OutMyFocus/HomeLab/README.md

# HomeLab

Home projects.

- [`mtg-sorter/`](mtg-sorter/) — MTG card scanner and sorter
