OutMyFocus/HomeLab/mtg-sorter/hardware/img/enclosure_back.png

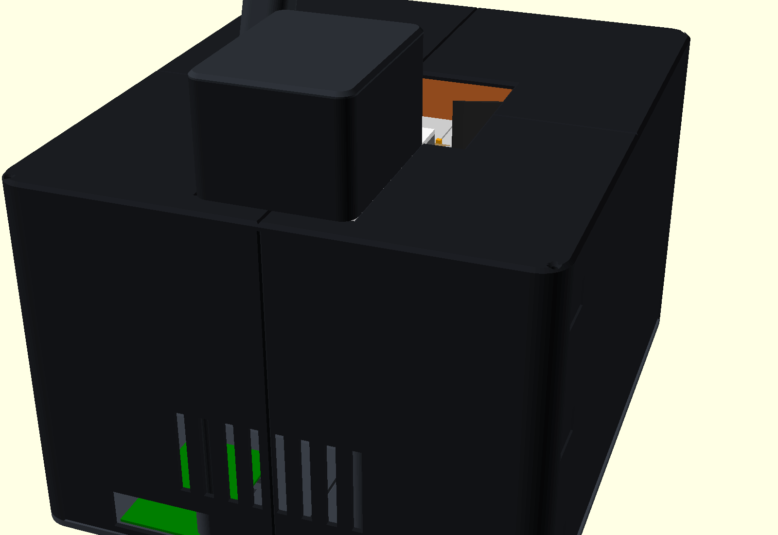
mtg-sorter/hardware/img/enclosure_back.png
