OutMyFocus/HomeLab/mtg-sorter/Card_Catalog_v1.2_All-in-one.3mf

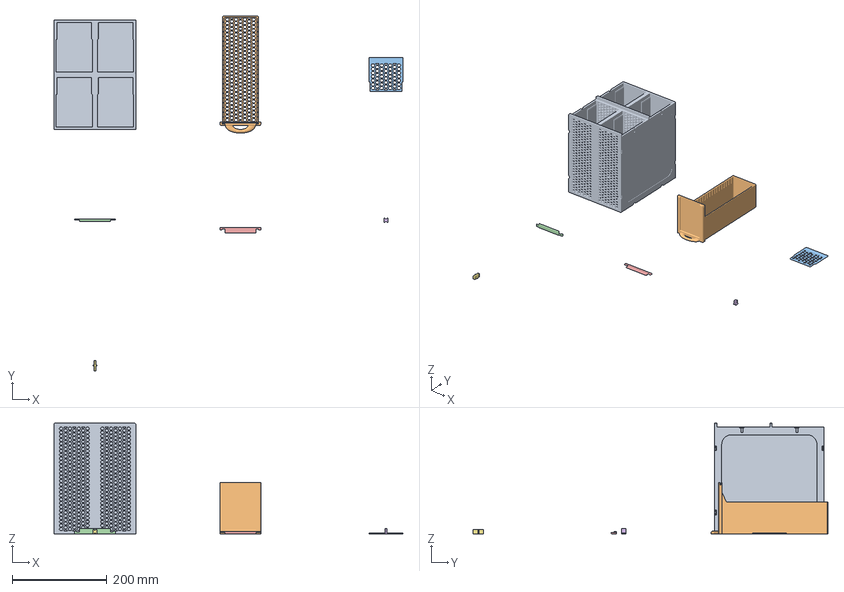
[picture p47: CAD file, 2026-11-01]
mtg-sorter/Card_Catalog_v1.2_All-in-one.3mf
736.9 x 748.8 x 234.1 mm
Card Catalog v1.0 box quad.stl
Card Catalog v1.2 drawer TEST.stl
Card Catalog v1.1 divider.stl
Card Catalog v1.1 drawer top.stl x 2
Card Catalog v1.0 connector thin.stl
Card Catalog v1.0 connector b2b thin.stl
