OutMyFocus/HomeLab/mtg-sorter/hardware/bambu/MTG_Sorter_Mk2.3mf

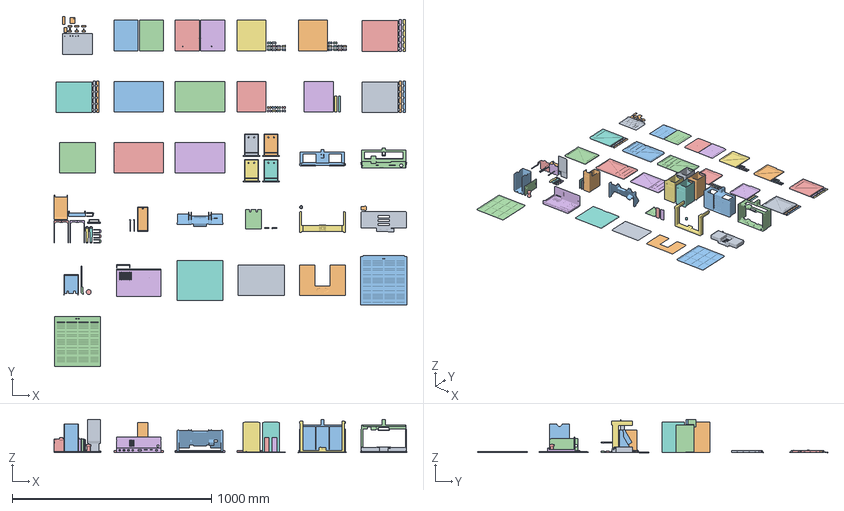
[picture p48: CAD file, 2026-11-10]
mtg-sorter/hardware/bambu/MTG_Sorter_Mk2.3mf
1769.3 x 1756.0 x 167.7 mm
mk2_coupon_plate
mk2_coupon_pieces
mk2_base_fl
mk2_base_fr
mk2_base_bl
mk2_base_br
mk2_wall_r00
mk2_key (1) x 3
mk2_key (2) x 3
mk2_key (3) x 3
mk2_key (4) x 3
mk2_key (5) x 3
mk2_key (6) x 3
mk2_key (7) x 3
mk2_key (8) x 3
mk2_key (9) x 2
mk2_key (10) x 2
mk2_wall_r10
mk2_wall_r01
mk2_trunk_lid (1) x 3
mk2_trunk_lid (2) x 3
mk2_wall_r11
mk2_wall_r02
mk2_wall_r12
mk2_wall_l00
mk2_wall_l10
mk2_branch_lid (1)
mk2_branch_lid (2)
mk2_wall_l01
mk2_wall_l11
mk2_wall_l02
mk2_wall_l12
mk2_bin (1)
mk2_bin (2)
mk2_bin (3)
mk2_bin (4)
mk2_lv2_frame
mk2_lv1_frame
mk2_carriage1
mk2_carriage2
mk2_lever (1)
mk2_lever (2)
mk2_col_front
mk2_liner_back
mk2_stop_bar
mk2_ir_holder (1)
mk2_ir_holder (2)
mk2_ir_holder (3)
mk2_ir_holder (4)
mk2_door (1)
mk2_door (2)
mk2_drawer
mk2_scan_carrier
mk2_scan_bed
mk2_lightbar (1)
mk2_lightbar (2)
mk2_cam_arch
mk2_cam_hood
mk2_fd_stand
mk2_fd_motor_lid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
