OutMyFocus/HomeLab/mtg-sorter/hardware/mk2/stl/mk2_lv1_frame.stl

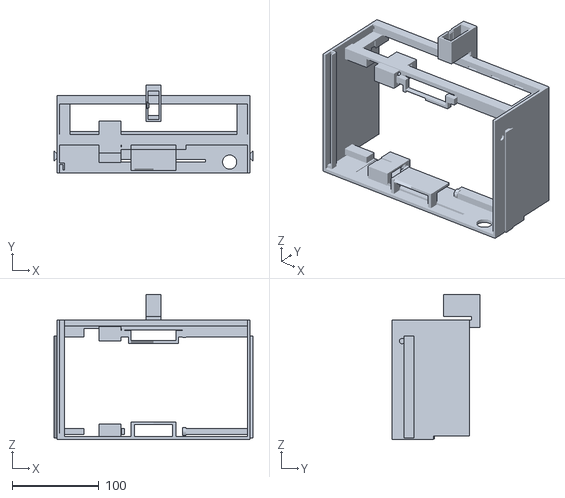
[picture p49: CAD file, 2026-11-09]
mtg-sorter/hardware/mk2/stl/mk2_lv1_frame.stl
230.0 x 101.5 x 167.7
