OutMyFocus/HomeLab/mtg-sorter/hardware/stl/enc_tower.stl

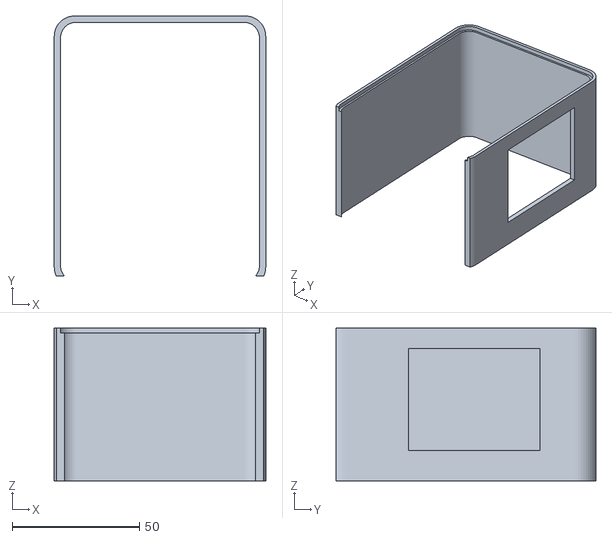
[picture p50: CAD file, 2026-11-08]
mtg-sorter/hardware/stl/enc_tower.stl
83.0 x 102.0 x 60.0
