OutMyFocus/HomeLab/mtg-sorter/hardware/bambu/MTG_Sorter_Feeder_Box_v4.3mf

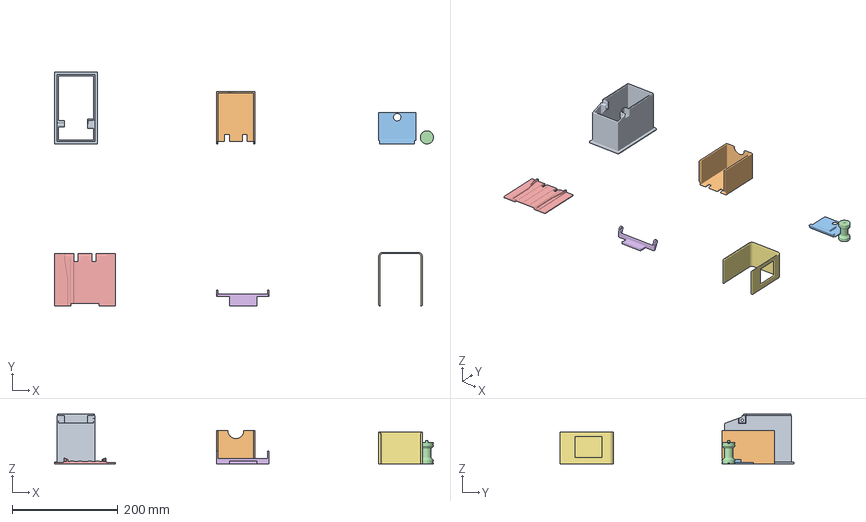
[picture p51: CAD file, 2026-11-08]
mtg-sorter/hardware/bambu/MTG_Sorter_Feeder_Box_v4.3mf
718.4 x 443.8 x 94.4 mm
feeder4_stand4
feeder4_hopper4
feeder4_shoe4
feeder4_roller4
bed_chute_bed_plate3
bed_chute_stop_gate3
enc_tower
