OutMyFocus/HomeLab/mtg-sorter/hardware/mk2/stl/mk2_coupon_plate.stl

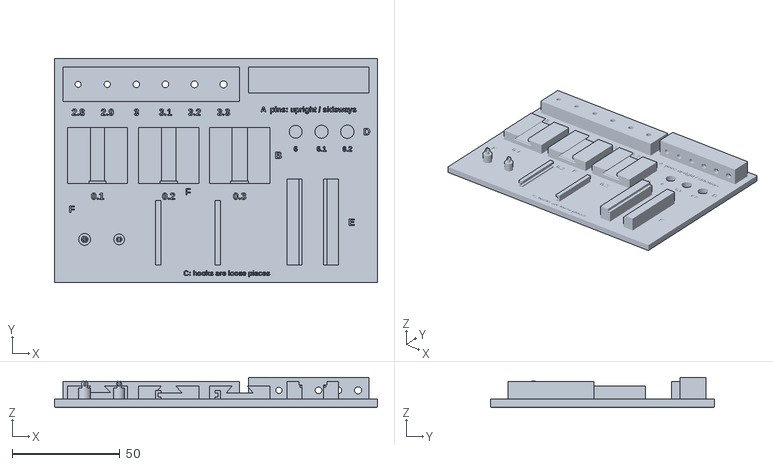
[picture p52: CAD file, 2026-11-09]
mtg-sorter/hardware/mk2/stl/mk2_coupon_plate.stl
150.0 x 104.0 x 14.0
