OutMyFocus/HomeLab/mtg-sorter/hardware/stl/feeder4_stand4.stl

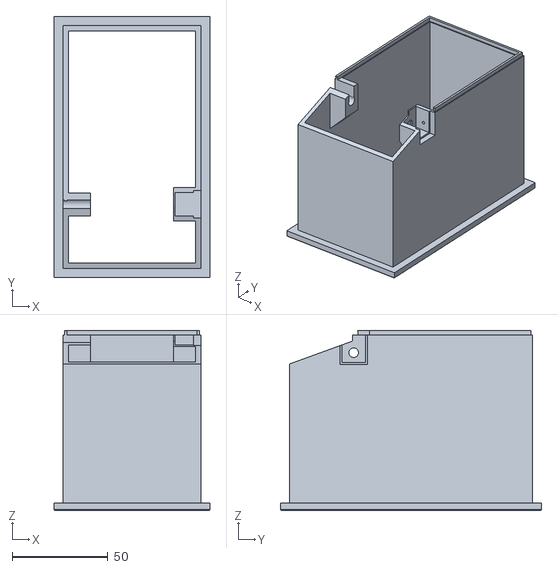
[picture p53: CAD file, 2026-11-08]
mtg-sorter/hardware/stl/feeder4_stand4.stl
81.6 x 136.6 x 94.4
