OutMyFocus/HomeLab/mtg-sorter/hardware/bambu/MTG_Sorter_Enclosure.3mf

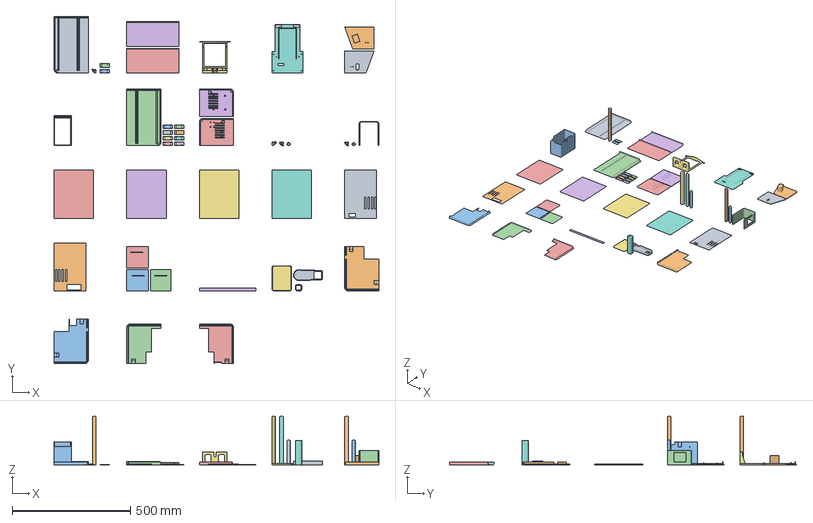
[picture p54: CAD file, 2026-11-08]
mtg-sorter/hardware/bambu/MTG_Sorter_Enclosure.3mf
1374.5 x 1468.8 x 206.5 mm
enc_floor_fl
enc_post_front
enc_splice (1) x 2
enc_splice (2) x 2
enc_divider (1)
enc_divider (2)
enc_bridge_front
enc_bridge_back
bed_chute_bed_side_left_enclosure
bed_chute_bed_side_right_enclosure
feeder_stand_mid
enc_floor_fr
enc_splice (3)
enc_splice (4)
enc_splice (5)
enc_splice (6)
enc_splice (7)
enc_splice (8)
enc_floor_bl
enc_floor_br
enc_post_front_r
enc_post_back x 2
enc_leg x 2
enc_tower
enc_side x 4
enc_back_l
enc_back_r
enc_fascia_l
enc_fascia_m
enc_fascia_r
enc_light_bar
enc_tower_lid
enc_post_sleeve
enc_head_cover
enc_deck_fl
enc_deck_fr
enc_deck_bl
enc_deck_br
