OutMyFocus/HomeLab/mtg-sorter/hardware/mk2/stl/mk2_etray.stl

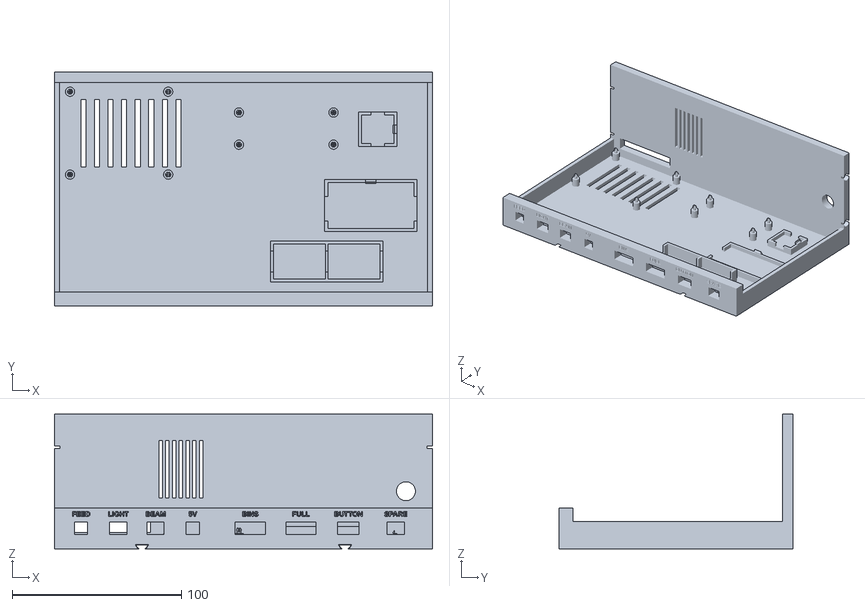
[picture p55: CAD file, 2026-11-09]
mtg-sorter/hardware/mk2/stl/mk2_etray.stl
223.4 x 138.0 x 79.5
