OutMyFocus/HomeLab/mtg-sorter/hardware/stl/feeder4_hopper4.stl

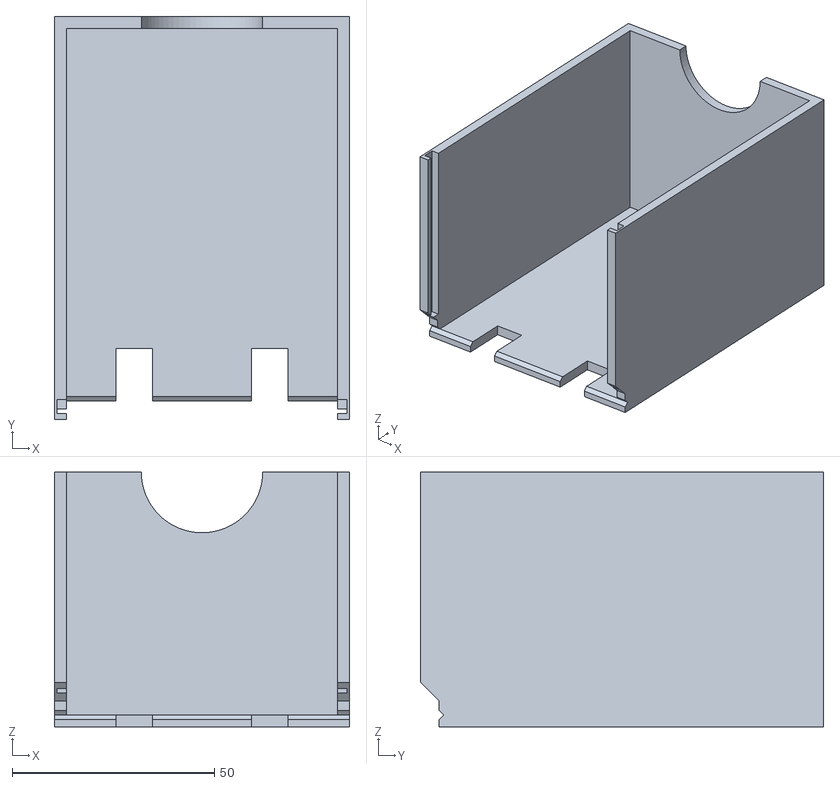
[picture p56: CAD file, 2026-11-08]
mtg-sorter/hardware/stl/feeder4_hopper4.stl
73.0 x 99.6 x 63.0
