OutMyFocus/HomeLab/mtg-sorter/hardware/bambu/MTG_Sorter_Scan_Bed_v3.3mf

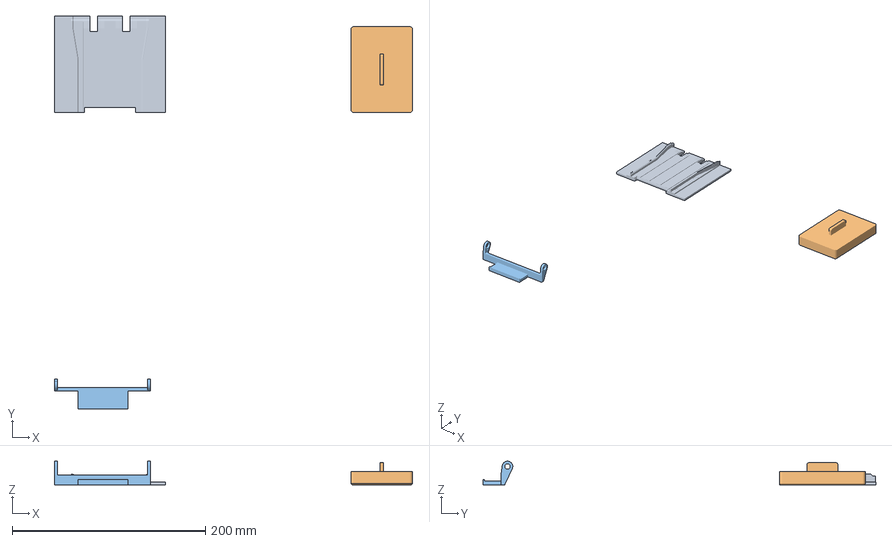
[picture p57: CAD file, 2026-11-08]
mtg-sorter/hardware/bambu/MTG_Sorter_Scan_Bed_v3.3mf
371.2 x 407.2 x 24.5 mm
bed_chute_bed_plate3
feeder_weight_solid
bed_chute_stop_gate3
