OutMyFocus/HomeLab/mtg-sorter/hardware/mk2/stl/mk2_fd_stand.stl

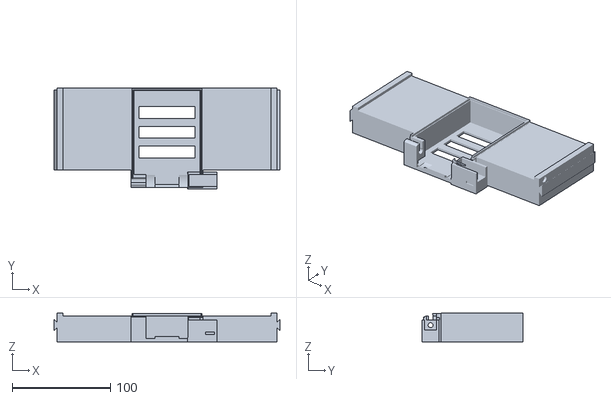
[picture p58: CAD file, 2026-11-09]
mtg-sorter/hardware/mk2/stl/mk2_fd_stand.stl
230.0 x 102.7 x 29.2
