OutMyFocus/HomeLab/mtg-sorter/hardware/stl/feeder4_shoe4.stl

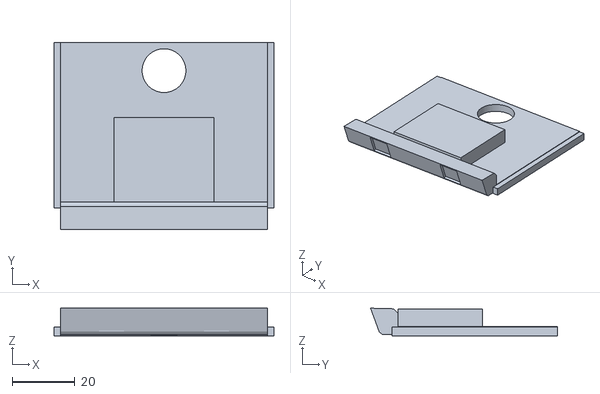
[picture p59: CAD file, 2026-11-08]
mtg-sorter/hardware/stl/feeder4_shoe4.stl
70.4 x 59.8 x 8.86
