OutMyFocus/HomeLab/mtg-sorter/hardware/bambu/MTG_Sorter_DC_Jack_Holder.3mf

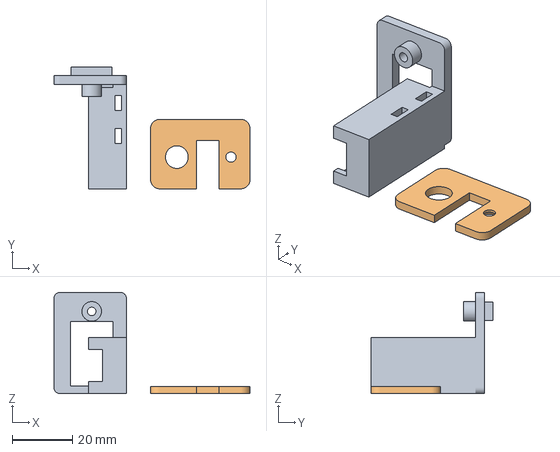
[picture p60: CAD file, 2026-11-06]
mtg-sorter/hardware/bambu/MTG_Sorter_DC_Jack_Holder.3mf
65.0 x 40.3 x 33.5 mm
dc_jack_holder
dc_jack_bezel
