OutMyFocus/HomeLab/mtg-sorter/hardware/mk2/stl/mk2_lv2_frame.stl

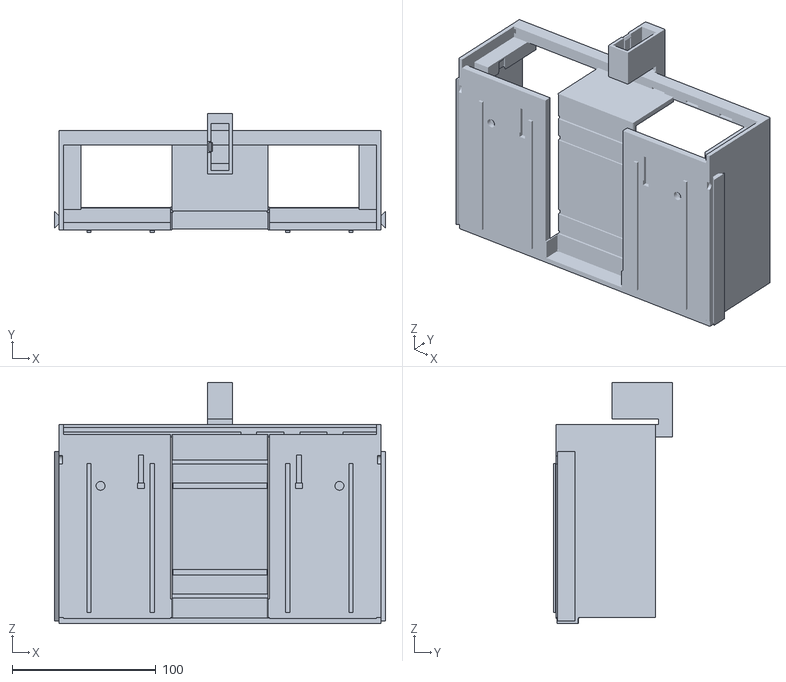
[picture p61: CAD file, 2026-11-09]
mtg-sorter/hardware/mk2/stl/mk2_lv2_frame.stl
230.0 x 83.0 x 167.7
