OutMyFocus/HomeLab/mtg-sorter/hardware/stl/bed_chute_stop_gate3.stl

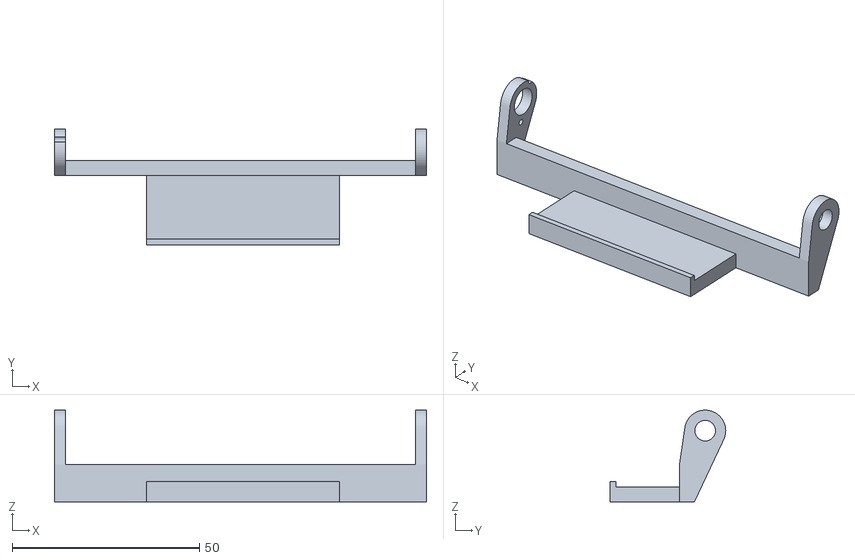
[picture p62: CAD file, 2026-11-08]
mtg-sorter/hardware/stl/bed_chute_stop_gate3.stl
99.4 x 30.9 x 24.5
