OutMyFocus/HomeLab/mtg-sorter/hardware/bambu/MTG_Sorter_Chute_v3.3mf

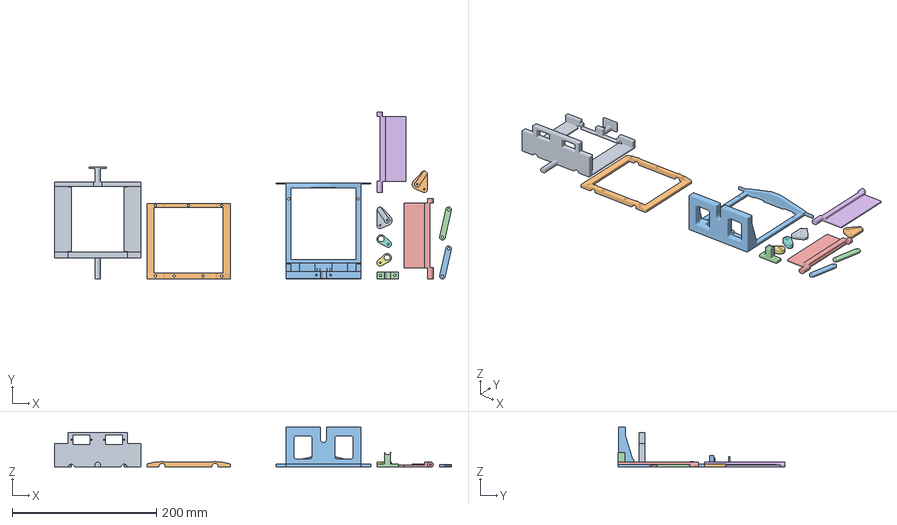
[picture p63: CAD file, 2026-11-04]
mtg-sorter/hardware/bambu/MTG_Sorter_Chute_v3.3mf
550.8 x 231.7 x 55.0 mm
bed_chute_chute3
bed_chute_hinge_frame3
enc_bridge_front
enc_bridge_cap
bed_chute_door3
bed_chute_door3_left
bed_chute_door_crank3
bed_chute_door_crank3_left
bed_chute_servo_crank3
bed_chute_servo_crank3_left
bed_chute_door_link3 (1)
bed_chute_door_link3 (2)
