OutMyFocus/HomeLab/mtg-sorter/hardware/mk2/stl/mk2_fd_hopper.stl

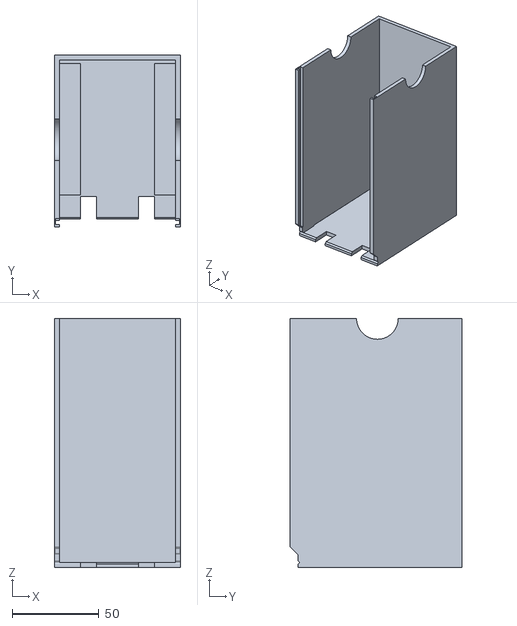
[picture p64: CAD file, 2026-11-09]
mtg-sorter/hardware/mk2/stl/mk2_fd_hopper.stl
73.0 x 99.6 x 143.9
