OutMyFocus/HomeLab/mtg-sorter/hardware/stl/feeder4_roller4.stl

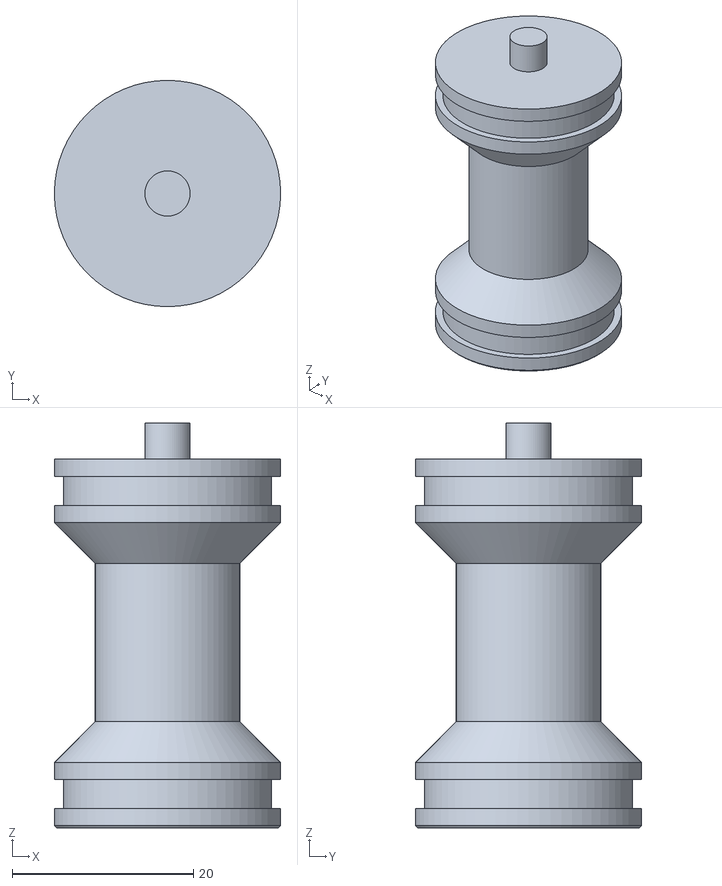
[picture p65: CAD file, 2026-11-08]
mtg-sorter/hardware/stl/feeder4_roller4.stl
25.0 x 25.0 x 44.8
