OutMyFocus/HomeLab/mtg-sorter/hardware/bambu/MTG_Sorter_Feeder_And_Bed_v2.3mf

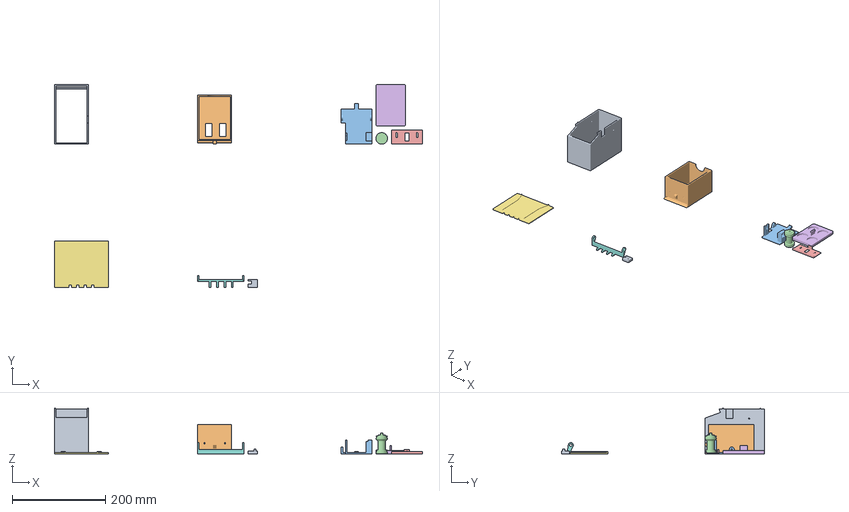
[picture p66: CAD file, 2026-11-04]
mtg-sorter/hardware/bambu/MTG_Sorter_Feeder_And_Bed_v2.3mf
789.4 x 435.2 x 98.5 mm
feeder_stand_mid
feeder_hopper
feeder_arm
feeder_roller
feeder_gate
feeder_weight
bed_chute_bed_plate
bed_chute_stop_gate
bed_chute_gate_bearing
