OutMyFocus/HomeLab/mtg-sorter/hardware/mk2/stl/mk2_drawer.stl

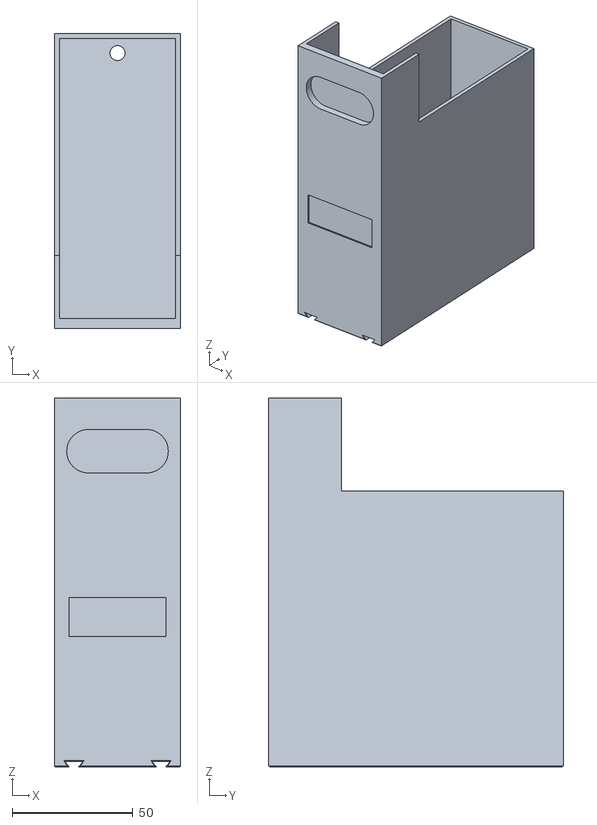
[picture p67: CAD file, 2026-11-09]
mtg-sorter/hardware/mk2/stl/mk2_drawer.stl
52.1 x 121.8 x 152.5
