OutMyFocus/HomeLab/mtg-sorter/hardware/stl/bed_chute_bed_plate3.stl

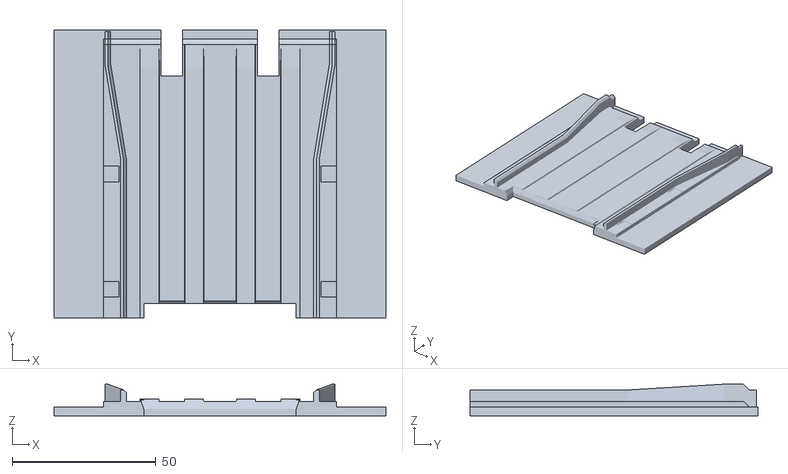
[picture p68: CAD file, 2026-11-08]
mtg-sorter/hardware/stl/bed_chute_bed_plate3.stl
115.4 x 100.0 x 11.0
