OutMyFocus/HomeLab/mtg-sorter/hardware/mk2/stl/mk2_wall_l11.stl

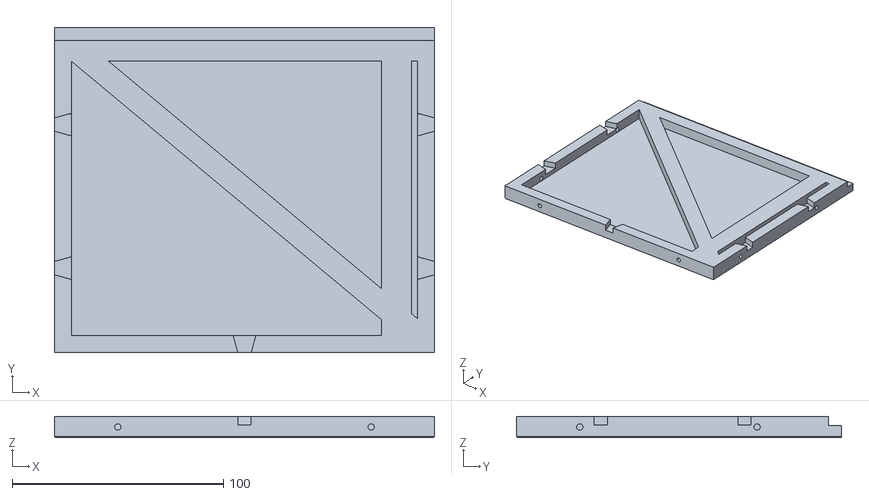
[picture p69: CAD file, 2026-11-09]
mtg-sorter/hardware/mk2/stl/mk2_wall_l11.stl
180.0 x 154.0 x 10.0
