OutMyFocus/HomeLab/mtg-sorter/hardware/stl/feeder_weight_solid.stl

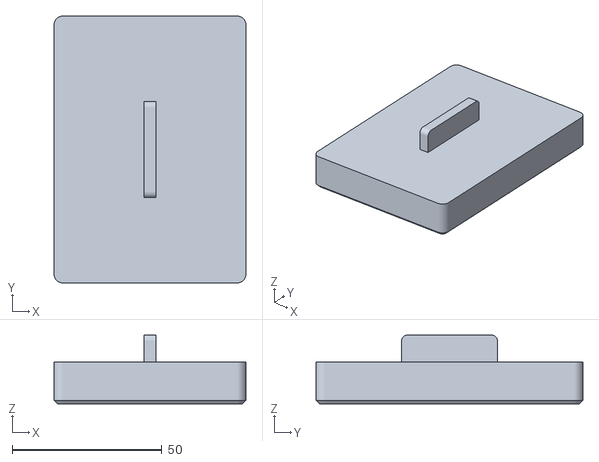
[picture p70: CAD file, 2026-11-07]
mtg-sorter/hardware/stl/feeder_weight_solid.stl
64.0 x 89.0 x 23.0
