OutMyFocus/HomeLab/mtg-sorter/hardware/stl/dc_jack_holder.stl

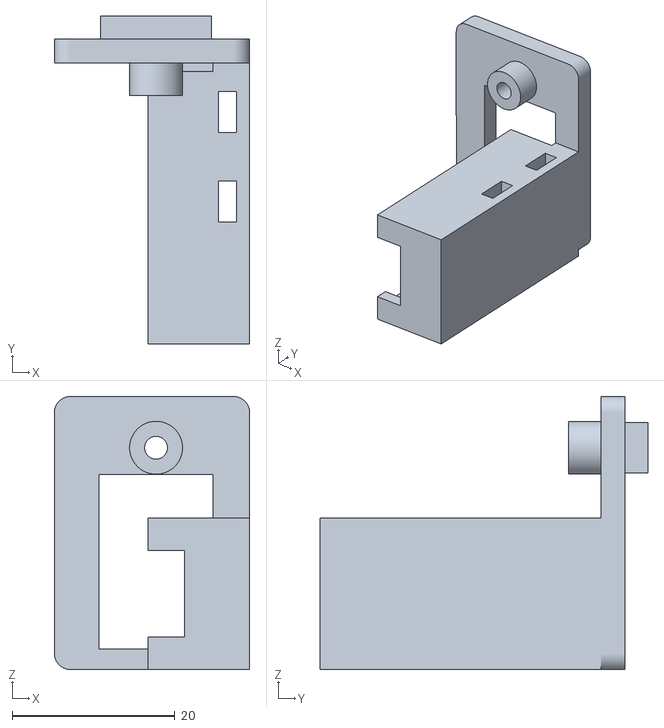
[picture p71: CAD file, 2026-11-06]
mtg-sorter/hardware/stl/dc_jack_holder.stl
24.0 x 40.3 x 33.5
