OutMyFocus/HomeLab/mtg-sorter/hardware/stl/dc_jack_bezel.stl

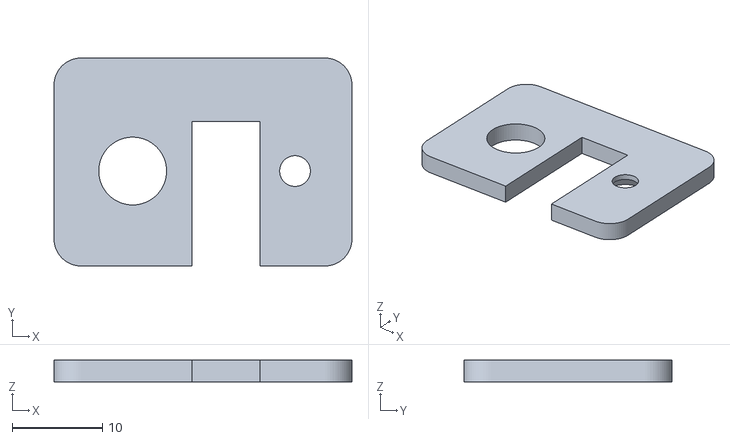
[picture p73: CAD file, 2026-11-06]
mtg-sorter/hardware/stl/dc_jack_bezel.stl
32.9 x 23.0 x 2.40
