OutMyFocus/HomeLab/mtg-sorter/hardware/stl/bed_chute_door_crank3.stl

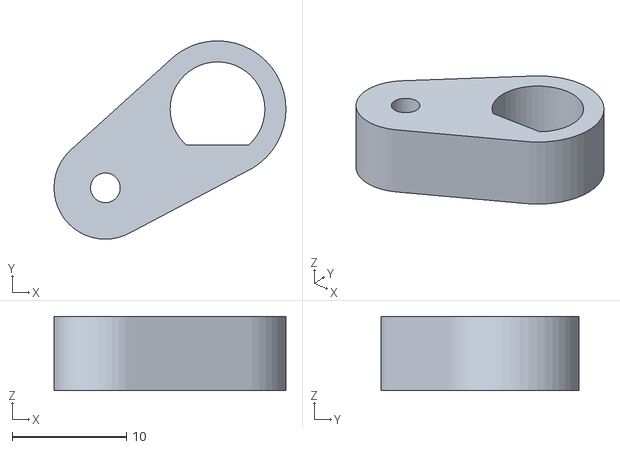
[picture p75: CAD file, 2026-11-04]
mtg-sorter/hardware/stl/bed_chute_door_crank3.stl
20.3 x 17.4 x 6.50
