OutMyFocus/HomeLab/mtg-sorter/hardware/stl/bed_chute_bed_plate.stl

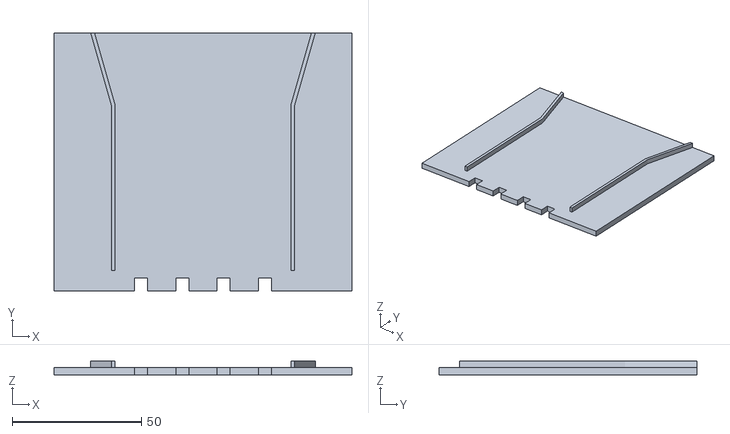
[picture p76: CAD file, 2026-11-04]
mtg-sorter/hardware/stl/bed_chute_bed_plate.stl
115.4 x 100.0 x 5.50
