OutMyFocus/HomeLab/mtg-sorter/hardware/mk2/stl/mk2_fd_motor_lid.stl

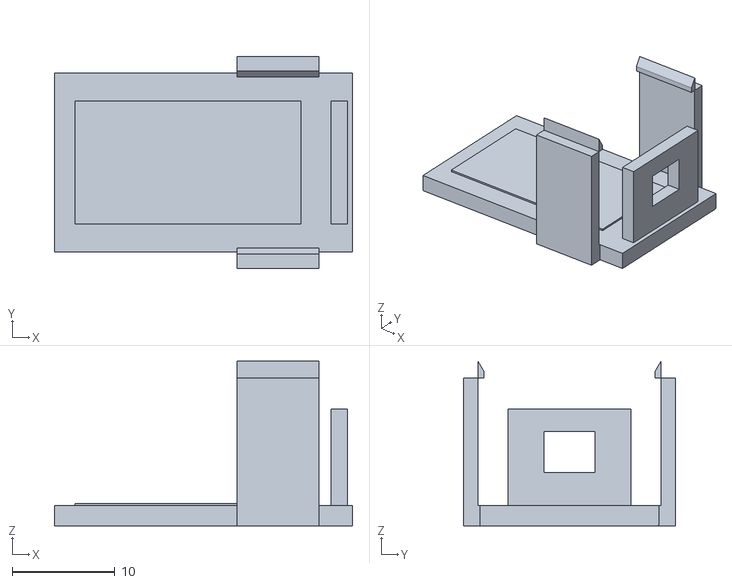
[picture p77: CAD file, 2026-11-09]
mtg-sorter/hardware/mk2/stl/mk2_fd_motor_lid.stl
29.0 x 20.6 x 16.0
