OutMyFocus/HomeLab/mtg-sorter/hardware/mk2/stl/mk2_col_front.stl

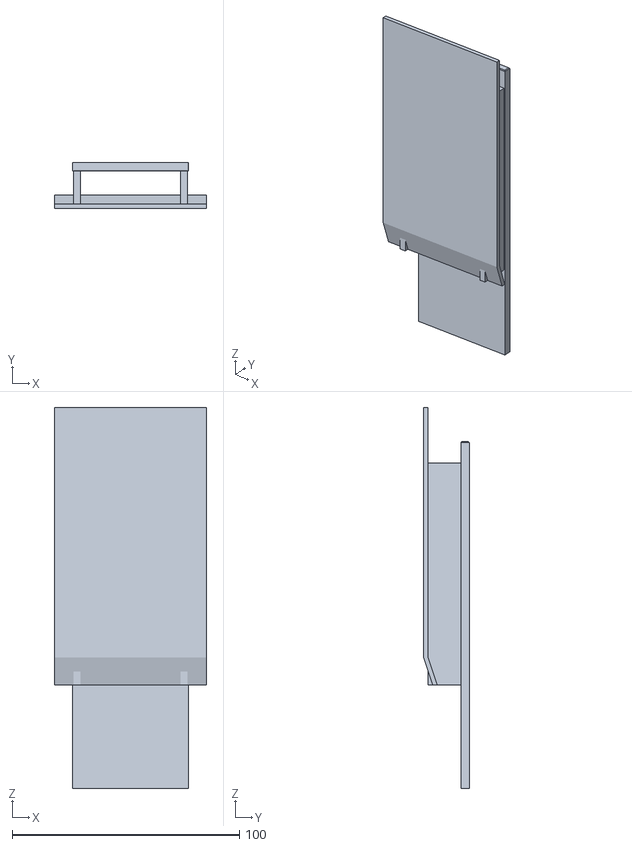
[picture p78: CAD file, 2026-11-09]
mtg-sorter/hardware/mk2/stl/mk2_col_front.stl
67.0 x 20.2 x 167.5
