OutMyFocus/HomeLab/mtg-sorter/hardware/stl/feeder_gate.stl

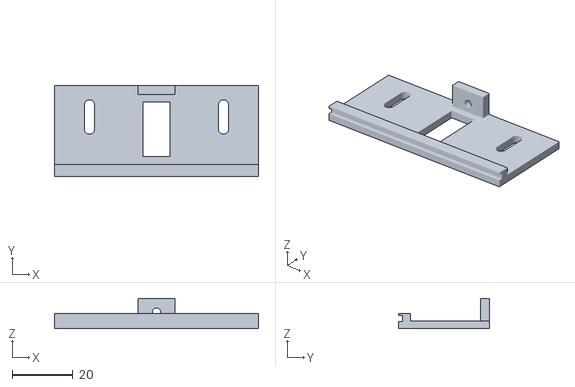
[picture p79: CAD file, 2026-11-04]
mtg-sorter/hardware/stl/feeder_gate.stl
67.0 x 30.0 x 10.0
