OutMyFocus/HomeLab/mtg-sorter/hardware/mk2/stl/mk2_fd_shoe.stl

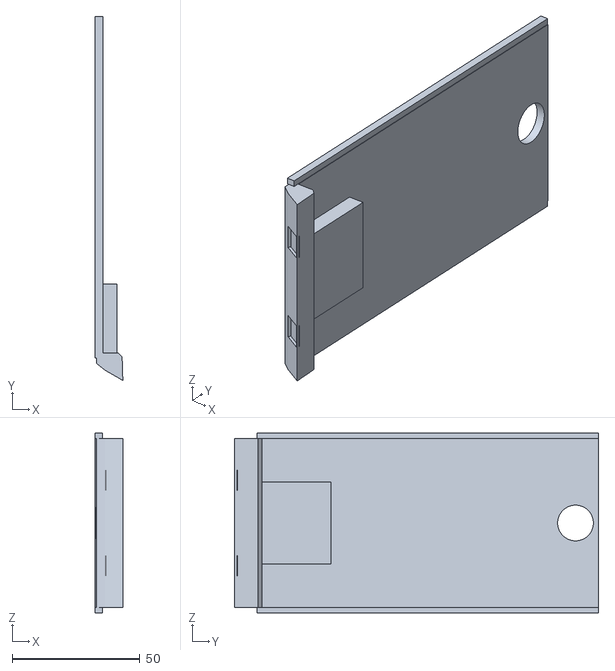
[picture p80: CAD file, 2026-11-09]
mtg-sorter/hardware/mk2/stl/mk2_fd_shoe.stl
10.9 x 142.6 x 70.4
