OutMyFocus/HomeLab/mtg-sorter/hardware/stl/feeder_roller.stl

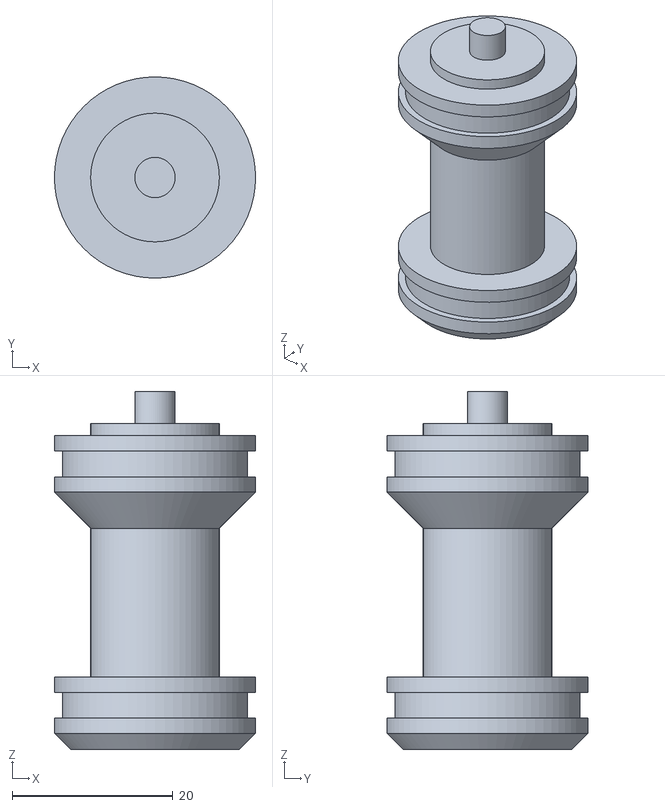
[picture p81: CAD file, 2026-11-04]
mtg-sorter/hardware/stl/feeder_roller.stl
25.0 x 25.0 x 44.5
