OutMyFocus/HomeLab/mtg-sorter/hardware/mk2/stl/mk2_back_high.stl

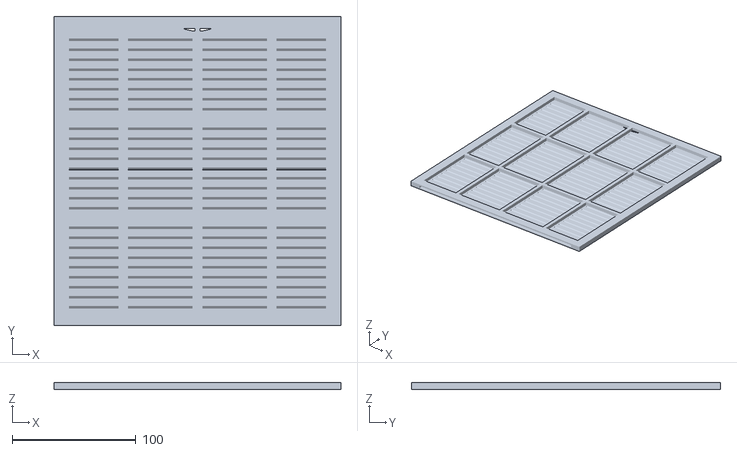
[picture p82: CAD file, 2026-11-09]
mtg-sorter/hardware/mk2/stl/mk2_back_high.stl
232.0 x 250.0 x 5.70
