OutMyFocus/HomeLab/mtg-sorter/hardware/stl/bed_chute_door_link3.stl

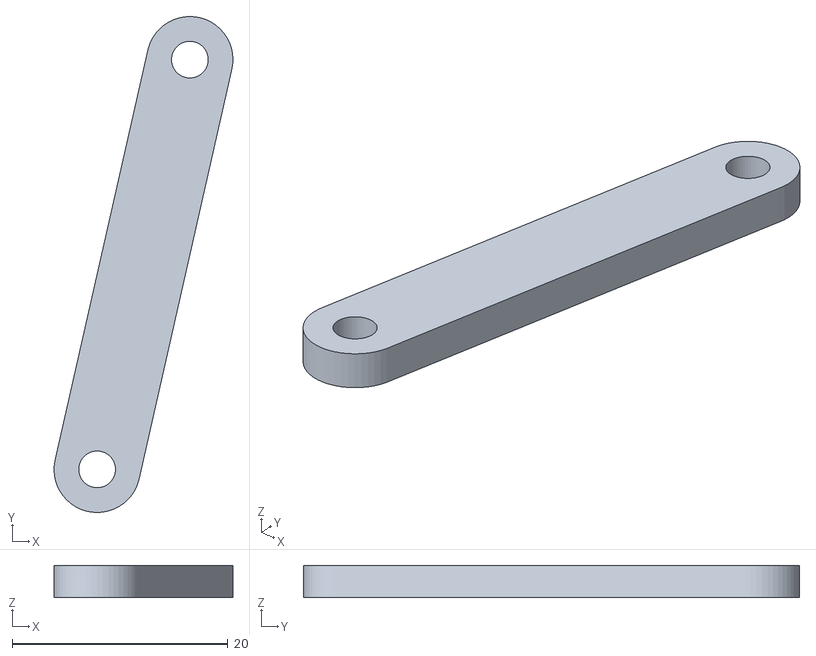
[picture p83: CAD file, 2026-11-04]
mtg-sorter/hardware/stl/bed_chute_door_link3.stl
16.6 x 46.0 x 3.00
