OutMyFocus/HomeLab/mtg-sorter/hardware/mk2/stl/mk2_base_fl.stl

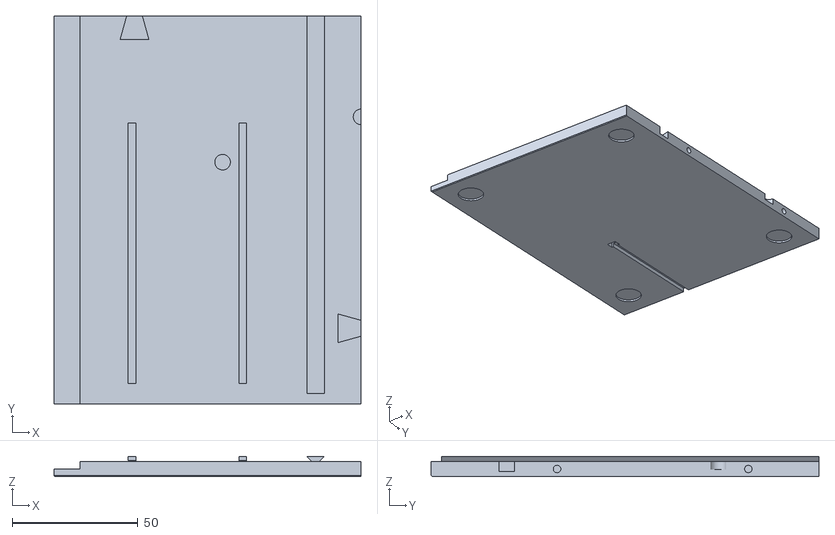
[picture p84: CAD file, 2026-11-09]
mtg-sorter/hardware/mk2/stl/mk2_base_fl.stl
122.0 x 154.0 x 7.99
