OutMyFocus/HomeLab/mtg-sorter/hardware/stl/bed_chute_servo_crank3_left.stl

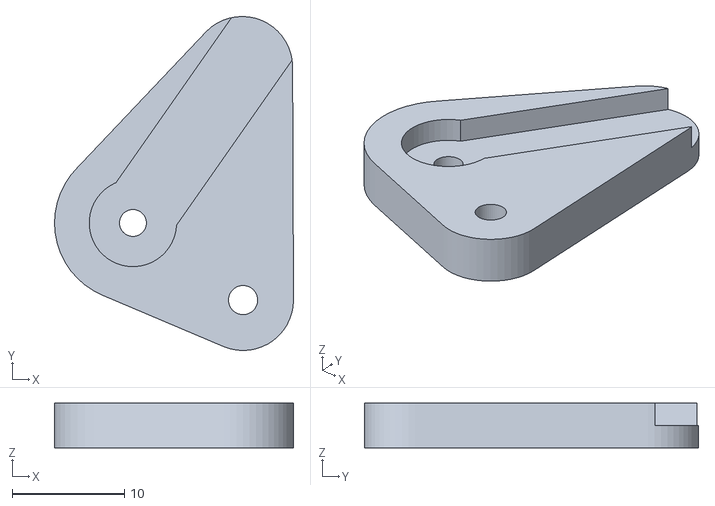
[picture p85: CAD file, 2026-11-04]
mtg-sorter/hardware/stl/bed_chute_servo_crank3_left.stl
21.3 x 29.8 x 4.00
