OutMyFocus/HomeLab/mtg-sorter/hardware/mk2/stl/mk2_scan_bed.stl

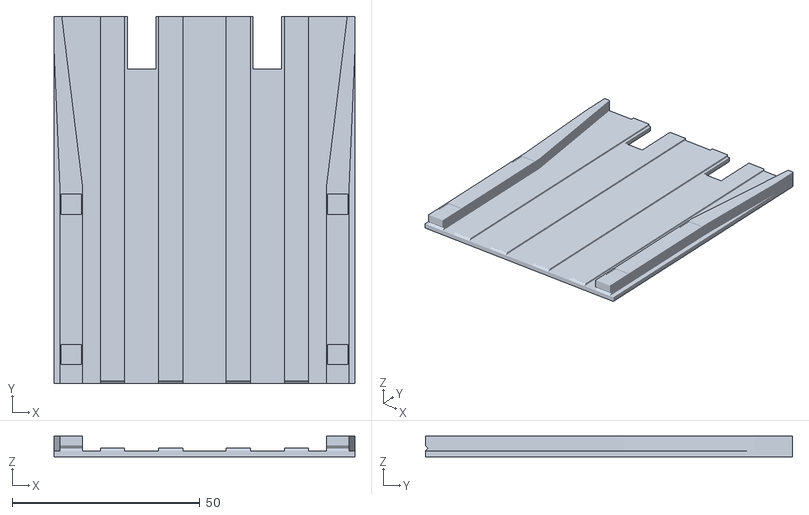
[picture p86: CAD file, 2026-11-09]
mtg-sorter/hardware/mk2/stl/mk2_scan_bed.stl
80.0 x 97.7 x 5.59
