OutMyFocus/HomeLab/mtg-sorter/hardware/stl/enc_bridge_front.stl

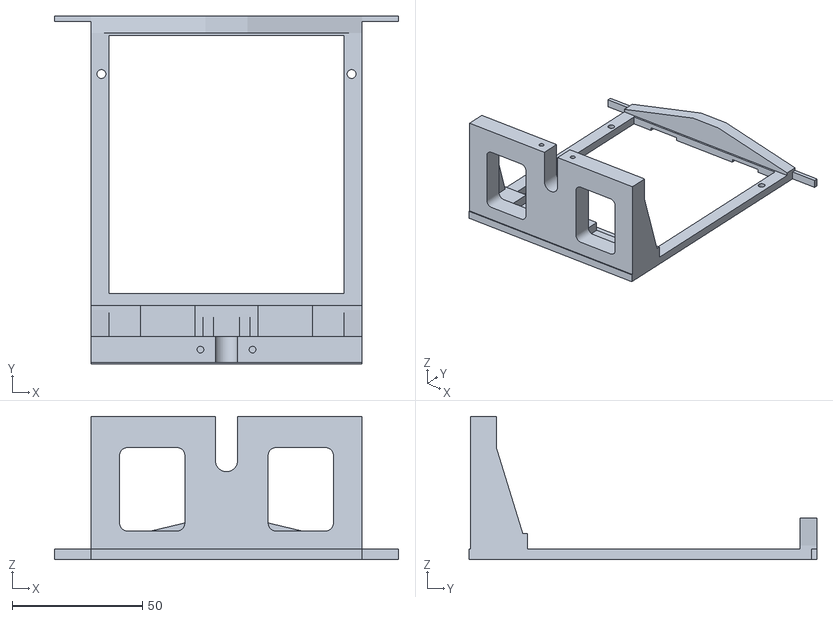
[picture p87: CAD file, 2026-11-04]
mtg-sorter/hardware/stl/enc_bridge_front.stl
132.0 x 133.5 x 55.0
