OutMyFocus/HomeLab/mtg-sorter/hardware/mk2/stl/mk2_lever.stl

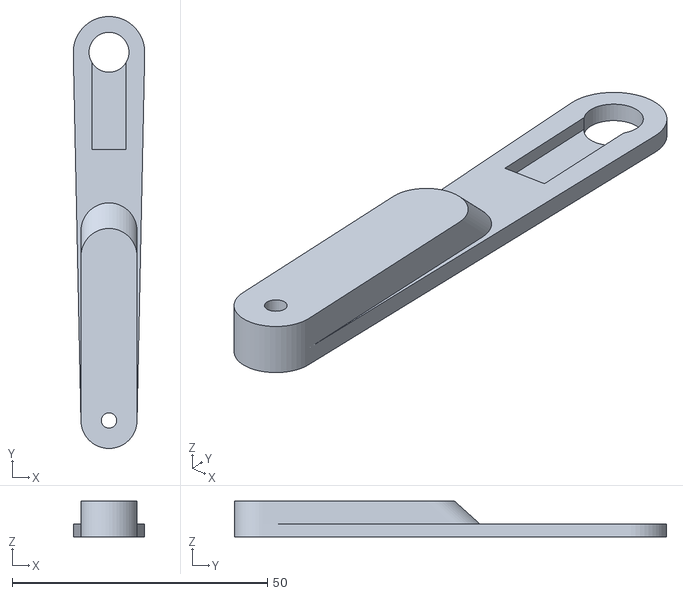
[picture p88: CAD file, 2026-11-09]
mtg-sorter/hardware/mk2/stl/mk2_lever.stl
14.0 x 84.6 x 7.00
