OutMyFocus/HomeLab/mtg-sorter/hardware/stl/feeder_stand_mid.stl

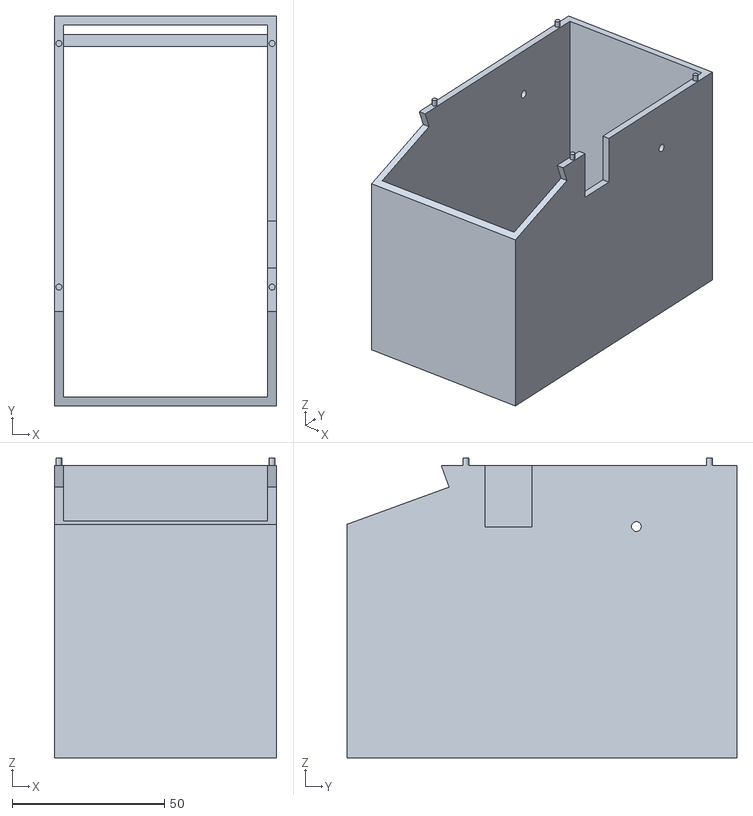
[picture p89: CAD file, 2026-11-04]
mtg-sorter/hardware/stl/feeder_stand_mid.stl
73.0 x 128.0 x 98.5
