OutMyFocus/HomeLab/mtg-sorter/hardware/mk2/stl/mk2_cam_hood.stl

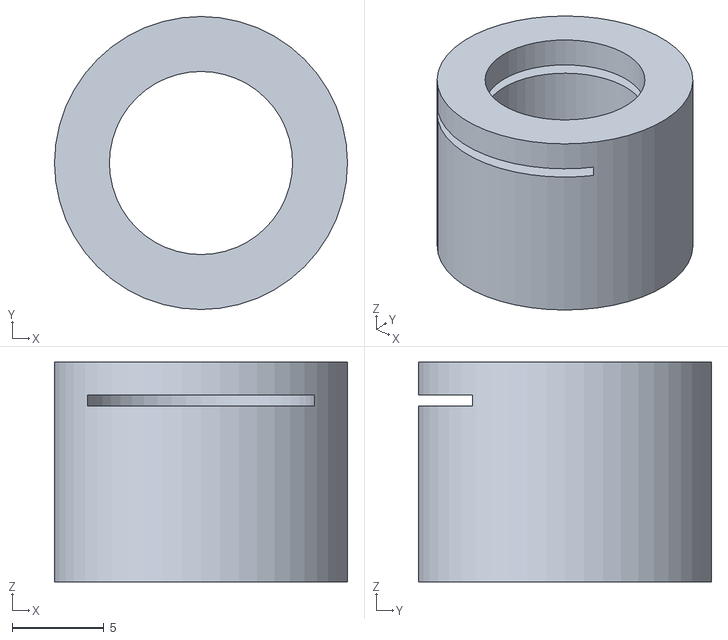
[picture p90: CAD file, 2026-11-09]
mtg-sorter/hardware/mk2/stl/mk2_cam_hood.stl
16.0 x 16.0 x 12.0
