OutMyFocus/HomeLab/mtg-sorter/hardware/stl/feeder_arm.stl

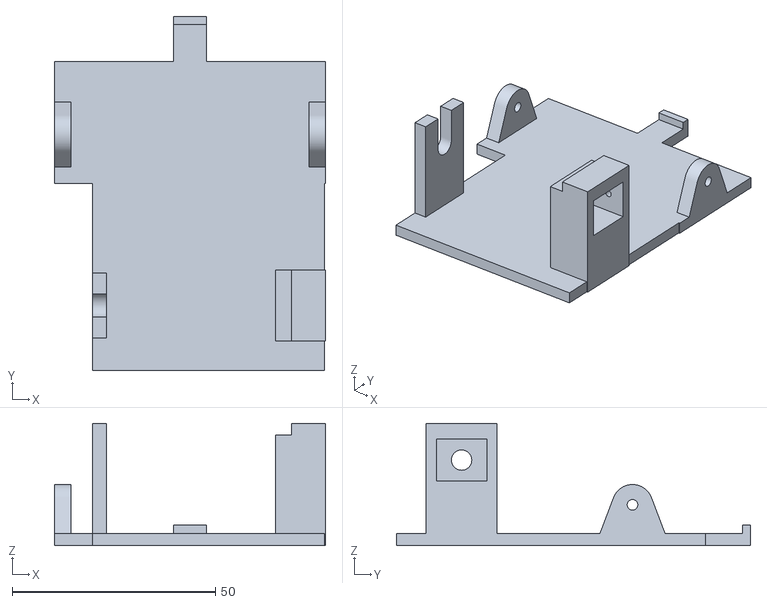
[picture p91: CAD file, 2026-11-04]
mtg-sorter/hardware/stl/feeder_arm.stl
66.6 x 87.0 x 30.0
