OutMyFocus/HomeLab/mtg-sorter/hardware/mk2/stl/mk2_bin.stl

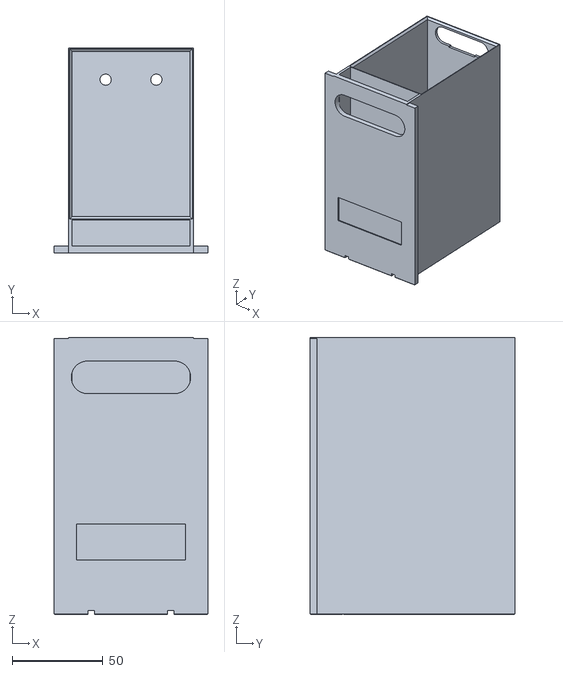
[picture p92: CAD file, 2026-11-09]
mtg-sorter/hardware/mk2/stl/mk2_bin.stl
84.9 x 113.2 x 153.0
