OutMyFocus/HomeLab/mtg-sorter/hardware/stl/bed_chute_stop_gate.stl

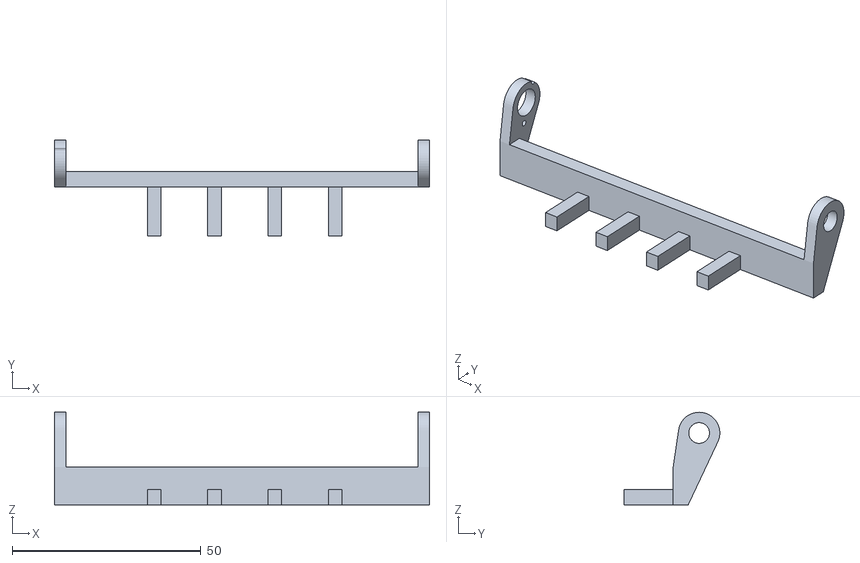
[picture p93: CAD file, 2026-11-04]
mtg-sorter/hardware/stl/bed_chute_stop_gate.stl
99.4 x 25.4 x 24.5
