OutMyFocus/HomeLab/mtg-sorter/hardware/mk2/stl/mk2_coupon_pieces.stl

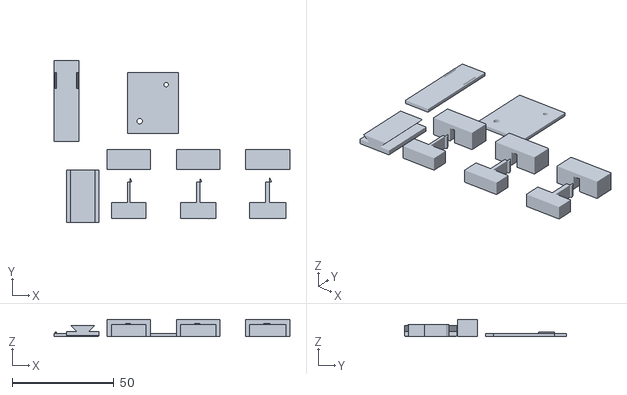
[picture p94: CAD file, 2026-11-09]
mtg-sorter/hardware/mk2/stl/mk2_coupon_pieces.stl
116.2 x 80.0 x 8.40
