OutMyFocus/HomeLab/mtg-sorter/hardware/stl/enc_leg_offset.stl

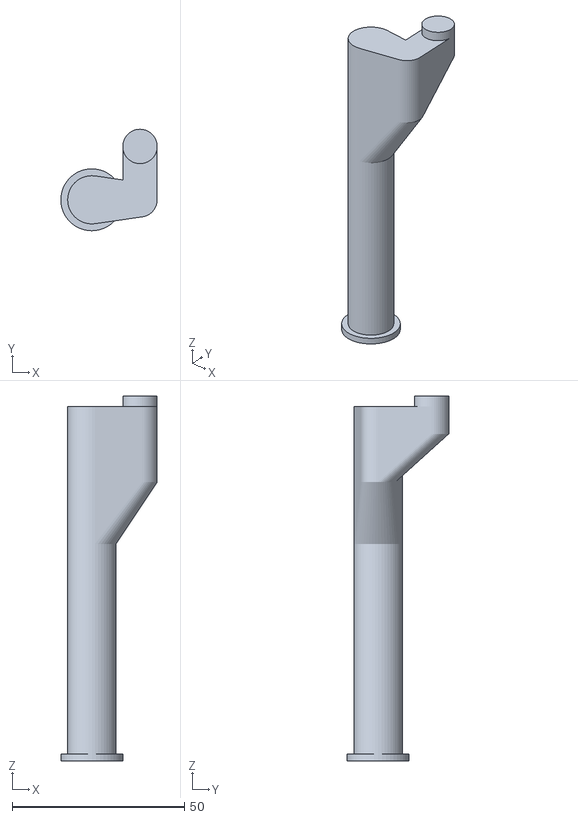
[picture p95: CAD file, 2026-11-04]
mtg-sorter/hardware/stl/enc_leg_offset.stl
28.0 x 29.5 x 106.0
