OutMyFocus/HomeLab/mtg-sorter/hardware/mk2/stl/mk2_wall_r02.stl

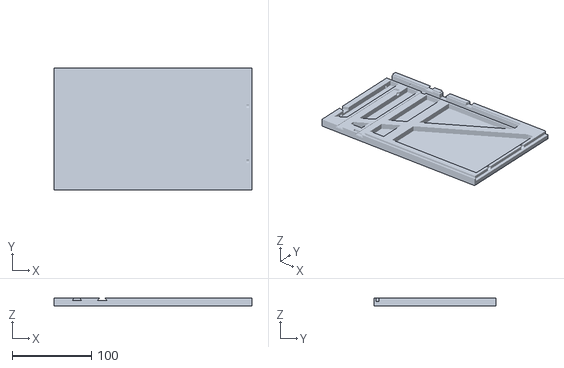
[picture p96: CAD file, 2026-11-09]
mtg-sorter/hardware/mk2/stl/mk2_wall_r02.stl
250.0 x 154.0 x 10.0
