OutMyFocus/HomeLab/mtg-sorter/hardware/stl/bed_chute_chute3.stl

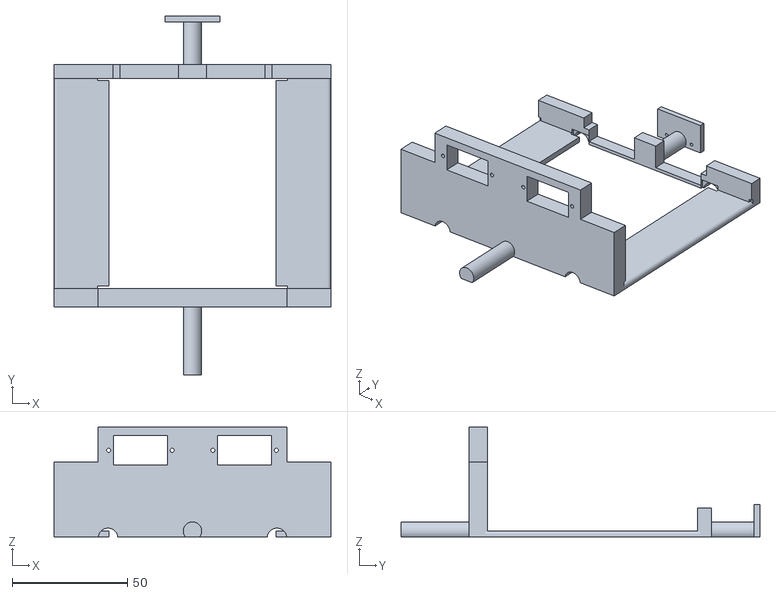
[picture p97: CAD file, 2026-11-04]
mtg-sorter/hardware/stl/bed_chute_chute3.stl
120.0 x 155.5 x 47.5
