OutMyFocus/HomeLab/mtg-sorter/hardware/mk2/stl/mk2_cam_arch.stl

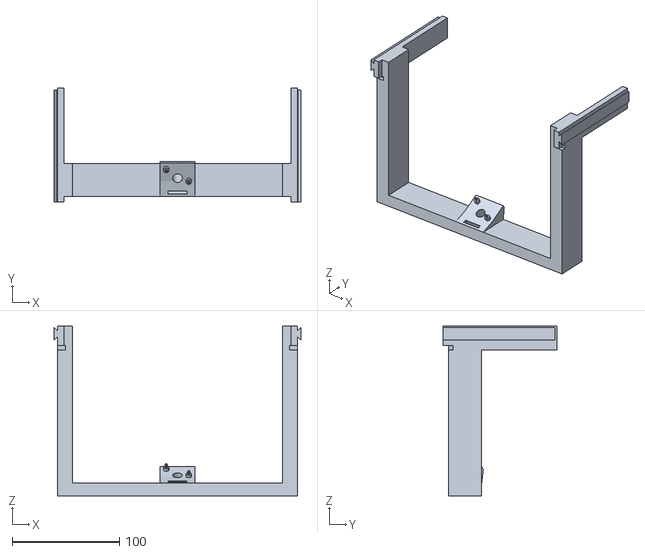
[picture p98: CAD file, 2026-11-09]
mtg-sorter/hardware/mk2/stl/mk2_cam_arch.stl
230.0 x 106.0 x 157.9
