OutMyFocus/HomeLab/mtg-sorter/hardware/mk2/stl/mk2_branch_lid.stl

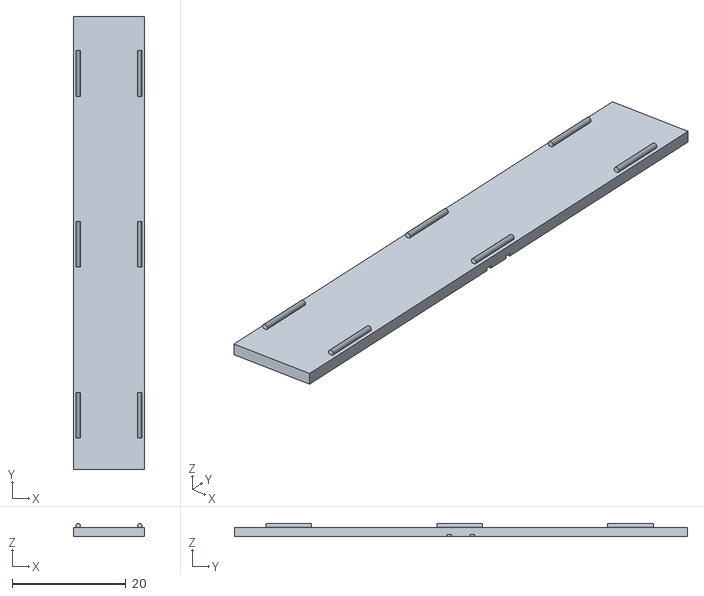
[picture p99: CAD file, 2026-11-09]
mtg-sorter/hardware/mk2/stl/mk2_branch_lid.stl
12.4 x 79.5 x 2.30
