OutMyFocus/HomeLab/mtg-sorter/hardware/stl/enc_back_r.stl

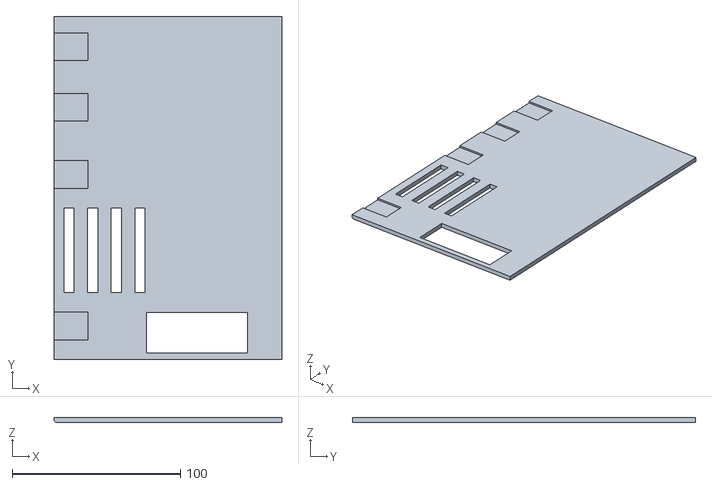
[picture p100: CAD file, 2026-11-04]
mtg-sorter/hardware/stl/enc_back_r.stl
135.4 x 204.0 x 3.00
