OutMyFocus/HomeLab/mtg-sorter/hardware/mk2/stl/mk2_wall_r10.stl

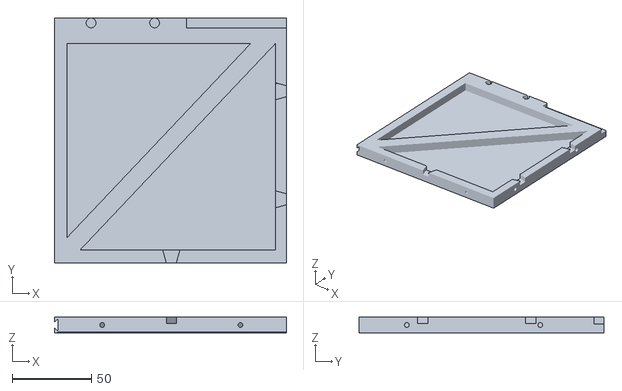
[picture p101: CAD file, 2026-11-09]
mtg-sorter/hardware/mk2/stl/mk2_wall_r10.stl
146.0 x 154.0 x 10.0
