OutMyFocus/HomeLab/mtg-sorter/hardware/stl/enc_bridge_cap.stl

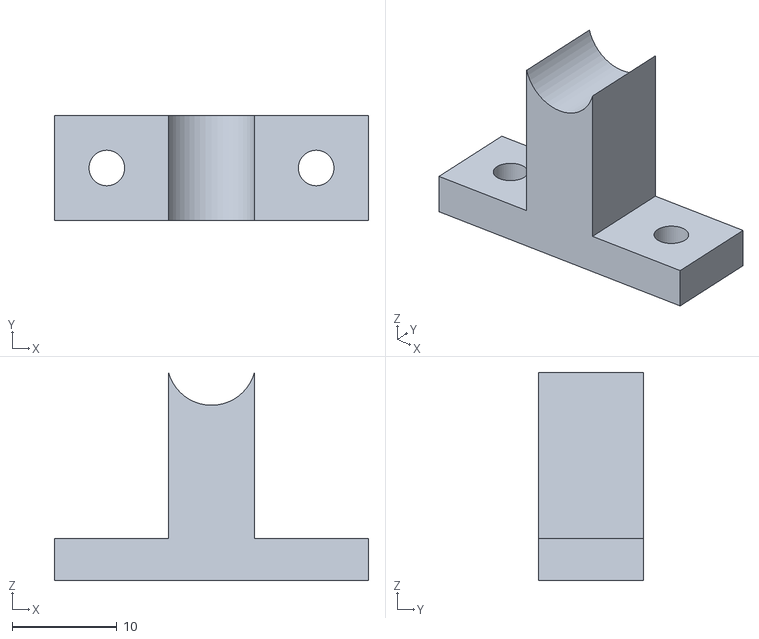
[picture p102: CAD file, 2026-11-04]
mtg-sorter/hardware/stl/enc_bridge_cap.stl
30.0 x 10.0 x 19.9
