OutMyFocus/HomeLab/mtg-sorter/hardware/mk2/stl/mk2_ir_holder.stl

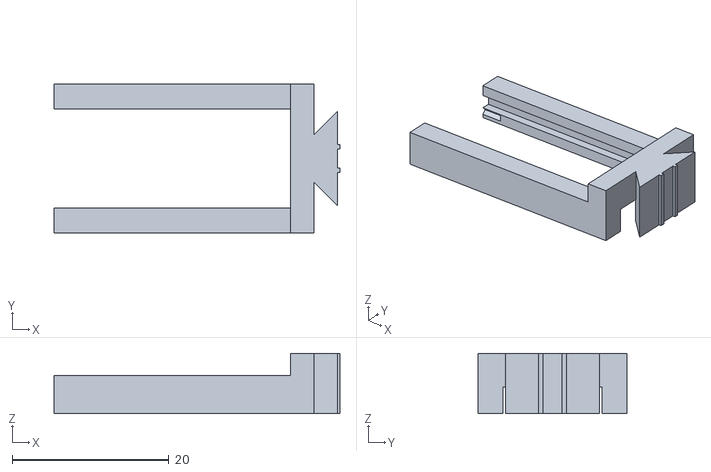
[picture p103: CAD file, 2026-11-09]
mtg-sorter/hardware/mk2/stl/mk2_ir_holder.stl
36.5 x 19.0 x 7.70
