OutMyFocus/HomeLab/mtg-sorter/hardware/stl/bed_chute_door3_left.stl

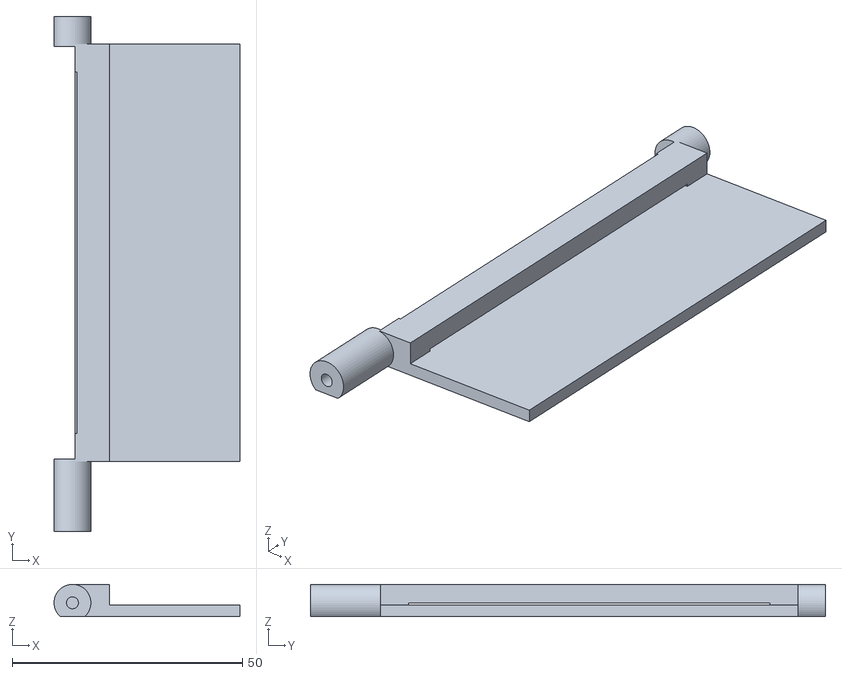
[picture p104: CAD file, 2026-11-04]
mtg-sorter/hardware/stl/bed_chute_door3_left.stl
40.3 x 111.7 x 7.00
