OutMyFocus/HomeLab/mtg-sorter/hardware/mk2/stl/mk2_trunk_lid.stl

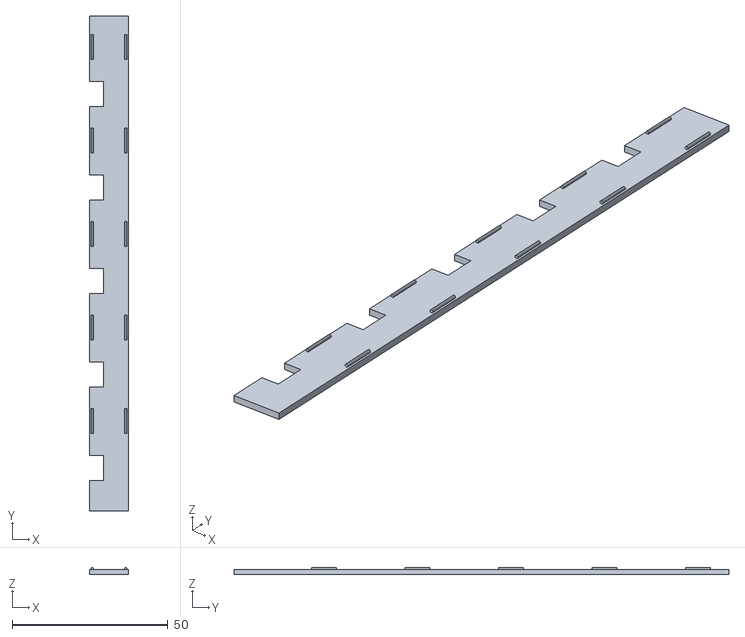
[picture p105: CAD file, 2026-11-09]
mtg-sorter/hardware/mk2/stl/mk2_trunk_lid.stl
12.4 x 158.8 x 2.30
