OutMyFocus/HomeLab/mtg-sorter/hardware/stl/enc_floor_br.stl

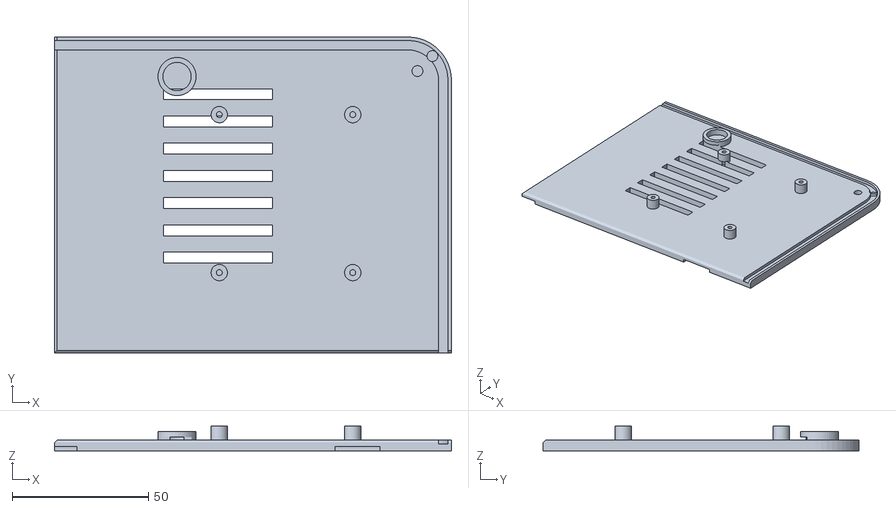
[picture p106: CAD file, 2026-11-04]
mtg-sorter/hardware/stl/enc_floor_br.stl
145.8 x 116.0 x 9.00
