OutMyFocus/HomeLab/mtg-sorter/hardware/mk2/stl/mk2_base_bl.stl

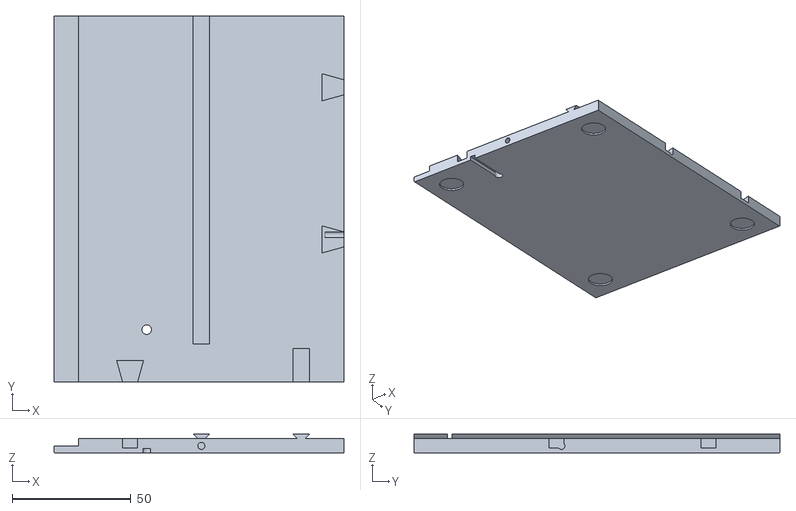
[picture p107: CAD file, 2026-11-09]
mtg-sorter/hardware/mk2/stl/mk2_base_bl.stl
122.0 x 154.0 x 7.99
