OutMyFocus/HomeLab/mtg-sorter/hardware/stl/bed_chute_hinge_frame3.stl

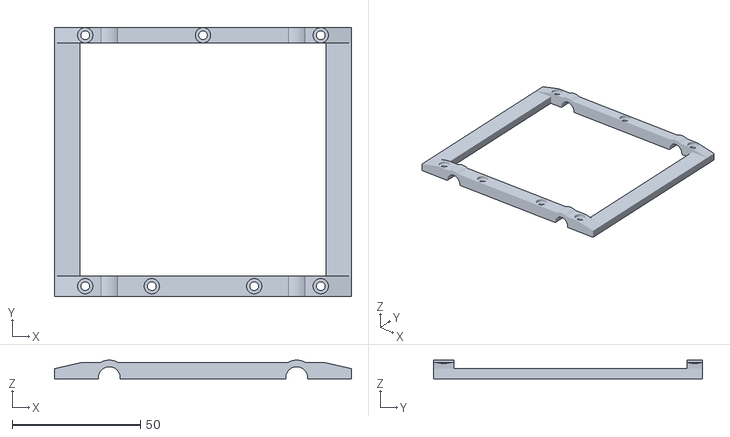
[picture p108: CAD file, 2026-11-04]
mtg-sorter/hardware/stl/bed_chute_hinge_frame3.stl
116.0 x 105.0 x 7.35
