OutMyFocus/HomeLab/mtg-sorter/hardware/stl/feeder_hopper.stl

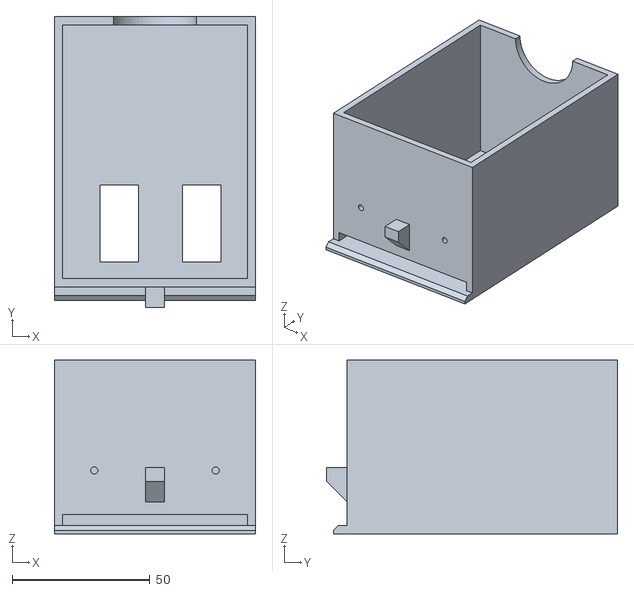
[picture p109: CAD file, 2026-11-04]
mtg-sorter/hardware/stl/feeder_hopper.stl
73.0 x 105.5 x 63.0
