OutMyFocus/HomeLab/mtg-sorter/hardware/mk2/stl/mk2_carriage2.stl

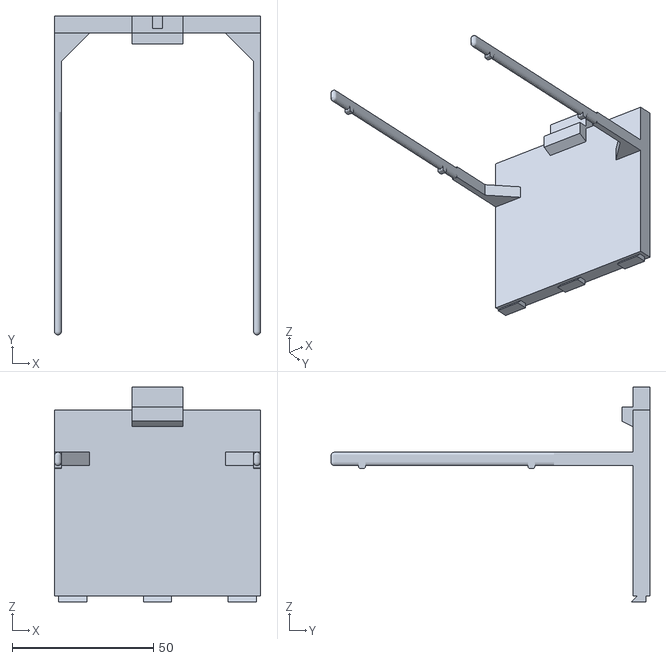
[picture p110: CAD file, 2026-11-09]
mtg-sorter/hardware/mk2/stl/mk2_carriage2.stl
73.0 x 113.0 x 76.0
