OutMyFocus/HomeLab/mtg-sorter/hardware/stl/bed_chute_bed_side_right_enclosure.stl

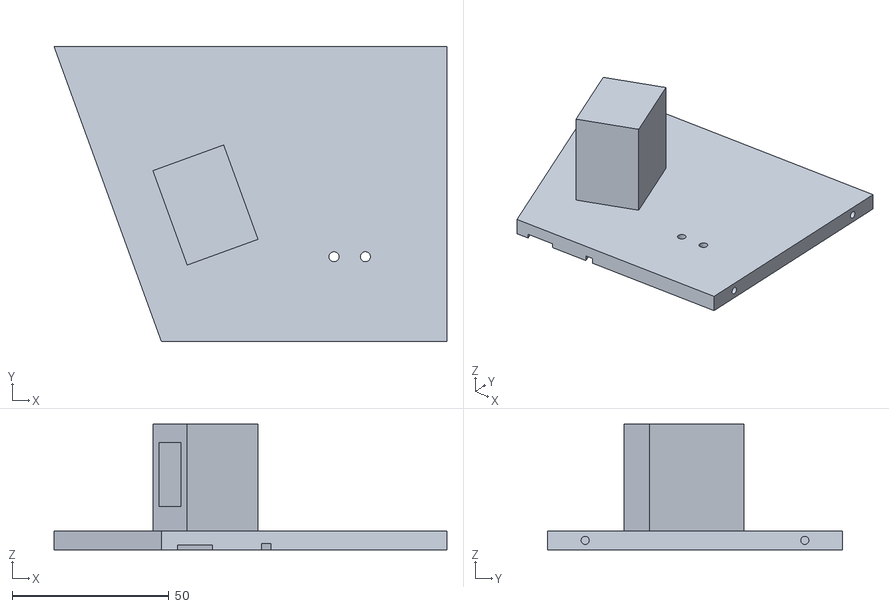
[picture p111: CAD file, 2026-11-04]
mtg-sorter/hardware/stl/bed_chute_bed_side_right_enclosure.stl
125.2 x 94.0 x 40.0
