OutMyFocus/HomeLab/mtg-sorter/hardware/mk2/stl/mk2_carriage1.stl

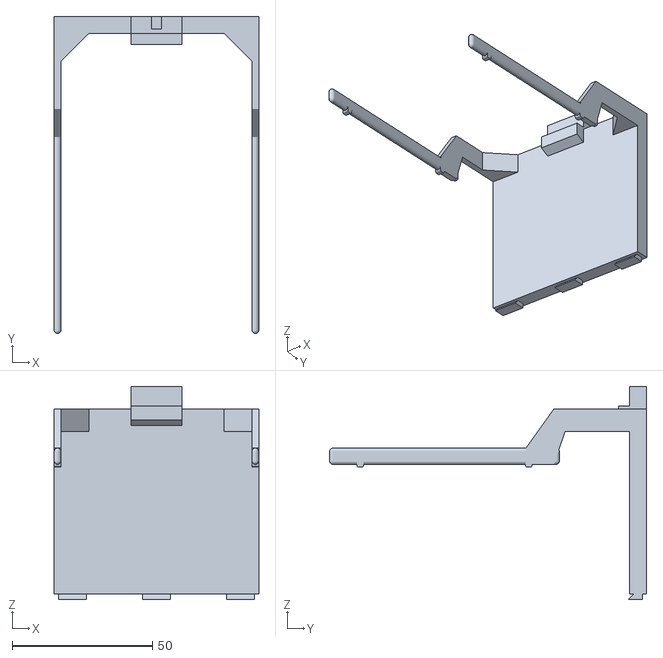
[picture p112: CAD file, 2026-11-09]
mtg-sorter/hardware/mk2/stl/mk2_carriage1.stl
73.0 x 113.0 x 76.0
