OutMyFocus/HomeLab/mtg-sorter/hardware/stl/bed_chute_gate_bearing.stl

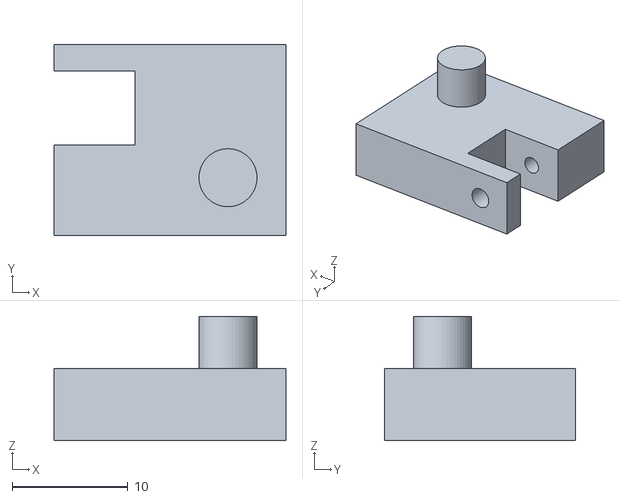
[picture p113: CAD file, 2026-11-04]
mtg-sorter/hardware/stl/bed_chute_gate_bearing.stl
20.0 x 16.5 x 10.7
