OutMyFocus/HomeLab/mtg-sorter/hardware/mk2/stl/mk2_wall_l12.stl

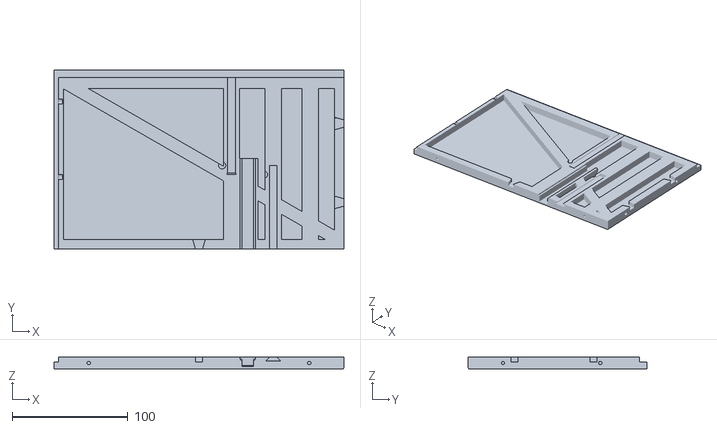
[picture p114: CAD file, 2026-11-09]
mtg-sorter/hardware/mk2/stl/mk2_wall_l12.stl
250.0 x 154.0 x 10.0
