OutMyFocus/HomeLab/mtg-sorter/hardware/stl/enc_post_front_r.stl

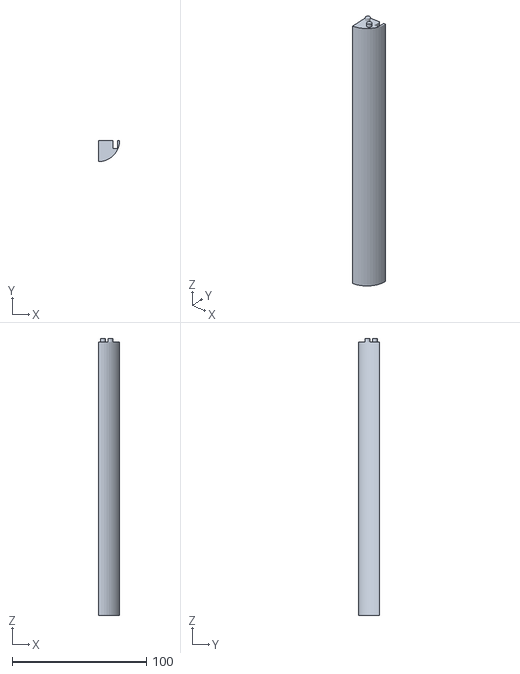
[picture p115: CAD file, 2026-11-04]
mtg-sorter/hardware/stl/enc_post_front_r.stl
16.0 x 16.0 x 206.5
