OutMyFocus/HomeLab/mtg-sorter/hardware/mk2/stl/mk2_door.stl

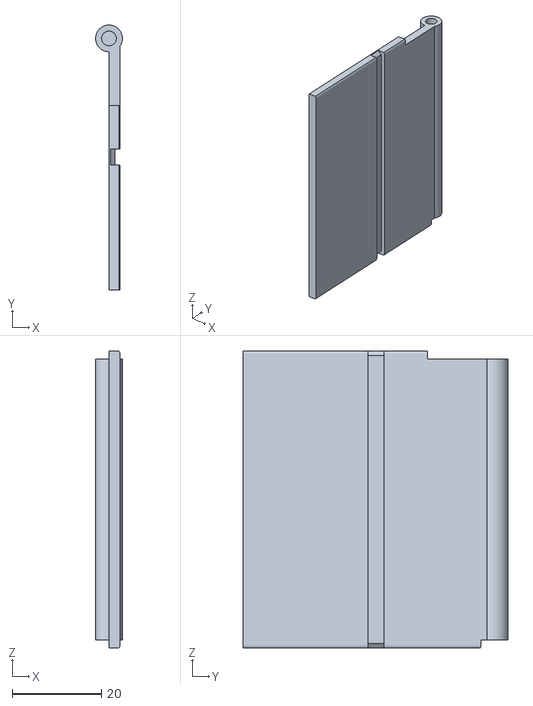
[picture p117: CAD file, 2026-11-09]
mtg-sorter/hardware/mk2/stl/mk2_door.stl
6.00 x 59.2 x 66.4
