OutMyFocus/HomeLab/mtg-sorter/hardware/stl/feeder_weight.stl

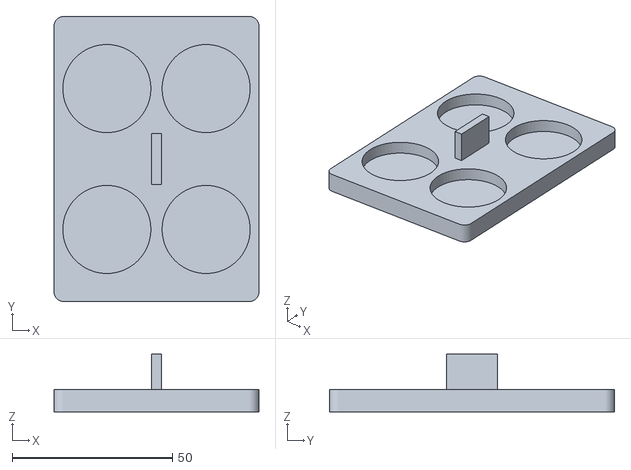
[picture p118: CAD file, 2026-11-04]
mtg-sorter/hardware/stl/feeder_weight.stl
64.0 x 89.0 x 18.0
