OutMyFocus/HomeLab/mtg-sorter/hardware/stl/enc_fascia_m.stl

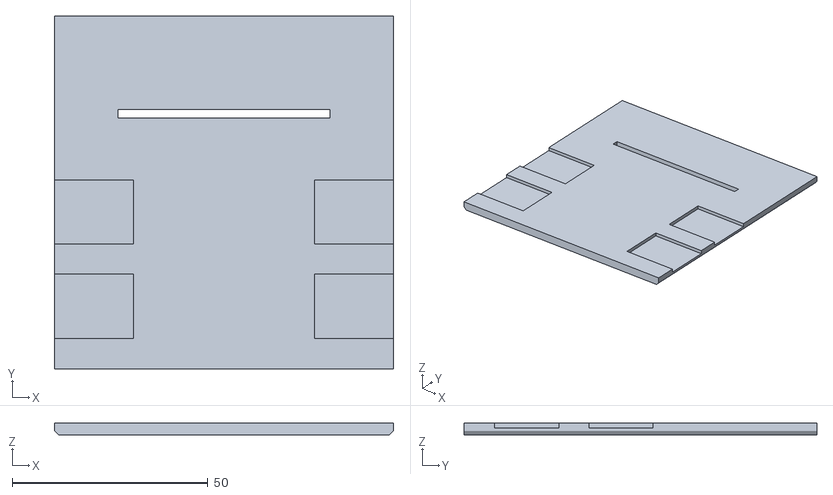
[picture p119: CAD file, 2026-10-25]
mtg-sorter/hardware/stl/enc_fascia_m.stl
86.5 x 90.0 x 3.00
