OutMyFocus/HomeLab/mtg-sorter/hardware/stl/enc_divider.stl

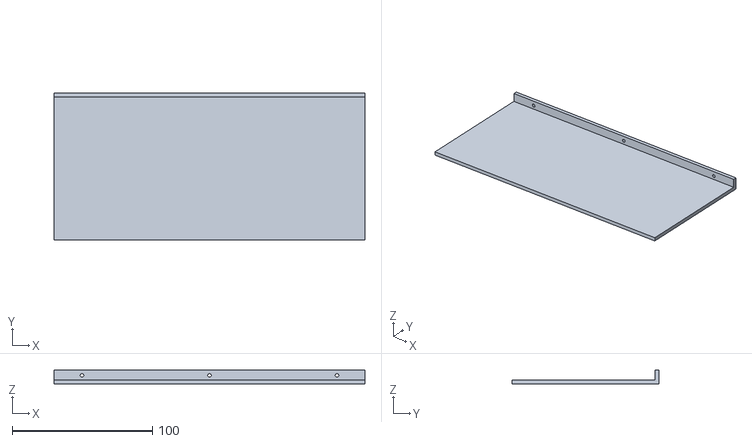
[picture p120: CAD file, 2026-10-25]
mtg-sorter/hardware/stl/enc_divider.stl
222.1 x 105.0 x 10.2
