OutMyFocus/HomeLab/mtg-sorter/hardware/stl/enc_fascia_l.stl

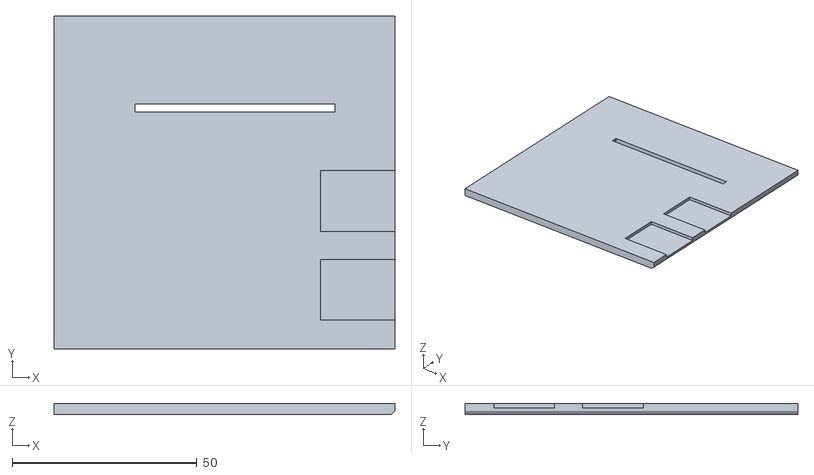
[picture p121: CAD file, 2026-10-25]
mtg-sorter/hardware/stl/enc_fascia_l.stl
92.2 x 90.0 x 3.00
