OutMyFocus/HomeLab/mtg-sorter/hardware/mk2/stl/mk2_scan_carrier.stl

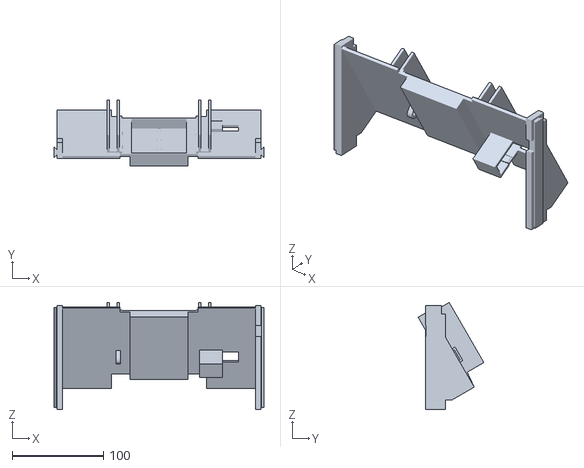
[picture p122: CAD file, 2026-11-09]
mtg-sorter/hardware/mk2/stl/mk2_scan_carrier.stl
230.0 x 72.1 x 117.3
