OutMyFocus/HomeLab/mtg-sorter/hardware/stl/enc_bridge_back.stl

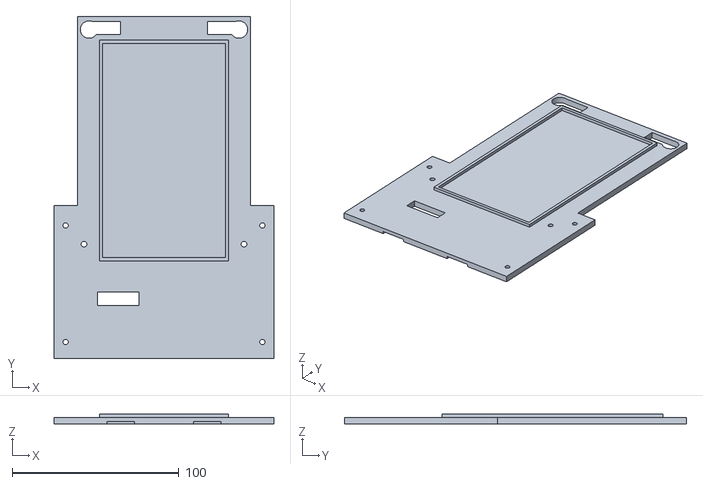
[picture p123: CAD file, 2026-10-25]
mtg-sorter/hardware/stl/enc_bridge_back.stl
132.0 x 205.5 x 5.99
