OutMyFocus/HomeLab/mtg-sorter/hardware/mk2/stl/mk2_key.stl

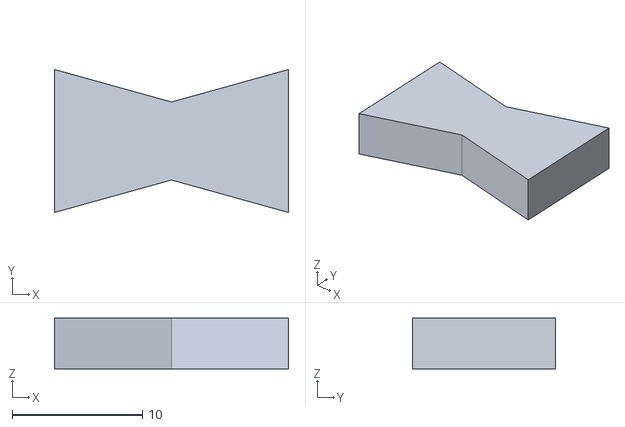
[picture p124: CAD file, 2026-11-09]
mtg-sorter/hardware/mk2/stl/mk2_key.stl
18.0 x 11.0 x 3.90
