OutMyFocus/HomeLab/mtg-sorter/hardware/stl/enc_back_l.stl

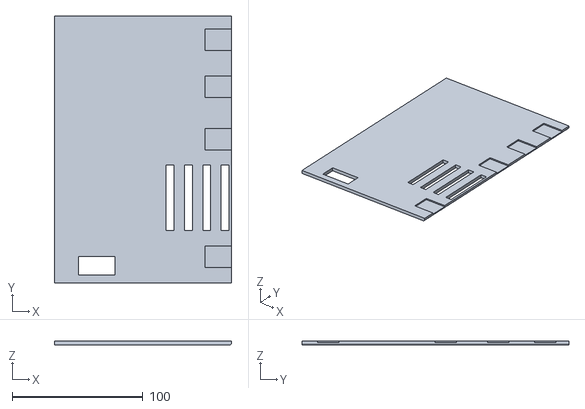
[picture p125: CAD file, 2026-10-25]
mtg-sorter/hardware/stl/enc_back_l.stl
135.4 x 204.0 x 3.00
