OutMyFocus/HomeLab/mtg-sorter/hardware/stl/enc_deck_bl.stl

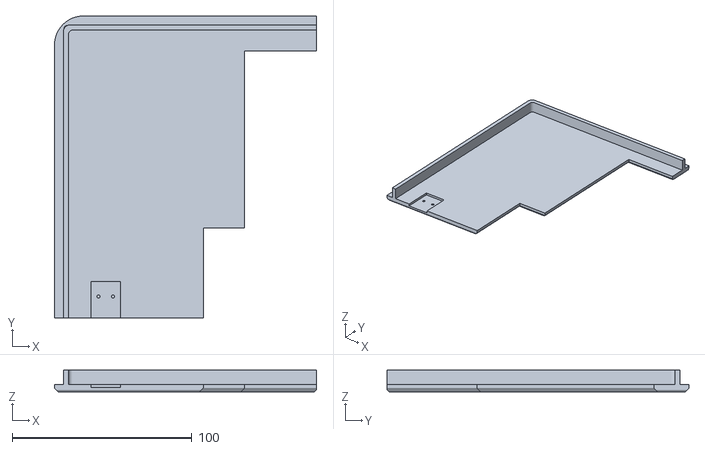
[picture p126: CAD file, 2026-10-25]
mtg-sorter/hardware/stl/enc_deck_bl.stl
145.8 x 168.0 x 12.0
