OutMyFocus/HomeLab/mtg-sorter/hardware/mk2/stl/mk2_front_cover.stl

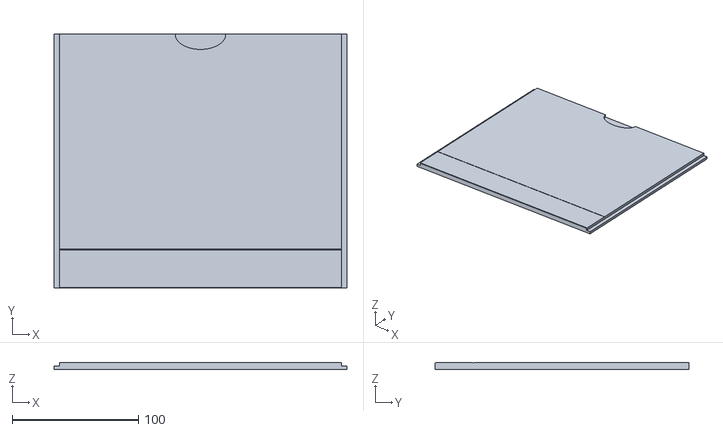
[picture p127: CAD file, 2026-11-09]
mtg-sorter/hardware/mk2/stl/mk2_front_cover.stl
232.0 x 200.7 x 5.60
