OutMyFocus/HomeLab/mtg-sorter/hardware/mk2/stl/mk2_stop_bar.stl

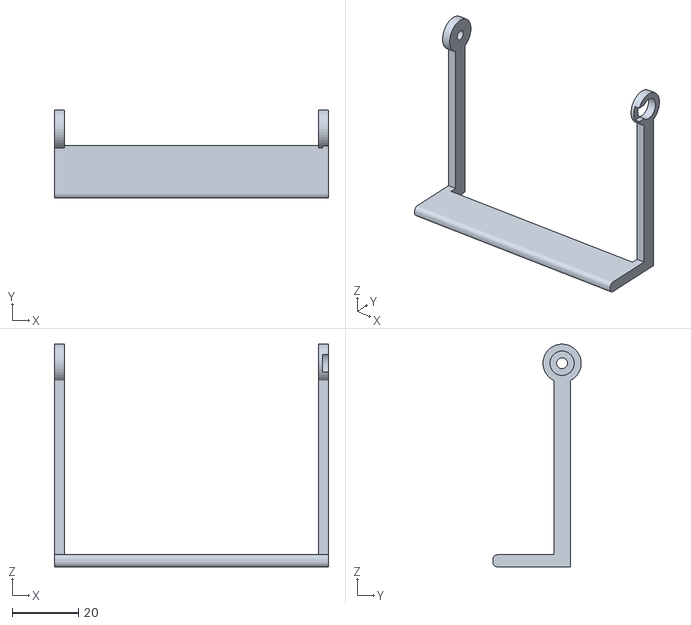
[picture p129: CAD file, 2026-11-09]
mtg-sorter/hardware/mk2/stl/mk2_stop_bar.stl
83.0 x 26.8 x 67.5
