OutMyFocus/HomeLab/mtg-sorter/hardware/stl/enc_floor_fl.stl

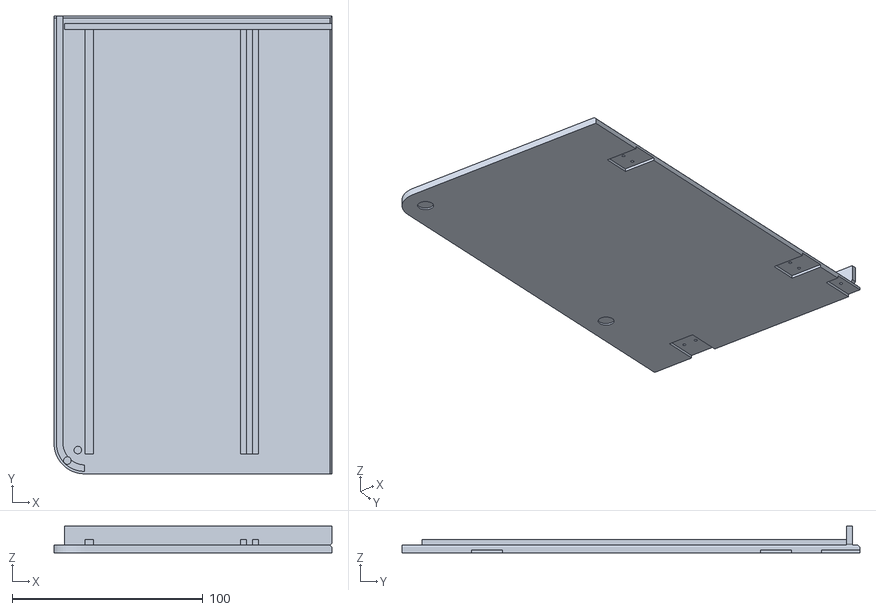
[picture p130: CAD file, 2026-10-25]
mtg-sorter/hardware/stl/enc_floor_fl.stl
145.8 x 240.0 x 14.0
