OutMyFocus/HomeLab/mtg-sorter/hardware/mk2/stl/mk2_pca_comb.stl

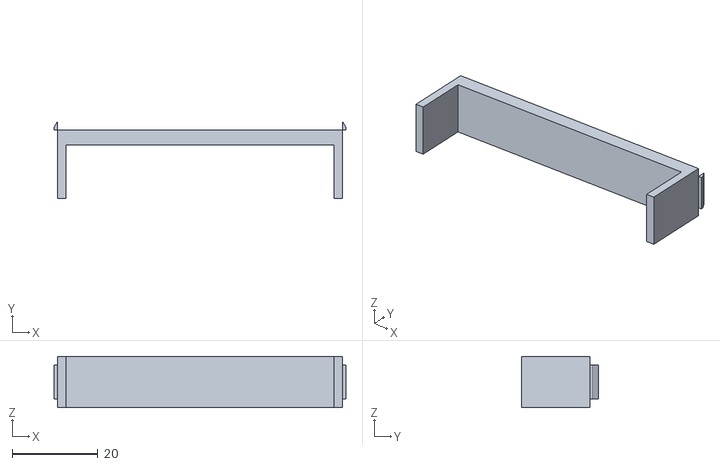
[picture p131: CAD file, 2026-11-09]
mtg-sorter/hardware/mk2/stl/mk2_pca_comb.stl
68.1 x 18.0 x 12.0
