OutMyFocus/HomeLab/mtg-sorter/hardware/mk2/stl/mk2_lid_front.stl

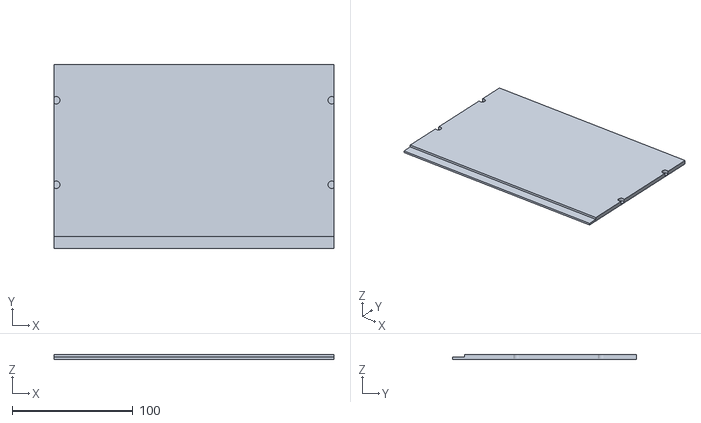
[picture p132: CAD file, 2026-11-09]
mtg-sorter/hardware/mk2/stl/mk2_lid_front.stl
232.0 x 152.7 x 4.00
