OutMyFocus/HomeLab/mtg-sorter/hardware/stl/enc_light_bar.stl

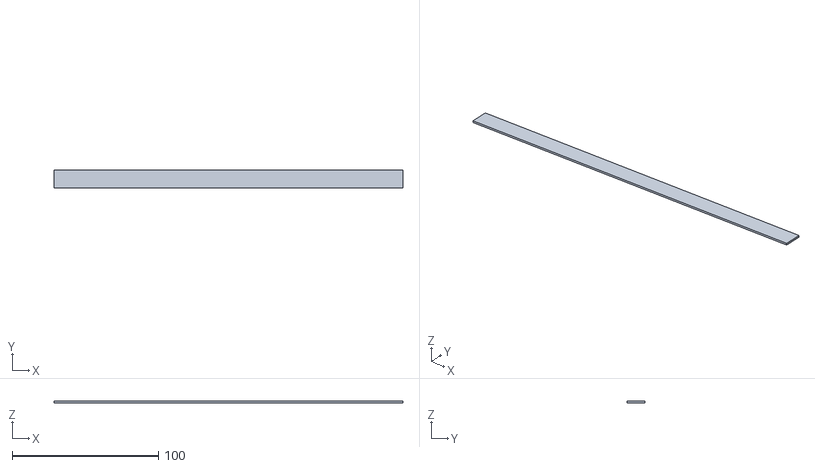
[picture p133: CAD file, 2026-10-25]
mtg-sorter/hardware/stl/enc_light_bar.stl
239.0 x 12.0 x 1.20
