OutMyFocus/HomeLab/mtg-sorter/hardware/mk2/stl/mk2_lightbar.stl

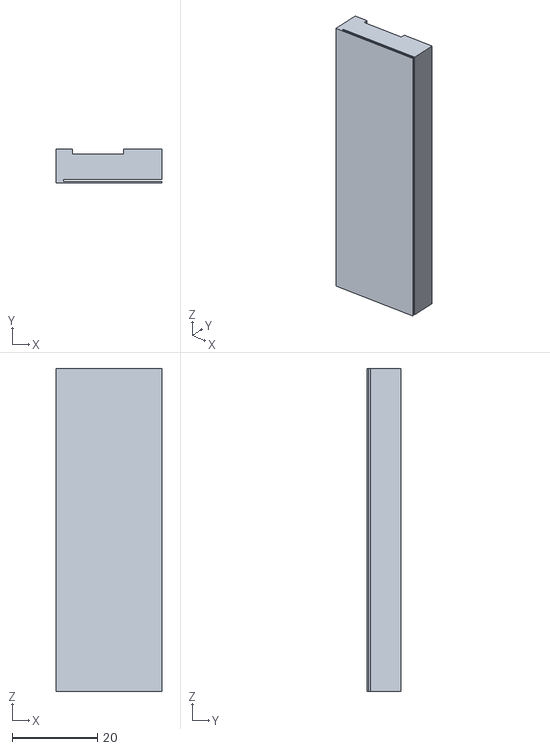
[picture p135: CAD file, 2026-11-09]
mtg-sorter/hardware/mk2/stl/mk2_lightbar.stl
24.8 x 8.00 x 75.6
