OutMyFocus/HomeLab/mtg-sorter/hardware/stl/enc_post_back.stl

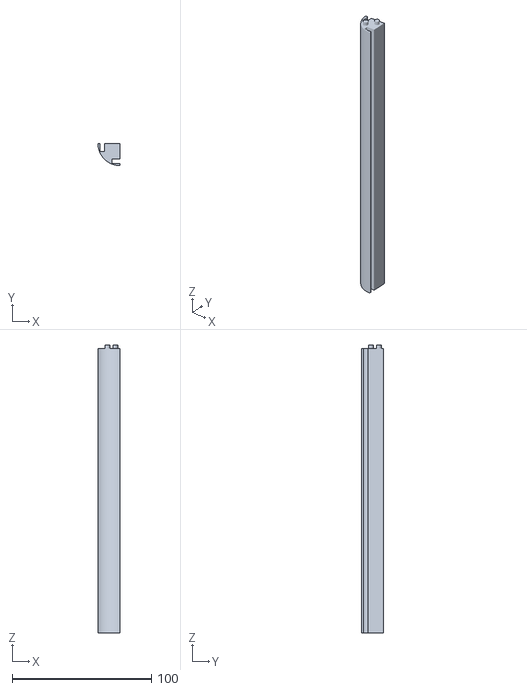
[picture p136: CAD file, 2026-10-25]
mtg-sorter/hardware/stl/enc_post_back.stl
16.0 x 16.0 x 206.5
