OutMyFocus/HomeLab/mtg-sorter/hardware/mk2/stl/mk2_liner_back.stl

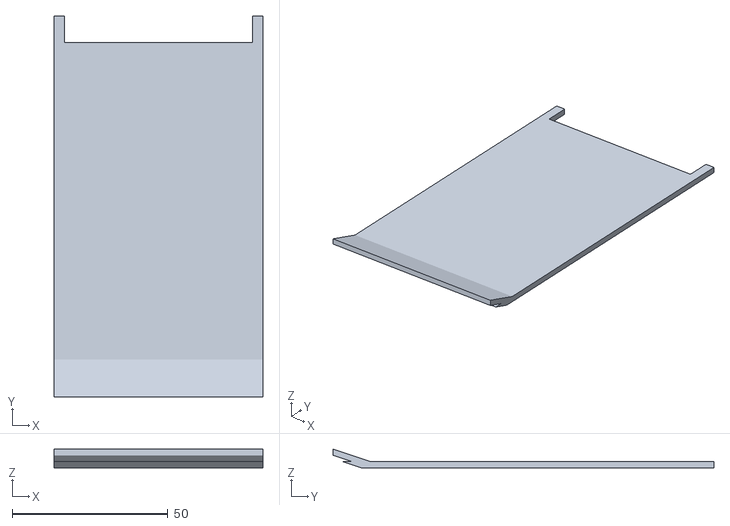
[picture p137: CAD file, 2026-11-09]
mtg-sorter/hardware/mk2/stl/mk2_liner_back.stl
67.0 x 122.0 x 6.00
