OutMyFocus/HomeLab/mtg-sorter/hardware/stl/enc_deck_fr.stl

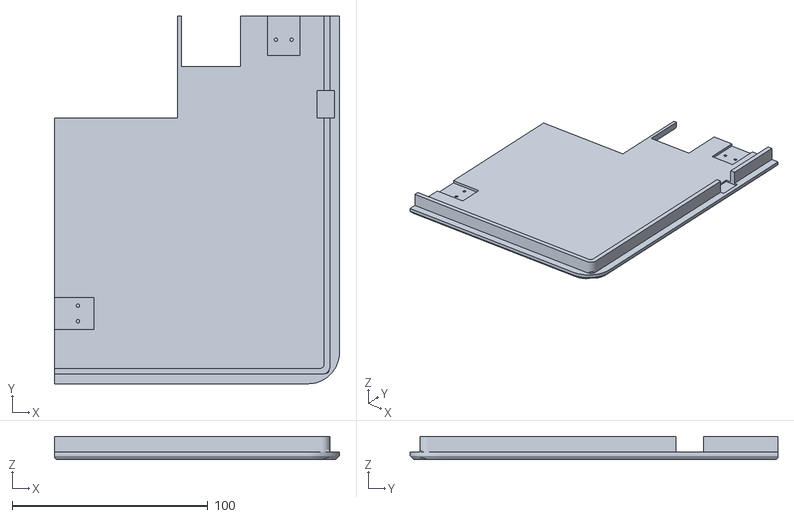
[picture p138: CAD file, 2026-10-25]
mtg-sorter/hardware/stl/enc_deck_fr.stl
145.8 x 188.0 x 12.0
