OutMyFocus/HomeLab/mtg-sorter/hardware/stl/enc_head_cover.stl

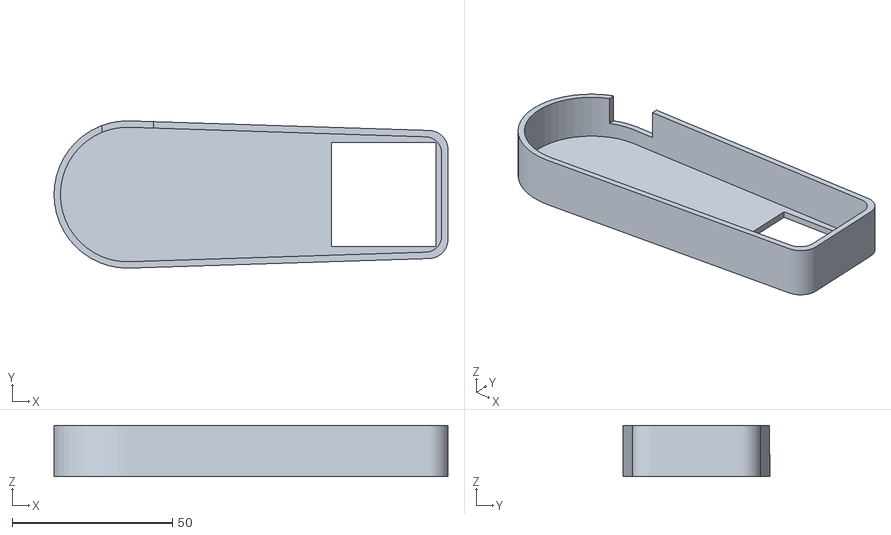
[picture p139: CAD file, 2026-10-25]
mtg-sorter/hardware/stl/enc_head_cover.stl
123.0 x 46.0 x 16.0
