OutMyFocus/HomeLab/mtg-sorter/hardware/stl/enc_side.stl

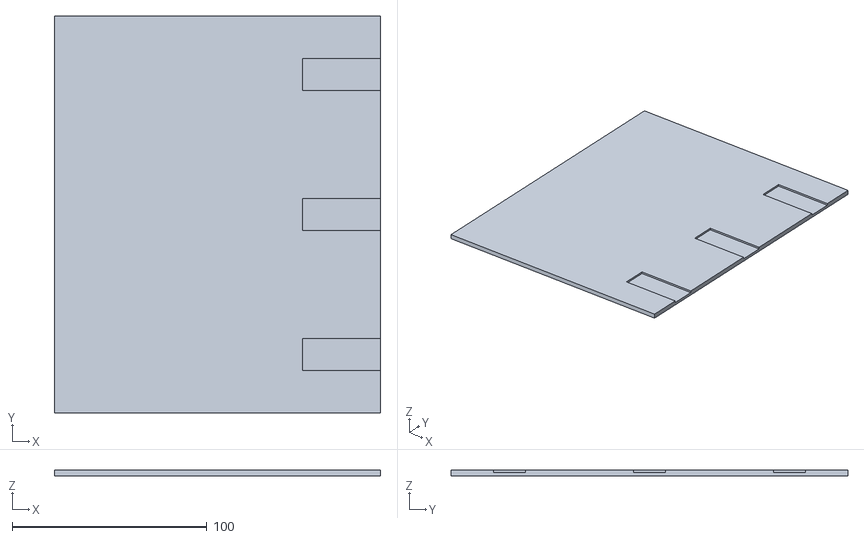
[picture p140: CAD file, 2026-10-25]
mtg-sorter/hardware/stl/enc_side.stl
167.7 x 204.0 x 3.00
