OutMyFocus/HomeLab/mtg-sorter/hardware/stl/enc_tower_lid.stl

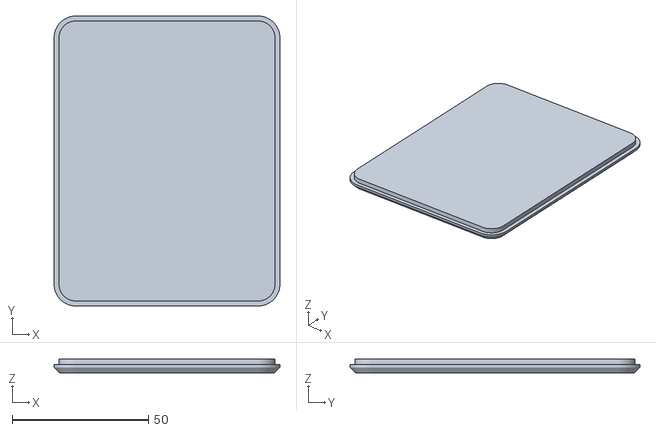
[picture p141: CAD file, 2026-10-25]
mtg-sorter/hardware/stl/enc_tower_lid.stl
83.0 x 106.5 x 5.00
