OutMyFocus/HomeLab/mtg-sorter/hardware/stl/enc_splice.stl

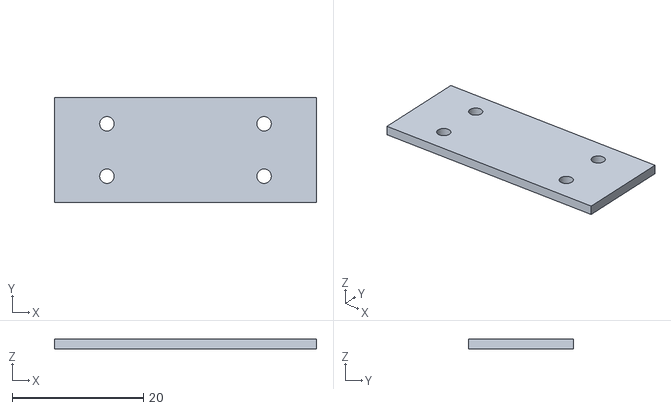
[picture p142: CAD file, 2026-10-25]
mtg-sorter/hardware/stl/enc_splice.stl
40.0 x 16.0 x 1.50
