OutMyFocus/HomeLab/mtg-sorter/hardware/stl/enc_post_sleeve.stl

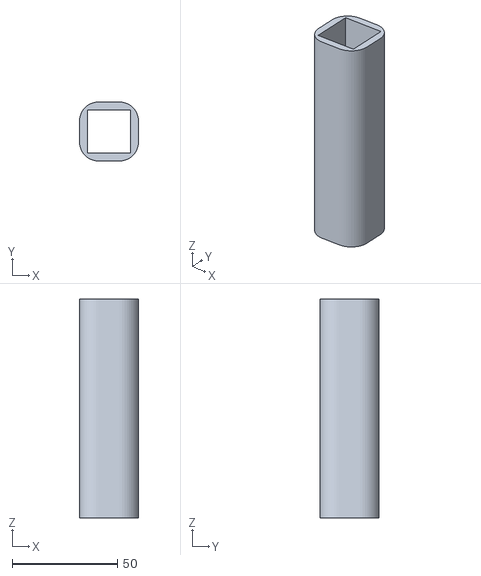
[picture p143: CAD file, 2026-10-25]
mtg-sorter/hardware/stl/enc_post_sleeve.stl
28.0 x 28.0 x 104.0
