OutMyFocus/HomeLab/mtg-sorter/hardware/stl/enc_leg.stl

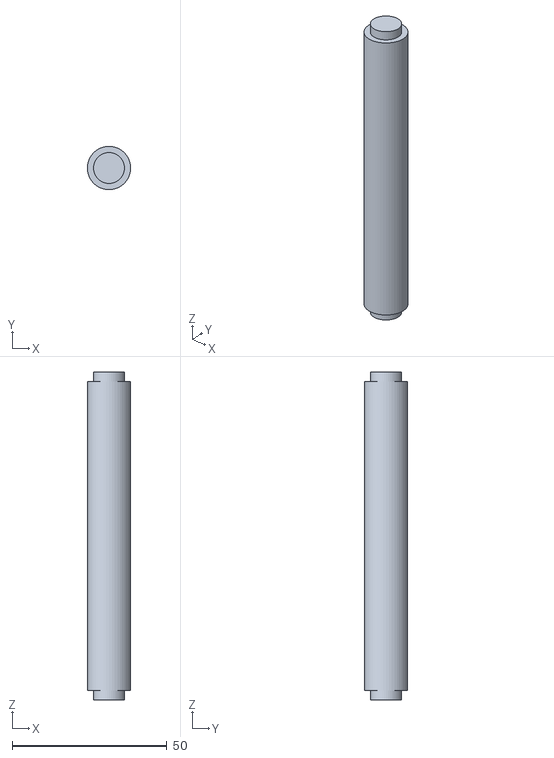
[picture p144: CAD file, 2026-10-25]
mtg-sorter/hardware/stl/enc_leg.stl
14.0 x 14.0 x 106.0
