OutMyFocus/HomeLab/mtg-sorter/hardware/stl/bed_chute_tower_post.stl

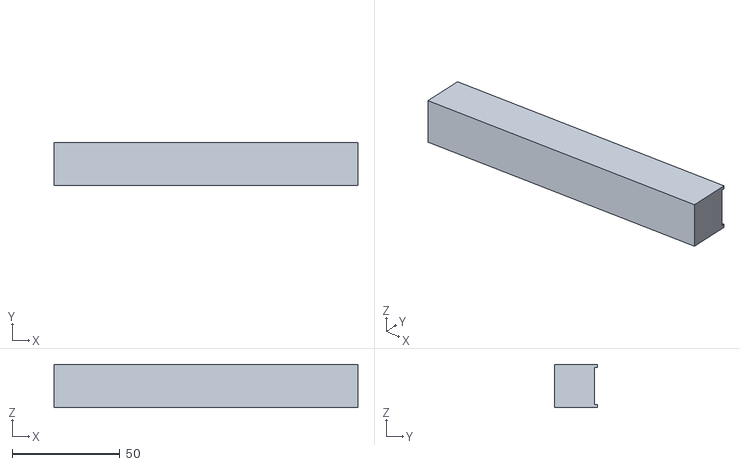
[picture p145: CAD file, 2026-10-21]
mtg-sorter/hardware/stl/bed_chute_tower_post.stl
141.0 x 20.0 x 20.0
