OutMyFocus/HomeLab/mtg-sorter/hardware/stl/bed_chute_camera_head.stl

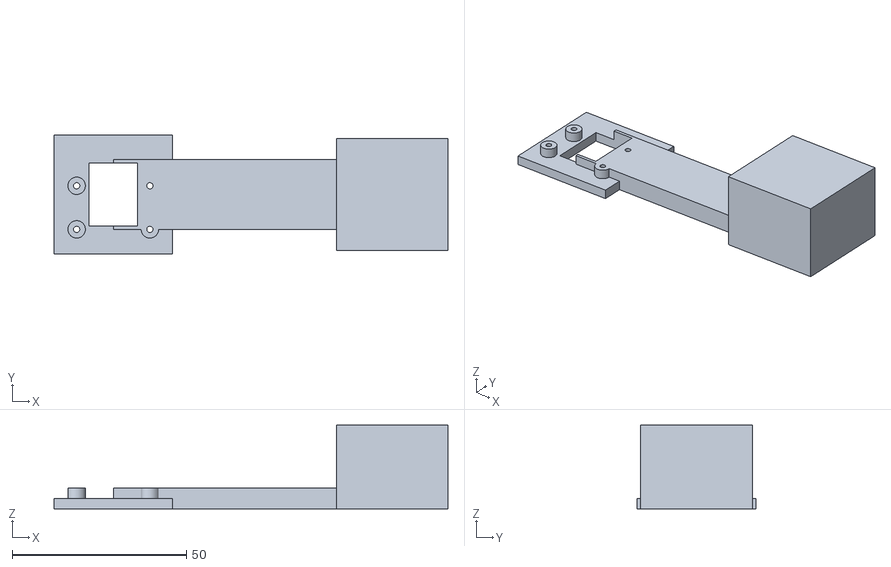
[picture p146: CAD file, 2026-10-21]
mtg-sorter/hardware/stl/bed_chute_camera_head.stl
113.0 x 34.0 x 24.0
