OutMyFocus/HomeLab/mtg-sorter/hardware/stl/bed_chute_tilt_bracket.stl

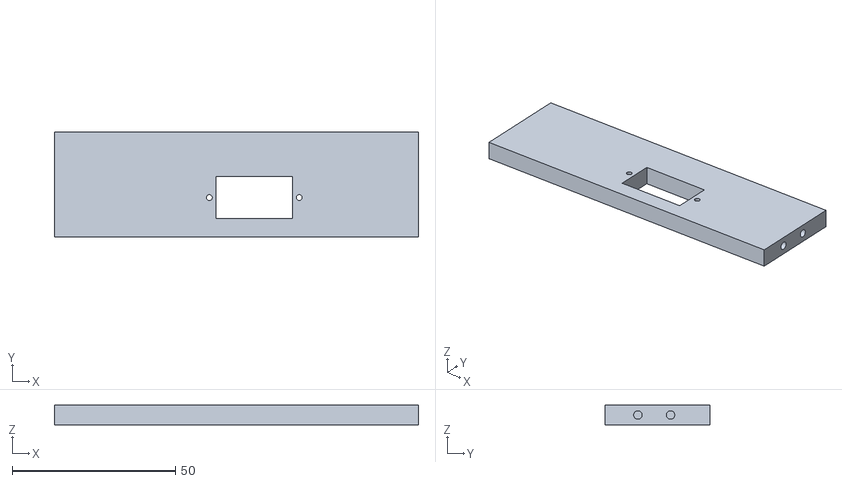
[picture p147: CAD file, 2026-10-21]
mtg-sorter/hardware/stl/bed_chute_tilt_bracket.stl
111.4 x 32.0 x 6.00
