OutMyFocus/HomeLab/mtg-sorter/hardware/mk2/levels.scad

// Sorter Mk2 sorting levels: the card's two floors, the trapdoors, and the sideways pushers.
//
//   level 1 (lv1_z)   floor = two trapdoors, hinged at the pocket's front and back edges, each on
//                     its own MG90S (the servo's shaft is the door's hinge on the left, a 3 mm steel
//                     pin on the right). Both open together: the card falls flat down the shaft.
//   level 2 (lv2_z)   a fixed floor, and the two shelves bins 1 and 2 stand on.
//   pusher (each)     a carriage: two paddles either side of the card on one crossbar behind the
//                     pocket, running along x on a dovetail on the level's back beam. Its MG90S sits
//                     under the beam with a 72 mm lever whose pin runs in a slot in the crossbar
//                     (scotch yoke): +-80 degrees of servo = +-71 mm of paddle. Left paddle pushes
//                     the card right into the bin there, and the other way round. Two fingers on each
//                     paddle run 0.8 mm below the floor in grooves, so a thin card can't slip under.
//
// Each level frame slides in from the front on the walls' rails and a magnet holds it home; its
// fascia is the machine's face between the bin rows. Nothing is screwed or glued: the doors, the
// carriage and the lever come off by pulling 3 mm steel pins or sliding them off their rails.
//
// Parts: lv1_frame, door (x2, the same part turned round), lv2_frame, carriage (x2), lever (x2),
// col_front, liner_back. `part = "levels"` shows both levels assembled; `push` (-1..1) and
// `doors` (0..1) move them.
include <joints.scad>
include <layout.scad>
part = "levels";
push = 0;
doors = 0;

// ---- MG90S (measured; same numbers as the sort module) ---------------------------------------
sv_len = 22.7;  sv_w = 12.2;  sv_shaft_off = 5.9;  sv_top = 6.6;  sv_tab_len = 32.2;  sv_body = 16.8;
horn1_hub = 7.8;  horn1_w = 6.6;  horn1_len = 22;

// A servo stand-in, its shaft on the origin pointing -x ("top" faces -x), the long side along +u,
// where u is +y (dir = [0,1,0]) or +z (dir = [0,0,1]); the shaft sits sv_shaft_off from that end.
module servo_x(dir, g = 0) {
    // body coordinates: a = along the shaft (+x is into the body), u = long side, w = the other way
    m = dir[2] == 1 ? [[1, 0, 0, 0], [0, 0, 1, 0], [0, 1, 0, 0], [0, 0, 0, 1]] : [[1, 0, 0, 0], [0, 1, 0, 0], [0, 0, 1, 0], [0, 0, 0, 1]];
    multmatrix(m) {
        translate([-sv_top - g, -sv_shaft_off - g, -sv_w / 2 - g]) cube([sv_top + sv_body + 2 * g, sv_len + 2 * g, sv_w + 2 * g]);
        translate([0 - g, -sv_shaft_off - (sv_tab_len - sv_len) / 2 - g, -sv_w / 2 - g]) cube([2.5 + 2 * g, sv_tab_len + 2 * g, sv_w + 2 * g]);
        translate([-sv_top - 2.9, 0, 0]) rotate([0, 90, 0]) cylinder(d = 5 + 2 * g, h = 2.9 + 0.01);
    }
}
// the pocket the servo slides into (from +x, its tabs on a shoulder) and the box round it.
// One side wall of the box is slit into a spring finger with a lip that snaps over the back of the
// servo's body, so the servo can't back out. side = +1 or -1 picks which side wall.
sv_lip = 1.2;  sv_finger = [14, 6, 1.4];      // the finger: length, width, thickness
module servo_x_cut(dir, side = 1) {
    m = dir[2] == 1 ? [[1, 0, 0, 0], [0, 0, 1, 0], [0, 1, 0, 0], [0, 0, 0, 1]] : [[1, 0, 0, 0], [0, 1, 0, 0], [0, 0, 1, 0], [0, 0, 0, 1]];
    uc = sv_len / 2 - sv_shaft_off;  w0 = sv_w / 2 + 0.25;  a1 = sv_body + 2.5;  a0 = a1 - sv_finger[0];
    difference() {
        union() {
            servo_x(dir, 0.25);
            multmatrix(m) translate([0, -sv_shaft_off - (sv_tab_len - sv_len) / 2 - 0.25, -sv_w / 2 - 0.25]) cube([sv_body + 20, sv_tab_len + 0.5, sv_w + 0.5]);
        }
        // the lip (left standing in the pocket)
        multmatrix(m) scale([1, 1, side]) translate([0, uc + sv_finger[1] / 2, 0]) rotate([90, 0, 0]) linear_extrude(sv_finger[1])
            polygon([[sv_body + 0.3, w0 + 0.01], [sv_body + 0.3, w0 - sv_lip], [sv_body + 0.9, w0 - sv_lip], [a1 + 0.01, w0 + 0.01]]);
    }
    // the finger: a slit each side of it, and its outside thinned so it can spring
    multmatrix(m) scale([1, 1, side]) {
        for (u = [uc - sv_finger[1] / 2 - 0.8, uc + sv_finger[1] / 2]) translate([a0, u, w0 - 0.05]) cube([sv_finger[0] + 0.1, 0.8, 3]);
        translate([a0, uc - sv_finger[1] / 2 - 0.8, w0 + sv_finger[2]]) cube([sv_finger[0] + 0.1, sv_finger[1] + 1.6, 3]);
    }
}
module servo_x_box(dir, depth = sv_body + 2.5) {
    m = dir[2] == 1 ? [[1, 0, 0, 0], [0, 0, 1, 0], [0, 1, 0, 0], [0, 0, 0, 1]] : [[1, 0, 0, 0], [0, 1, 0, 0], [0, 0, 1, 0], [0, 0, 0, 1]];
    multmatrix(m) translate([-sv_top + 0.5, -sv_shaft_off - (sv_tab_len - sv_len) / 2 - 2.5, -sv_w / 2 - 2.5]) cube([sv_top - 0.5 + depth, sv_tab_len + 5, sv_w + 5]);
}

// ---- doors (level 1) --------------------------------------------------------------------------
hinge_y = 56.5;  hinge_z = -2.5;       // relative to the level's floor: far enough out that the door
                                       // servos' boxes stay clear of the card (|y| <= 45.5) and the bins
door_t = 2.5;  knuckle_r = 3;  knuckle_x = 33.2;  door_gap = 0.25;
sv_door_x = -knuckle_x - 0.3 - 3.5 - sv_top;   // the servo's tab face: its horn's hub sits between its top and the knuckle
// One door, drawn as the BACK door of a level at z = 0 (hinge at y = +hinge_y); the front door is
// the same part turned 180 degrees about z.
// The groove the paddles' fingers run in (the fingers reach 0.8 below the floor), with a 45 degree
// lead-in at each end (xe) so a finger that sags a little rides in instead of catching the edge.
finger_dz = 1.2;
module finger_groove(y, zt, xe) {
    translate([-pk_x - 1, y - 1.8, zt - finger_dz]) cube([2 * pk_x + 2, 3.6, finger_dz + 0.2]);
    for (m = [0, 1]) mirror([m, 0, 0]) translate([xe, y, zt - finger_dz]) rotate([0, 45, 0]) cube([1.414, 3.6, 1.414], center = true);
}
module door() {
    difference() {
        union() {
            translate([-knuckle_x, door_gap, -door_t]) cube([2 * knuckle_x, hinge_y - door_gap, door_t]);
            translate([-knuckle_x, hinge_y, hinge_z]) rotate([0, 90, 0]) cylinder(r = knuckle_r, h = 2 * knuckle_x);
            translate([-knuckle_x, hinge_y - knuckle_r, hinge_z]) cube([2 * knuckle_x, knuckle_r, -hinge_z]);
        }
        // fingers' grooves: 0.4 below the fingers, with a 45 degree lead-in where they come in
        finger_groove(finger_y, 0, knuckle_x);
        // the servo's single-arm horn presses into the left end; the right end turns on a 3 mm pin
        translate([-knuckle_x - 0.01, hinge_y, hinge_z]) rotate([0, 90, 0]) linear_extrude(1.8) { circle(d = horn1_hub); rotate(-90) translate([0, -horn1_w / 2]) square([horn1_len - 7, horn1_w]); }
        translate([-knuckle_x - 0.01, hinge_y, hinge_z]) rotate([0, 90, 0]) cylinder(d = 2.4, h = 8);
        translate([knuckle_x - 8, hinge_y, hinge_z]) rotate([0, 90, 0]) cylinder(d = pin_free, h = 8.02, $fn = 32);
        // the same horn pocket and pin hole at the other end, so one part is both doors
        translate([knuckle_x + 0.01, hinge_y, hinge_z]) rotate([0, -90, 0]) linear_extrude(1.8) { circle(d = horn1_hub); rotate(90) translate([0, -horn1_w / 2]) square([horn1_len - 7, horn1_w]); }
        translate([-knuckle_x - 0.01, hinge_y, hinge_z]) rotate([0, 90, 0]) cylinder(d = pin_free, h = 8.02, $fn = 32);
        // the floor surface ends in a 0.4 chamfer at the push edges
        for (m = [0, 1]) mirror([m, 0, 0]) translate([pk_x - 1, -1, -1]) rotate([-90, 0, 0]) difference() {
            translate([0, -2, 0]) cube([2, 2, hinge_y + 2]); translate([0, 0, -1]) cylinder(r = 1, h = hinge_y + 4, $fn = 24); }
    }
}
module door_at(L, front, open = 0) {
    a = open * 90;
    translate([0, 0, L]) rotate([0, 0, front ? 180 : 0]) translate([0, hinge_y, hinge_z]) rotate([a, 0, 0]) translate([0, -hinge_y, -hinge_z]) door();
}
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
