OutMyFocus/HomeLab/mtg-sorter/hardware/mk2/scene.scad

// Sorter Mk2: the whole machine in one view (for pictures).
include <joints.scad>
include <layout.scad>
use <frame.scad>
use <levels.scad>
frame_assembly();
levels_assembly();
