OutMyFocus/HomeLab/mtg-sorter/hardware/mk2/scene_atoms.scad

// Sorter Mk2, one part (or one small set) at a time in machine coordinates, for the picture
// assembly guide (guide/build_guide.py): openscad -D 'a="..."' -o w/a_<name>.stl scene_atoms.scad
include <etray.scad>      // brings joints + layout, and the tray's board positions
use <frame.scad>
use <levels.scad>
use <scan.scad>
use <feeder.scad>
use <covers.scad>
part = "none";            // etray.scad draws nothing
a = "base_fl";

// as frame.scad / levels.scad (variables don't pass through `use`)
zrows = [[wall_z0, seam_z[0]], [seam_z[0], seam_z[1]], [seam_z[1], top_z]];
ycols = [[front_y, seam_y], [seam_y, back_y]];
chan_z = [etray_z1 - 20, top_z - 40];
lid_len = (chan_z[1] - chan_z[0]) / 3 - 0.5;
base_tiles = [["fl", [-wall_out - 1, 0], [front_y - 1, base_seam_y]], ["fr", [0, wall_out + 1], [front_y - 1, base_seam_y]],
              ["bl", [-wall_out - 1, 0], [base_seam_y, back_y + 1]], ["br", [0, wall_out + 1], [base_seam_y, back_y + 1]]];
module key_across_y() multmatrix([[0, 0, -1, 0], [1, 0, 0, 0], [0, -1, 0, 0], [0, 0, 0, 1]]) children();
module key_across_z() multmatrix([[0, 0, -1, 0], [0, 1, 0, 0], [1, 0, 0, 0], [0, 0, 0, 1]]) children();
module into_face_run_z() multmatrix([[0, 0, -1, 0], [-1, 0, 0, 0], [0, 1, 0, 0], [0, 0, 0, 1]]) children();
module wall_keys() {      // the right wall's 9 keys, in their sockets on the inside face
    for (zz = zrows) translate([wall_in, seam_y, (zz[0] + zz[1]) / 2]) key_across_y() translate([0, 0, -key_t]) key();
    for (sz = seam_z) for (y = [front_y + 40, seam_y + 40, back_in - 40]) translate([wall_in, y, sz]) key_across_z() translate([0, 0, -key_t]) key();
}
module board(at, sz, h = 1.6) translate([at[0], at[1], base_top + et_floor + stand]) cube([sz[0], sz[1], h]);
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
