OutMyFocus/HomeLab/(list of files, cad)

Other CAD files:
mtg-sorter/hardware/mk2/stl/mk2_wall_r11.stl
mtg-sorter/hardware/mk2/stl/mk2_wall_r01.stl
mtg-sorter/hardware/stl/bed_chute_door_crank3_left.stl
mtg-sorter/hardware/stl/bed_chute_servo_crank3.stl
mtg-sorter/hardware/mk2/stl/mk2_wall_l02.stl
mtg-sorter/hardware/stl/bed_chute_door3.stl
mtg-sorter/hardware/mk2/stl/mk2_wall_l10.stl
mtg-sorter/hardware/stl/enc_floor_bl.stl
mtg-sorter/hardware/mk2/stl/mk2_back_low.stl
mtg-sorter/hardware/mk2/stl/mk2_base_fr.stl
mtg-sorter/hardware/mk2/stl/mk2_base_br.stl
mtg-sorter/hardware/mk2/stl/mk2_wall_r12.stl
mtg-sorter/hardware/mk2/stl/mk2_wall_l00.stl
mtg-sorter/hardware/mk2/stl/mk2_fd_roller.stl
mtg-sorter/hardware/stl/enc_post_front.stl
mtg-sorter/hardware/stl/enc_deck_br.stl
mtg-sorter/hardware/stl/enc_fascia_r.stl
mtg-sorter/hardware/stl/enc_floor_fr.stl
mtg-sorter/hardware/mk2/scene_groups.scad
mtg-sorter/hardware/guide/bed3/scenes.scad
mtg-sorter/hardware/guide/feeder4/check.scad
mtg-sorter/hardware/guide/feeder4/scenes.scad
mtg-sorter/hardware/feeder_test.scad
mtg-sorter/hardware/mk2/scan.scad
mtg-sorter/hardware/guide/scenes.scad
mtg-sorter/hardware/guide/v2/bed_scenes.scad
mtg-sorter/hardware/guide/v2/feeder_scenes.scad
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
