OutMyFocus/HomeLab/mtg-sorter/hardware/mk2/MTG_Sorter_Mk2_Picture_Assembly.html

# Sorter Mk2 assembly

The Mk2 build, one picture per step, drawn from the same model the print file comes from. No screws and no glue: pins and magnets press in, everything else slides or clicks. Print the plates first (MK2.md, Print), and stop at its checkpoints.

Sorter Mk2, finished

already fitted this step which way it goes in servo board

Centre every servo before it goes in. Plug it into the PCA9685, set it to 90° with the snippet below, then fit the horn and slide the servo into its box. Otherwise the part it moves ends up at the wrong angle.

from adafruit_servokit import ServoKit
kit = ServoKit(channels=16)
kit.servo[0].angle = 90   # channel, angle

Never use a 12 V adapter. Mk2 runs on one 5 V brick and has no regulator, so 12 V would kill the Pi, the servos and the lights.

## PART AThe box

Step 1: Join the base

01

### Join the base

- Lay the four base tiles on the table, top up, and push them together.
- Press a bowtie key into each of the 5 sockets across the seams.
- Push the 3 x 16 mm pins into the seam holes: 3 across the long seam, 2 across the short one.
- Press the magnets into their pockets: 1 for the drawer and 2 for each of bins 3 and 4.

Partsbase_flbase_frbase_blbase_br5 × key

You need5 × 3 × 16 mm pin5 × magnet

Step 2: Join each wall

02

### Join each wall

- Each wall is six tiles: two across and three up.
- Lay the tiles inside face up and push them together. Press a key into each of the 9 sockets across the seams.
- Push the 3 x 16 mm pins into the seam holes.
- Build the left wall the same way. Its tiles are mirror images, so keep the L and R tiles apart.

Partswall_r00 to r12wall_l00 to l1218 × key

You need3 × 16 mm pins

Step 3: Slide the walls onto the base

03

### Slide the walls onto the base

- Stand each wall at the front corner of the base, its bottom groove on the dovetail along the base's edge.
- Slide it back with a firm push until it's flush with the base's back edge. The dovetail locks the wall down, so the machine can be lifted by its walls.
- Press the magnets into the rails (near the closed back end of each rail) and into the top ledge for the lid.

Partsleft wallright wall

You needrail and lid magnets

## PART BThe levels

Step 4: Level 2's pusher, on the bench

04

### Level 2's pusher, on the bench

- Press the servo horn into the lever's pocket and push a 3 x 16 mm pin through the lever's end, so 5 mm stands out of its flat face.
- Lay the carriage on the frame's guide and slide it to the middle.
- Lower the lever in from above so its pin drops into the fork at the top of the crossbar.
- Slide the servo in from the back of its box, shaft first into the lever's horn, until the latch clicks over its back. To take it out, lift the latch with a fingernail and pull.

Partslv2_framecarriage2lever

You needMG90S servo (centred to 90°)3 × 16 mm pin

Step 5: Level 2 into the box

05

### Level 2 into the box

- Lay a hall sensor flat in each shelf's pocket, legs back along the groove. It reads the bin's magnet through the bin's floor.
- Slide level 2 in from the front on the lowest rail, until its magnet clicks.
- Its servo wire goes straight back to the trunk in the wall (see the cables step).

Partslevel 2 (from the last step)

You need2 × hall sensor (A3144 or similar)

Step 6: Shaft liners

06

### Shaft liners

- The column front and the back liner line the shaft that cards fall down from level 1 to level 2.
- Stand each one in level 2's floor groove. The column front's panel sits flush with the machine's face, between bins 1 and 2.
- Their top tabs click under level 1's front hinge bar when level 1 goes in, in step 09.

Partscol_frontliner_back

Step 7: Level 1's pusher, on the bench

07

### Level 1's pusher, on the bench

- Same as level 2: horn and pin in the lever, carriage on the guide, lever into the fork, servo in from the back until it clicks.

Partslv1_framecarriage1lever

You needMG90S servo (centred)3 × 16 mm pin

Step 8: Trapdoors and their servos (seen from below)

08

### Trapdoors and their servos (seen from below)

- Hold each door in place under the floor's opening, its left knuckle against the servo pocket.
- Slide the two door servos in from the left until their latches click, each horn in its door's pocket.
- Push a 3 x 10 mm pin through each door's right knuckle.
- Check both doors swing down freely by hand.

Parts2 × door (white)

You need2 × MG90S servo (centred)2 × 3 × 10 mm pin

Step 9: Level 1 into the box

09

### Level 1 into the box

- Slide level 1 in from the front on its rail, until its magnet clicks.
- On the way in its front hinge bar rides over the liners' tabs and clicks them home.

Partslevel 1 (from the last two steps)

Step 10: Bin-full sensors

10

### Bin-full sensors

- Slide a TCRT5000 module into each of the four holders: sensor end first, sensor facing out of the open side.
- Slide each holder's tongue back into the groove in the frame's stiffener behind its bin. The left holders are the same part turned upside down.
- The sensor looks through the slot in the bin's back wall, and the bin in front keeps the holder in its groove.

Parts4 × ir_holder

You need4 × TCRT5000 module

## PART CThe scan module

Step 11: Stop bar and its servo

11

### Stop bar and its servo

- Centre the servo first. Push a 3 x 10 mm pin through the stop bar's left arm into the carrier, and press the servo's horn into the right arm.
- Click the servo into its box under the carrier until the latch closes.
- Swing the bar by hand: it should move freely between up and down.

Partsscan_carrierstop_bar

You needMG90S servo (centred)3 × 10 mm pin

Step 12: Lights and the scan bed

12

### Lights and the scan bed

- Stick the LED strip pieces into the light box under the bed and into the two light bars.
- Drop the light bars into their slots, with the polarizer strips in front of them.
- Press the white bed into the carrier's rim until it clicks under the four lips.
- Stick the four half-width PTFE strips on the bed's lands.

Partsscan_bed (white)2 × lightbar (white)

You needLED strip piecespolarizer filmPTFE tape, cut in half

Step 13: Scan module into the box

13

### Scan module into the box

- Slide the carrier in from the front on the scan rail, above level 1, until its magnet clicks.
- The stop bar must be up whenever level 1's pusher moves. The app does that for you.

Partsscan module (from the last two steps)

Step 14: Camera arch

14

### Camera arch

- Slide the camera arch in on the same rail after the carrier.
- A key joins each of its feet to the carrier's skids, so the camera can't move relative to the card.
- Clip the camera onto its two pegs under the arch's plate, put the polarizer disc in the hood and twist the hood on.

Partscam_archcam_hood2 × key

You needCamera Module 3polarizer disc

## PART DThe feeder

Step 15: Feeder cartridge, on the bench

15

### Feeder cartridge, on the bench

- Lay the N20 motor in its pod and snap the motor lid over it. Fit the roller on the shaft.
- Drop the magazine onto the stand's ridge.
- Stick the two PTFE strips in the magazine floor's tracks and the cork pads under the shoe. The shoe rests on the wheels by its own weight.

Partsfd_standfd_motor_lidfd_rollerfd_hopperfd_shoe

You needN20 motor, 60 RPM2 × cork padPTFE tape

Step 16: Feeder into the box

16

### Feeder into the box

- Leave the upper back panel off for now.
- Slide the cartridge in from the back on the top rail, until its magnets click.
- Its motor wire runs down the wall's feeder branch to the trunk.

Partsfeeder cartridge (from the last step)

## PART EElectronics and cables

Step 17: Fill the electronics tray

17

### Fill the electronics tray

- Press the Pi 5 and the PCA9685 onto their pegs, ports to the back.
- Push the relay and the DRV8833 into their cradles until the hooks click, and the Wago blocks into their holder.
- Snap the comb over the PCA9685's servo plugs so none can work loose.
- Fit the DC jack in the back plate's 11 mm hole with its nut.

Partsetraypca_comb

You needPi 5PCA9685DRV88335 V relay2 × Wago 221-415panel DC jack

Step 18: Tray into the box

18

### Tray into the box

- Slide the tray in from the back on the base's two rails, until it clicks.
- Plug each module's labelled JST-XH plug into the patch bar along the tray's front.

Partselectronics tray (from the last step)

Step 19: Cables in the trunks

19

### Cables in the trunks

- Each wall has a cable trunk at y 76 with three click-in lids. Fit the lids with their notches to the back, and a wire drops into the trunk wherever it meets it.
- Wires cross to the trunk only where nothing moves: behind the bins and under the back beams.
- Red: servo wires. Yellow: bin sensors. Orange: the trunk down to the tray.

Parts6 × trunk_lidbranch_lid

You needJST-XH plugslabels

## PART FCovers and bins

Step 20: Back panels

20

### Back panels

- Drop the two back panels into the back grooves from the top, the low one first.
- Their louvres slope down to the outside, so warm air gets out and room light can't reach the scan bed.

Partsback_lowback_high

Step 21: Front cover and lid

21

### Front cover and lid

- Drop the front cover in from the top.
- Lay the two lid halves on the ledge between the walls, where the magnets hold them.

Partsfront_coverlid_frontlid_back

Step 22: Drawer and bins

22

### Drawer and bins

- Slide the drawer in under the bins until its magnet clicks.
- Slide the four bins in on their runners. Any bin goes in any slot.
- Plug in the 5 V brick (never 12 V) and press the button.

Partsdrawer4 × bin

You need5 V 10 A brick

## WIRINGPower and pins

### One plug, one button

5 V 10 A brick ─ panel jack (back) ─┬─ Wago 5 V ─┬─ USB-C pigtail → Pi 5 (always fed)
                                    │            └─ relay COM ─ NO ─ Wago "switched 5 V"
                                    │                                 ├─ PCA9685 V+ (servos)
                                    │                                 ├─ DRV8833 VCC (feeder motor)
                                    │                                 ├─ light strip 5 V
                                    │                                 └─ button's LED ring
                                    └─ Wago GND ─ everything's ground
- The power button is a 16 mm momentary button on the Pi 5's J2 pads (solder a 2-pin header: the only soldering in Mk2). Press to boot, press to shut down, hold to force off.
- The relay is on GPIO22, with its trigger jumper on HIGH. Until the app starts, the servos, motor and lights have no power, so nothing twitches at boot.
- Run sudo rpi-eeprom-config --edit on the Pi and add PSU_MAX_CURRENT=5000.
- Servo plugs: brown is GND, orange is 5 V, yellow is signal.

What | Where
Stop bar servo | PCA9685 ch 0
Level 1 pusher servo | PCA9685 ch 1
Front trapdoor servo | PCA9685 ch 2
Back trapdoor servo | PCA9685 ch 3
Level 2 pusher servo | PCA9685 ch 4
Feeder motor | GPIO17 / GPIO27 → DRV8833 IN1 / IN2
Light strip data | GPIO10 (pin 19)
Relay | GPIO22
Bin seated (hall), bins 1 to 4 | GPIO5, 6, 13, 26
Bin full (TCRT5000), bins 1 to 4 | GPIO16, 20, 21, 12
Power button | Pi 5 J2

Pictures come from hardware/mk2/scene_atoms.scad, rendered by hardware/mk2/guide/build_guide.py. The written steps are in hardware/mk2/MK2.md.
