OutMyFocus/HomeLab/mtg-sorter/mtgscanner/machine.py

"""The sorter's moving parts: four servos on the PCA9685 board and the feeder motor.

Nothing here talks to the hardware until it's first used, and nothing fails if the
hardware isn't there (a PC, or a Pi with nothing wired up yet): each part reports
what's missing instead. The Machine page (/machine in the app) uses this to test
every part by hand. Pins, channels and starting angles are in config.py.

Angles you find and save on the Machine page go in data/machine_settings.json and win
over config.py. That file isn't in git, so saving there never blocks an update (editing
config.py on the Pi would: see deploy/update.sh).
"""

import copy
import json
import threading
import time

from flask import jsonify, request, send_from_directory

from . import config


def settings_file():
    return config.DATA_DIR / "machine_settings.json"


def last_angles_file():
    return config.DATA_DIR / "servo_last.json"


def load_saved() -> dict:
    try:
        saved = json.loads(settings_file().read_text())
        return saved if isinstance(saved, dict) else {}
    except (OSError, ValueError):
        return {}


class Machine:
    def __init__(self):
        self.lock = threading.Lock()
        self._kit = None          # the PCA9685, once found
        self._motor = None        # the feeder motor, once found
        self.servo_error = None   # why the servo board couldn't be used, if it couldn't
        self.feeder_error = None
        self.angles = {}          # last angle sent to each channel (None: relaxed)
        self.feeding = False
        self._stop_timer = None
        self._relax_timers = {}   # channel -> timer that lets that servo go after a move
        self.pins_up_at = None    # when the stop pins were last sent up from somewhere else

    # --- connecting ---------------------------------------------------------

    def _servos(self):
        if self._kit is None:
            try:
                from adafruit_servokit import ServoKit
                self._kit = ServoKit(channels=16)
                self.servo_error = None
            except Exception as e:   # not a Pi, I2C off, board not wired
                self.servo_error = f"Servo board not found ({e}). Is I2C on and is it wired to pins 1, 3, 5 and 6?"
        return self._kit

    def _feeder(self):
        if self._motor is None:
            try:
                from gpiozero import Motor
                self._motor = Motor(*config.FEEDER_PINS, pwm=True)
                self.feeder_error = None
            except Exception as e:
                self.feeder_error = f"Feeder motor not available ({e})."
        return self._motor

    # --- settings: config.py, with what was saved on the page on top ---------

    def servos(self) -> dict:
        """{part: (channel, {position: angle})}, with saved angles applied."""
        saved = load_saved().get("servos", {})
        parts = copy.deepcopy(config.SERVOS)
        for part, positions in saved.items():
            if part in parts and isinstance(positions, dict):
                for pos, angle in positions.items():
                    if pos in parts[part][1] and isinstance(angle, (int, float)):
                        parts[part][1][pos] = max(0, min(180, angle))
        return parts

    def feeder_defaults(self) -> dict:
        saved = load_saved().get("feeder", {})
        return {"seconds": float(saved.get("seconds", config.FEEDER_SECONDS)),
                "speed": float(saved.get("speed", config.FEEDER_SPEED)),
                "reverse": bool(saved.get("reverse", False)),
                # Feed one card: forward push after the card lands, then the wheels run
                # backwards (feed_watch.py); only kept when saved from the Machine page
                "backoff": float(saved.get("backoff", config.FEED_BACKOFF_SECONDS)),
                "push": float(saved.get("push", getattr(config, "FEED_PUSH_SECONDS", 0.0)))}

    def _write(self, saved: dict):
        config.DATA_DIR.mkdir(parents=True, exist_ok=True)
        tmp = settings_file().with_suffix(".tmp")
        tmp.write_text(json.dumps(saved, indent=2))
        tmp.replace(settings_file())

    def save_position(self, part: str, position: str, angle: float):
        """Keep an angle as a part's named position, e.g. save_position("pins", "down", 58)."""
        if part not in config.SERVOS or position not in config.SERVOS[part][1]:
            raise ValueError(f"Unknown part or position: {part} {position}")
        angle = round(max(0.0, min(180.0, float(angle))), 1)
        saved = load_saved()
        saved.setdefault("servos", {}).setdefault(part, {})[position] = angle
        self._write(saved)

    def save_feeder(self, seconds: float, speed: float, backoff=None, push=None):
        """The timed push's seconds and speed (the speed is Feed one card's too), and, when
        given, Feed one card's forward push after landing and its back-off, in seconds."""
        saved = load_saved()
        feeder = saved.setdefault("feeder", {})
        feeder.update(seconds=round(min(5.0, max(0.05, float(seconds))), 2),
                      speed=round(min(1.0, max(0.1, float(speed))), 2))
        if backoff is not None:
            feeder["backoff"] = round(min(float(getattr(config, "FEED_BACKOFF_MAX", 1.0)), max(0.0, float(backoff))), 2)
        if push is not None:
            feeder["push"] = round(min(1.0, max(0.0, float(push))), 2)
        self._write(saved)

    def sort_defaults(self) -> dict:
        """How a card is dropped into a bin (config.SORT_*), with what the tuning run saved."""
        saved = load_saved().get("sort", {})
        out = {}
        for key, name in (("pins_seconds", "SORT_PINS_SECONDS"), ("doors_seconds", "SORT_DOORS_SECONDS"),
                          ("tilt_seconds", "SORT_TILT_SECONDS")):
            v = saved.get(key, getattr(config, name))
            out[key] = float(v) if isinstance(v, (int, float)) else float(getattr(config, name))
        return out

    def save_sort(self, **timings):
        """Keep drop timings (pins_seconds, doors_seconds, tilt_seconds) from the tuning run."""
        saved = load_saved()
        sort = saved.setdefault("sort", {})
        for key in ("pins_seconds", "doors_seconds", "tilt_seconds"):
            if timings.get(key) is not None:
                sort[key] = round(min(10.0, max(0.1, float(timings[key]))), 2)
        self._write(saved)

    def set_feeder_reverse(self, on: bool):
        """For a motor fitted the other way round: "forward" then turns it backwards."""
        saved = load_saved()
        saved.setdefault("feeder", {})["reverse"] = bool(on)
        self._write(saved)

    def reset_saved(self):
        """Back to the angles and feeder settings in config.py. The old file is kept as
        machine_settings.json.bak, so a reset pressed by mistake can be undone by hand."""
        f = settings_file()
        if f.exists():
            f.replace(f.with_name(f.name + ".bak"))

    def wide_travel(self) -> bool:
        return bool(load_saved().get("wide_travel", config.SERVO_WIDE_TRAVEL))

    def home_at_startup(self) -> bool:
        return bool(load_saved().get("home_at_startup", config.HOME_AT_STARTUP))

    def set_home_at_startup(self, on: bool):
        saved = load_saved()
        saved["home_at_startup"] = bool(on)
        self._write(saved)

    def pulse_range(self) -> tuple[int, int]:
        """The servo pulse widths (microseconds) that 0 and 180 mean. ServoKit's default
        750-2250 only turns an MG90S about 130-140 real degrees; 500-2500 gives about the
        full 180. 90 is 1500 either way, so a horn fitted at 90 stays put."""
        return config.SERVO_PULSE_WIDE if self.wide_travel() else config.SERVO_PULSE

    def set_wide_travel(self, on: bool):
        saved = load_saved()
        saved["wide_travel"] = bool(on)
        self._write(saved)

    # --- servos -------------------------------------------------------------

    def set_angle(self, channel: int, angle: float | None):
        """Move one servo (0-180), or relax it with None so it stops holding."""
        if not 0 <= channel <= 15:
            raise ValueError("Channel must be 0-15")
        if angle is not None:
            angle = max(0.0, min(180.0, float(angle)))
        with self.lock:
            kit = self._fresh_servos()
            if kit is None:
                raise RuntimeError(self.servo_error)
            try:
                servo = kit.servo[channel]
                if hasattr(servo, "set_pulse_width_range"):   # cheap: no I2C, just the scale
                    servo.set_pulse_width_range(*self.pulse_range())
                servo.angle = angle
            except OSError:
                self._kit = None   # board unplugged or lost: find it again next time
                raise
            self.angles[channel] = angle
            if angle is not None:
                self._remember(channel, angle)
            old = self._relax_timers.pop(channel, None)
            if old:
                old.cancel()
            keep = {config.SERVOS[p][0] for p in getattr(config, "SERVO_KEEP_HOLDING", ())
                    if p in config.SERVOS}
            # Let go once it has had time to get there. A servo held against something it
            # can't push past draws full current and gets hot. Parts that have to keep
            # holding (the gate, the doors) still let go after SERVO_HOLD_LIMIT with no new
            # move, so one jammed at a stop can't cook its servo.
            hold = (getattr(config, "SERVO_HOLD_LIMIT", 0) if channel in keep
                    else getattr(config, "SERVO_HOLD_SECONDS", 0))
            if angle is not None and hold > 0:
                token = object()
                t = threading.Timer(hold, self._relax_after_move, (channel, token))
                t.daemon = True
                t.token = token
                self._relax_timers[channel] = t
                t.start()

    def _remember(self, channel: int, angle: float):
        """Keep the last angle sent to each servo in data/servo_last.json, so homing after
        a restart can sweep from where the part was instead of jumping."""
        last = self.last_angles()
        if last.get(str(channel)) == angle:
            return
        last[str(channel)] = angle
        try:
            config.DATA_DIR.mkdir(parents=True, exist_ok=True)
            tmp = last_angles_file().with_suffix(".tmp")
            tmp.write_text(json.dumps(last))
            tmp.replace(last_angles_file())
        except OSError:
            pass   # only a nicety: homing then just goes straight there

    def last_angles(self) -> dict:
        try:
            last = json.loads(last_angles_file().read_text())
            return last if isinstance(last, dict) else {}
        except (OSError, ValueError):
            return {}

    def _relax_after_move(self, channel, token):
        with self.lock:
            t = self._relax_timers.get(channel)
            if t is None or t.token is not token:
                return            # moved again since: that move has its own timer
            self._relax_timers.pop(channel, None)
            try:
                if self._kit is not None:
                    self._kit.servo[channel].angle = None
                    self.angles[channel] = None
            except OSError:
                self._kit = None

    def _fresh_servos(self):
        """The servo board, set up again if it lost power since we last used it.

        A PCA9685 forgets its 50 Hz setting when its power goes off and on, and wakes
        up asleep. Moves sent to it then do nothing, so check and start over if so."""
        kit = self._servos()
        if kit is None:
            return None
        try:
            asleep = kit._pca.mode1_reg & 0x10
        except (AttributeError, OSError):
            asleep = False     # can't tell (fake board in tests, or a read error): carry on
        if asleep:
            self._kit = None
            kit = self._servos()
        return kit

    def move(self, part: str, position: str):
        """Move a part to one of its named positions, e.g. move("pins", "down")."""
        try:
            channel, positions = self.servos()[part]
            angle = positions[position]
        except KeyError:
            raise ValueError(f"Unknown part or position: {part} {position}")
        moving = self.angles.get(channel) != angle
        self.set_angle(channel, angle)
        if part == "pins" and position == "up" and moving:
            self.pins_up_at = time.monotonic()

    def pins_up(self) -> float:
        """Put the stop pins up and wait until they are all the way up (config.FEED_PINS_UP_SECONDS
        after they were sent up; no wait if they were up already), so the next card can't
        arrive under a stop bar that is still rising. Returns how long it waited."""
        self.move("pins", "up")
        if self.pins_up_at is None:
            return 0.0
        left = self.pins_up_at + float(getattr(config, "FEED_PINS_UP_SECONDS", 0.6)) - time.monotonic()
        if left <= 0:
            return 0.0
        time.sleep(left)
        return round(left, 2)

    def relax_all(self):
        for channel, _ in config.SERVOS.values():
            self.set_angle(channel, None)

    def home(self, pause: float = 0.4, speed: float | None = None):
        """Every part to its home position (config.SERVO_HOME), with the saved angles, one
        at a time so they don't all draw current at once. Each one sweeps there slowly
        (config.SERVO_HOME_SPEED degrees a second) from the last angle it was sent, so
        nothing slams into a stop; a part with no last angle goes straight there."""
        speed = speed or config.SERVO_HOME_SPEED
        servos, last = self.servos(), self.last_angles()
        for part, position in config.SERVO_HOME.items():
            if part not in servos or position not in servos[part][1]:
                continue
            channel, target = servos[part][0], float(servos[part][1][position])
            start = last.get(str(channel))
            if isinstance(start, (int, float)) and speed > 0:
                steps = int(abs(target - start) // 2)            # 2 degree steps
                for i in range(1, steps + 1):
                    self.set_angle(channel, start + (target - start) * i / (steps + 1))
                    time.sleep(2 / speed)
            self.set_angle(channel, target)
            time.sleep(pause)

    def drop(self, bin_no: int, pins_seconds=None, doors_seconds=None, tilt_seconds=None, card_gone=None):
        """Send the card on the bed to a bin (config.SORT_BINS): drop the stop pins so the
        card slides onto the level tray, then open the trapdoors (bin 2) or tilt the chute
        to the side (bins 1 and 3); then put everything back. About 6 s. Nothing watches the
        camera here (sort_one in feed_watch.py does that). The tray stays level while the
        card slides: tilted first, the card turns as it comes down and catches on the rail
        (seen on the right side, 2026-11-06). `card_gone`, if given, is asked every 0.1 s
        while the pins are down and ends the wait early (after config.SORT_PINS_MIN_SECONDS
        plus a moment to clear) once it says True: sort_one passes the camera's view."""
        bins = getattr(config, "SORT_BINS", {1: "left", 2: "centre", 3: "right"})
        try:
            position = bins[int(bin_no)]
        except (KeyError, TypeError, ValueError):
            raise ValueError(f"No such bin: {bin_no!r} (bins are {', '.join(map(str, bins))})")
        defaults = self.sort_defaults()
        pins_seconds = float(defaults["pins_seconds"] if pins_seconds is None else pins_seconds)
        doors_seconds = float(defaults["doors_seconds"] if doors_seconds is None else doors_seconds)
        tilt_seconds = float(defaults["tilt_seconds"] if tilt_seconds is None else tilt_seconds)
        use_doors = int(bin_no) == getattr(config, "SORT_DOOR_BIN", 2)
        servos = self.servos()
        if "chute" not in servos or position not in servos["chute"][1]:
            raise ValueError(f"The chute has no '{position}' position: set it on the Machine page")

        def hold(where, seconds, until=None):
            # The chute lets go SERVO_HOLD_SECONDS after a move (so a stalled servo can't
            # cook); a tray left loose sags under the card, so send the angle again meanwhile.
            start = time.monotonic()
            end = start + seconds
            resend = start + 1.0
            least = start + float(getattr(config, "SORT_PINS_MIN_SECONDS", 0.5))
            while True:
                now = time.monotonic()
                if now >= end:
                    return seconds
                if until is not None and until():
                    if self.last_gone_at is None:
                        self.last_gone_at = round(now - start, 2)
                    if now >= least:
                        time.sleep(min(0.3, max(0.0, end - now)))   # let it clear the teeth
                        return round(time.monotonic() - start, 2)
                if now >= resend:
                    self.move("chute", where)
                    resend = now + 1.0
                time.sleep(min(0.1 if until is not None else 1.0, max(0.0, end - time.monotonic())))

        self.last_gone_at = None     # when card_gone first said so, seconds after pins down
        try:
            self.move("chute", "centre")
            self.move("pins", "down")
            self.last_pins_seconds = hold("centre", pins_seconds, card_gone)   # the card slides onto the level tray
            if use_doors:
                self.move("door_r", "open")
                self.move("door_l", "open")
                hold("centre", doors_seconds)
                # The card has fallen through: pins up now, while the doors close, so they
                # are all the way up before the next card is fed (Nic, 2026-11-09: after a
                # trapdoor drop the next card came while the pins were still rising).
                self.move("pins", "up")
                self.move("door_r", "closed")
                self.move("door_l", "closed")
                hold("centre", 0.4)
            else:
                # Pins back up before the tilt: a card sliding sideways off the tray caught
                # on the lowered stop bar (Nic, 2026-11-08).
                if getattr(config, "SORT_PINS_UP_BEFORE_TILT", True):
                    self.move("pins", "up")
                    hold("centre", float(getattr(config, "SORT_PINS_UP_SETTLE", 0.3)))
                self.move("chute", position)
                hold(position, tilt_seconds)        # and off the side of the tilted tray
                self._shake(servos["chute"], position)
        finally:
            self.move("chute", "centre")
            self.move("pins", "up")

    def _shake(self, chute, position, shakes=None, seconds=None):
        """Rock the tilted tray half way back towards level and tilt it again, a few times
        (config.SORT_TILT_SHAKES), so a card left on the tray slides off. Half way, not level:
        a card nearly off the edge shouldn't slide back into the middle."""
        shakes = int(getattr(config, "SORT_TILT_SHAKES", 0) if shakes is None else shakes)
        seconds = float(getattr(config, "SORT_SHAKE_SECONDS", 0.4) if seconds is None else seconds)
        channel, positions = chute
        if shakes <= 0 or "centre" not in positions:
            return
        tilted, level = float(positions[position]), float(positions["centre"])
        half = round(level + (tilted - level) / 2, 1)
        # Each shake tilts further than the saved tilt (Nic, 2026-11-08: "a bigger angle when
        # it shakes"), by config.SORT_SHAKE_EXTRA degrees away from level.
        extra = float(getattr(config, "SORT_SHAKE_EXTRA", 0.0))
        side = 1.0 if tilted >= level else -1.0
        deeper = round(max(0.0, min(180.0, tilted + side * extra)), 1)
        for _ in range(shakes):
            self.set_angle(channel, half)
            time.sleep(seconds)
            if extra > 0:
                self.set_angle(channel, deeper)
            else:
                self.move("chute", position)
            time.sleep(seconds)
        if extra > 0:
            self.move("chute", position)

    def self_test(self, pause: float = 0.6) -> list[dict]:
        """Moves every servo through its positions and back, then nudges the feeder.
        Returns what worked, one line per part, for the Maintenance page."""
        report = []
        for part, (channel, positions) in self.servos().items():
            try:
                names = list(positions)
                for pos in names + names[:1]:      # through each one, then back to the first
                    self.move(part, pos)
                    time.sleep(pause)
                self.set_angle(channel, None)
                report.append({"part": part, "ok": True, "detail": "moved to " + ", ".join(names)})
            except (RuntimeError, OSError, ValueError) as e:
                report.append({"part": part, "ok": False, "detail": str(e)})
        try:
            self.feed(seconds=0.3, speed=0.6)
            time.sleep(0.4)
            report.append({"part": "feeder", "ok": True, "detail": "turned for 0.3 seconds"})
        except (RuntimeError, OSError, ValueError) as e:
            report.append({"part": "feeder", "ok": False, "detail": str(e)})
        return report

    # --- feeder -------------------------------------------------------------

    def feed(self, seconds: float = None, speed: float = None, backward: bool = False):
        """Turn the feeder roller for a moment, then stop on its own."""
        defaults = self.feeder_defaults()
        seconds = min(5.0, max(0.05, float(seconds or defaults["seconds"])))
        speed = min(1.0, max(0.1, float(speed or defaults["speed"])))
        with self.lock:
            motor = self._feeder()
            if motor is None:
                raise RuntimeError(self.feeder_error)
            if self._stop_timer:
                self._stop_timer.cancel()
            if defaults["reverse"]:
                backward = not backward
            (motor.backward if backward else motor.forward)(speed)
            self.feeding = True
            self._stop_timer = threading.Timer(seconds, self.stop_feeder)
            self._stop_timer.daemon = True
            self._stop_timer.start()

    def stop_feeder(self):
        with self.lock:
            if self._stop_timer:
                self._stop_timer.cancel()
                self._stop_timer = None
            if self._motor is not None:
                self._motor.stop()
            self.feeding = False

    # --- for the page -------------------------------------------------------

    def state(self) -> dict:
        servos, defaults = self.servos(), self.feeder_defaults()
        with self.lock:
            self._servos()
            self._feeder()
            return {
                "servos": {"ok": self._kit is not None, "error": self.servo_error},
                "feeder": {"ok": self._motor is not None, "error": self.feeder_error,
                           "running": self.feeding},
                "parts": {part: {"channel": ch, "positions": pos,
                                 "factory": config.SERVOS[part][1],
                                 "angle": self.angles.get(ch)}
                          for part, (ch, pos) in servos.items()},
                "feeder_defaults": defaults,
                "sort_defaults": self.sort_defaults(),
                "wide_travel": self.wide_travel(),
                "home_at_startup": self.home_at_startup(),
                "customized": settings_file().exists(),
            }


def add_machine_routes(app, machine: Machine, web_dir):
    """The Machine page and its API, added to the scanner app."""

    @app.get("/machine")
    def machine_page():
        return send_from_directory(web_dir, "machine.html")

    def answer(action):
        try:
            action()
        except (ValueError, TypeError) as e:
            return jsonify(error=str(e)), 400
        except RuntimeError as e:
            return jsonify(error=str(e)), 503
        return jsonify(machine.state())

    @app.get("/api/machine")
    def machine_state():
        return jsonify(machine.state())

    @app.post("/api/machine/move")
    def machine_move():
        body = request.get_json(silent=True) or {}
        if "angle" in body:
            return answer(lambda: machine.set_angle(int(body.get("channel", -1)), body["angle"]))
        return answer(lambda: machine.move(str(body.get("part")), str(body.get("position"))))

    @app.post("/api/machine/home")
    def machine_home():
        return answer(machine.home)

    @app.post("/api/machine/relax")
    def machine_relax():
        return answer(machine.relax_all)

    @app.post("/api/machine/feed")
    def machine_feed():
        body = request.get_json(silent=True) or {}
        return answer(lambda: machine.feed(body.get("seconds"), body.get("speed"),
                                           bool(body.get("backward"))))

    @app.post("/api/machine/stop")
    def machine_stop():
        return answer(machine.stop_feeder)

    @app.post("/api/machine/drop")
    def machine_drop():
        """Send the card on the bed to a bin (no feeding, no camera)."""
        body = request.get_json(silent=True) or {}
        return answer(lambda: machine.drop(body.get("bin"), body.get("pins_seconds"),
                                           body.get("doors_seconds"), body.get("tilt_seconds")))

    @app.post("/api/machine/save")
    def machine_save():
        """Keep an angle as a named position, or the feeder's seconds and speed."""
        body = request.get_json(silent=True) or {}
        if "part" in body:
            return answer(lambda: machine.save_position(str(body["part"]), str(body.get("position")),
                                                        body.get("angle")))
        if "home_at_startup" in body:
            return answer(lambda: machine.set_home_at_startup(bool(body["home_at_startup"])))
        if "wide_travel" in body:
            return answer(lambda: machine.set_wide_travel(bool(body["wide_travel"])))
        if "sort" in body:
            return answer(lambda: machine.save_sort(**(body["sort"] if isinstance(body["sort"], dict) else {})))
        if "reverse" in body and "seconds" not in body:
            return answer(lambda: machine.set_feeder_reverse(bool(body["reverse"])))
        return answer(lambda: machine.save_feeder(body.get("seconds"), body.get("speed"),
                                                  body.get("backoff"), body.get("push")))

    @app.post("/api/machine/reset")
    def machine_reset():
        return answer(machine.reset_saved)

    @app.post("/api/machine/test")
    def machine_test():
        report = machine.self_test()
        return jsonify(machine.state() | {"test": report})


def home_at_startup(machine: Machine, tries: int = 3, wait: float = 5.0):
    """Run once when the app starts (app.py main): put every part in its home position with
    the saved angles, unless that's turned off on the Machine page. The servo board can
    take a moment to show up after boot, so it tries a few times."""
    if not machine.home_at_startup():
        return
    for attempt in range(tries):
        try:
            machine.home()
            print("Machine: every part is at its home position.")
            return
        except (RuntimeError, OSError, ValueError) as e:
            error = e
            if attempt < tries - 1:
                time.sleep(wait)
    print(f"Machine: couldn't go to the home positions at startup ({error}).")
