OutMyFocus/HomeLab/mtg-sorter/mtgscanner/camera.py

"""The webcam, opened the fast way and read in the background.

Used by app.py and scan.py. Two things here make a big difference to speed:

1. The format. Over USB a webcam can only send about 5 uncompressed 1080p pictures a
   second, but 30 compressed (MJPG) ones. OpenCV's Windows driver drops back to the
   uncompressed format whenever the size or frame rate is set, so MJPG is asked for LAST.
2. The newest picture. A webcam produces pictures whether or not anyone is looking. If
   the scanner asked for "the next one" each time, it would be handed pictures taken
   while it was busy and fall further and further behind. A small thread keeps reading
   the camera, and the scanner is handed the newest picture whenever it asks.
"""

import sys
import threading
import time

import cv2

from . import config

# Each system's own camera driver. On Windows, DirectShow opens a webcam in about a
# second where OpenCV's default can take 20.
BACKEND = {"win32": cv2.CAP_DSHOW, "linux": cv2.CAP_V4L2, "darwin": cv2.CAP_AVFOUNDATION}.get(sys.platform, cv2.CAP_ANY)


# The Raspberry Pi camera (Camera Module 3 on the ribbon cable) has no webcam number, and
# OpenCV can't open it on a Pi 5: it goes through picamera2 instead. It's listed as this number.
PI_CAMERA = -1
# Video nodes the Pi's camera chip and image processor show on Linux. They aren't webcams.
NOT_WEBCAMS = ("rp1-cfe", "pispbe", "rpi-hevc", "bcm2835")


def pi_camera_present() -> bool:
    try:
        from picamera2 import Picamera2
        return bool(Picamera2.global_camera_info())
    except Exception:   # not a Pi, or picamera2 not installed
        return False


def list_cameras() -> list[dict]:
    """The cameras plugged in, with their names (e.g. "Brio 101"). The Pi camera comes first."""
    pi = [{"index": PI_CAMERA, "name": "Pi camera"}] if pi_camera_present() else []
    try:
        from cv2_enumerate_cameras import enumerate_cameras
        cams = [{"index": c.index, "name": c.name} for c in enumerate_cameras(BACKEND)]
    except Exception:   # library missing or unsupported here: just number them
        return pi + ([] if pi else [{"index": i, "name": f"Camera {i}"} for i in range(3)])
    seen, unique = set(), []
    for c in cams:      # Linux lists some cameras twice (one per video node)
        if c["name"] not in seen and not any(n in c["name"] for n in NOT_WEBCAMS):
            seen.add(c["name"])
            unique.append(c)
    return pi + unique


# Focus for the Pi camera (Camera Module 3 has autofocus). None keeps refocusing on its
# own; a number locks the lens at that many cm, e.g. 12 for the scan bed (the lens sits
# 120 mm above the card). Picked on the scanner page and kept in app_settings.json; the
# app sets this at startup so a camera opened later starts with it.
focus_cm: float | None = None
FOCUS_CHOICES_CM = (8, 10, 12, 14, 16, 18, 20, 25, 30, 40, 60)


def focus_controls(cm: float | None) -> dict:
    """libcamera controls for a focus setting. Auto uses the FULL range: the default
    ("Normal") range skips the closest distances, which is where cards are."""
    if cm is None:
        return {"AfMode": 2, "AfRange": 2, "AfSpeed": 1}   # Continuous, Full range, Fast
    return {"AfMode": 0, "LensPosition": 100.0 / float(cm)}  # Manual; the lens takes 1/metres


class PiCapture:
    """The Pi camera, behaving like the bits of cv2.VideoCapture this module uses."""

    def __init__(self):
        from picamera2 import Picamera2
        self.cam = Picamera2()
        size = config.CAMERA_SIZE
        try:
            # picamera2's "RGB888" is laid out blue-green-red in memory, which is what OpenCV expects.
            self.cam.configure(self.cam.create_video_configuration(
                main={"size": size, "format": "RGB888"}, controls={"FrameRate": 30}))
            self.cam.start()
        except Exception:
            # Let go of the camera, or every later try fails with "Camera in Configured
            # state trying acquire()" and the app never gets it back without a restart.
            self.cam.close()
            raise
        self.size = size
        # Cameras without autofocus (Camera Module 2, HQ) have no AfMode control.
        self.has_focus = "AfMode" in getattr(self.cam, "camera_controls", {})
        self.focus_cm = None
        self.set_focus(focus_cm)

    def set_focus(self, cm: float | None):
        if not self.has_focus:
            return
        try:
            self.cam.set_controls(focus_controls(cm))
            self.focus_cm = cm
        except Exception as e:
            print(f"Couldn't set the Pi camera's focus: {e}")

    def read(self):
        try:
            return True, self.cam.capture_array("main")
        except Exception:
            return False, None

    def get(self, prop):
        return {cv2.CAP_PROP_FRAME_WIDTH: self.size[0], cv2.CAP_PROP_FRAME_HEIGHT: self.size[1],
                cv2.CAP_PROP_FOURCC: int.from_bytes(b"PICM", "little")}.get(prop, 0)

    def release(self):
        self.cam.stop()
        self.cam.close()


def open_camera(index: int) -> cv2.VideoCapture:
    """Open a webcam at the size in config.py, compressed, at 30 pictures a second.
    PI_CAMERA opens the Raspberry Pi camera instead."""
    if index == PI_CAMERA:
        try:
            return PiCapture()
        except Exception as e:
            raise RuntimeError(f"Could not open the Pi camera ({e}).") from None
    cap = cv2.VideoCapture(index, BACKEND)
    if not cap.isOpened():
        cap.release()
        raise RuntimeError(f"Could not open camera {index}.")
    cap.set(cv2.CAP_PROP_FRAME_WIDTH, config.CAMERA_SIZE[0])
    cap.set(cv2.CAP_PROP_FRAME_HEIGHT, config.CAMERA_SIZE[1])
    cap.set(cv2.CAP_PROP_FPS, 30)
    cap.set(cv2.CAP_PROP_FOURCC, cv2.VideoWriter_fourcc(*"MJPG"))   # last, see above
    return cap


def describe(cap: cv2.VideoCapture) -> tuple[str, tuple[int, int]]:
    """(format such as "MJPG", (width, height)) the camera actually agreed to."""
    fourcc = int(cap.get(cv2.CAP_PROP_FOURCC)).to_bytes(4, "little").decode("ascii", "replace")
    return fourcc, (int(cap.get(cv2.CAP_PROP_FRAME_WIDTH)), int(cap.get(cv2.CAP_PROP_FRAME_HEIGHT)))


class CameraSource:
    """A webcam that always hands out its NEWEST picture (see the module docstring)."""

    def __init__(self, index: int, name: str | None = None):
        self.index, self.name = index, name or f"Camera {index}"
        try:
            self.cap = open_camera(index)
        except RuntimeError as e:
            # Keep the reason (e.g. "Cannot allocate memory") so the log says what went wrong.
            reason = str(e).partition("(")[2].rstrip(".)")
            raise RuntimeError(f"Could not open {self.name}" + (f" ({reason})." if reason else ".")) from None
        self.format, self.size = describe(self.cap)
        self._cond = threading.Condition()
        self._frame, self._seq, self._given, self._stop = None, 0, 0, False
        self.taken_at = 0.0          # when the newest picture was taken (time.monotonic)
        self.camera_fps = None       # how many pictures a second the camera really delivers
        self._thread = threading.Thread(target=self._pump, name="camera", daemon=True)
        self._thread.start()

    def _pump(self):
        # All camera calls happen on this one thread (OpenCV's camera isn't thread-safe).
        # cap.read() waits for the camera's next picture, so this loop runs at its pace.
        count, since, failures = 0, time.monotonic(), 0
        while not self._stop:
            ok, frame = self.cap.read()
            if not ok:
                failures += 1
                time.sleep(0.05 if failures < 20 else 0.5)
                continue
            failures = 0
            now = time.monotonic()
            count += 1
            if now - since >= 2.0:       # a webcam slows down in dim light; the page shows that
                self.camera_fps, count, since = count / (now - since), 0, now
            with self._cond:
                self._frame, self.taken_at, self._seq = frame, now, self._seq + 1
                self._cond.notify_all()

    def read(self, timeout: float = 2.0):
        """The newest picture not handed out yet (None if the camera stops sending)."""
        with self._cond:
            seq = self._given
            if not self._cond.wait_for(lambda: self._seq > seq or self._stop, timeout):
                return None
            self._given = self._seq
            return self._frame

    def info(self) -> dict:
        out = {"index": self.index, "name": self.name, "format": self.format, "size": list(self.size)}
        if self.camera_fps is not None:
            out["fps"] = round(self.camera_fps, 1)
        if getattr(self.cap, "has_focus", False):
            out["focus"] = {"cm": self.cap.focus_cm, "choices": list(FOCUS_CHOICES_CM)}
        return out

    def set_focus(self, cm: float | None) -> bool:
        """Change the focus now (Pi camera with autofocus only). False if it has none."""
        if not getattr(self.cap, "has_focus", False):
            return False
        self.cap.set_focus(cm)
        return True

    def release(self):
        self._stop = True
        with self._cond:
            self._cond.notify_all()
        self._thread.join(timeout=2.0)
        self.cap.release()


class BrowserSource:
    """A camera on the phone or computer that has the page open. The browser sends its
    pictures to /api/frame and this hands each new one to the scanner, so scanning works
    from any device, not just the one the scanner runs on. The token tells the pictures of
    one device from another's: only the device that picked this camera can send."""

    index = "browser"       # what /api/camera is sent to pick it (webcams have numbers)
    format = "JPEG"
    gone_after = 15.0       # seconds without a picture before the scanner gives up on it

    def __init__(self, token: str, name: str | None = None):
        self.token, self.name = token, name or "This device's camera"
        self._cond = threading.Condition()
        self._frame, self._seq, self._given, self._stop = None, 0, 0, False
        self.size = None            # (width, height) of the pictures, known from the first one
        self.taken_at = 0.0         # when the newest picture arrived (time.monotonic)
        self.last_seen = time.monotonic()
        self.camera_fps = None
        self._count, self._since = 0, time.monotonic()

    def push(self, frame):
        """A new picture from the browser (a decoded OpenCV image)."""
        now = time.monotonic()
        self._count += 1
        if now - self._since >= 2.0:
            self.camera_fps, self._count, self._since = self._count / (now - self._since), 0, now
        with self._cond:
            self._frame, self.taken_at, self.last_seen, self._seq = frame, now, now, self._seq + 1
            self.size = (frame.shape[1], frame.shape[0])
            self._cond.notify_all()

    def read(self, timeout: float = 2.0):
        """The newest picture not handed out yet (None if the browser stops sending)."""
        with self._cond:
            seq = self._given
            if not self._cond.wait_for(lambda: self._seq > seq or self._stop, timeout) or self._stop:
                return None
            self._given = self._seq
            return self._frame

    def quiet_for(self) -> float:
        """Seconds since the browser last sent a picture."""
        return time.monotonic() - self.last_seen

    def gone(self) -> bool:
        """True once the browser has been silent long enough to count as closed."""
        return self.quiet_for() > self.gone_after

    def info(self) -> dict:
        out = {"index": self.index, "name": self.name, "format": self.format,
               "size": list(self.size) if self.size else None, "browser": True}
        if self.camera_fps is not None:
            out["fps"] = round(self.camera_fps, 1)
        return out

    def release(self):
        self._stop = True
        with self._cond:
            self._cond.notify_all()
