OutMyFocus/HomeLab/(commit log)

2026-10-21 Add MTG card scanner: Scryfall fingerprint DB, webcam recognition, price bins
    Recognizes cards by perceptual hash against a database built from Scryfall,
    sorts them into price bins, and writes a ManaBox-format CSV that Commander
    Vault can import.
    Claude-Session: https://claude.ai/code/session_01SBL5T46nM7TcmL5qtkW22s
2026-10-21 Use Commander Vault CAD prices; detect cards on busy backgrounds
    - Detection now tries edges, low saturation and dark-border masks, plus
    slightly grown outlines, and keeps whichever matches the database best.
    On real photos on a wood table, 4 of 5 cards are recognized (was 1).
    - Prices are CAD: exact-printing price from Commander Vault, then Face to
    Face Games, then the cheapest other store, then Scryfall USD converted.
    Vault data is read from data/vault_prices.json, which is gitignored.
    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
2026-10-21 README: get Vault prices with the Save prices for scanner button
    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
2026-10-21 Move MTG scanner back to its own branch
    Reverts the merge of claude/mtg-scanner. The scanner stays on that branch.
    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
    [collection.py, config.py, database.py, sorting.py, test_scanner.py, vault_prices.py]
2026-10-21 Add 3D-printable scan station (base, post, camera head)
    Holds a Pi Camera Module 3 120 mm above a white card pocket, lit from
    LED strips on two side walls so glossy and foil cards don't reflect a
    glare spot into the lens. Parametric OpenSCAD source plus STLs; all
    parts print without supports on a 256 mm bed.
    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
    [scan_station.scad, scan_station_base.stl, scan_station_head.stl, scan_station_post.stl]
2026-10-21 Add feeder test rig and full sifter concept layout
    The feeder (hopper, O-ring pick roller on an N20 motor, adjustable gate) is
    the first piece of a Roca Sifter-style machine and is built to be tested on
    its own. sifter_concept.scad shows the planned layout: hopper, sloped scan
    bed with a stop gate, side-mounted camera tower, tilting chute, 3 bins.
    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
    [feeder_gate.stl, feeder_hopper.stl, feeder_roller.stl, feeder_stand.stl, feeder_test.scad, sifter_concept.scad]
2026-10-21 Clean finished-product concept of the sifter
    sifter_concept.scad now shows the outside: rounded body, pull-out bins,
    hopper with a card-count window, camera arm over a sloped scan bay. The
    open-frame mechanism layout moves to sifter_inside.scad.
    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
    [sifter_concept.scad, sifter_inside.scad]
2026-10-21 Sifter concept: all-black body
    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
    [sifter_concept.scad]
2026-10-21 Add scan bed + chute design and a shopping list
    bed_chute.scad: sloped white scan bed with retractable stop pins and side
    LED walls, camera tower square to the bed, and a chute that tilts 25 deg
    to bins 1/3 or opens two trapdoors into bin 2. 17 printable parts, all
    flat with no supports and within a 256 mm bed. Moving parts checked for
    collisions in OpenSCAD at both ends of travel.
    Also: a tall feeder stand that lines the feeder up with the bed, and
    SHOPPING.md with everything to order.
    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
    [bed_chute.scad, bed_chute_bed_plate.stl, bed_chute_bed_side_left.stl, bed_chute_bed_side_right.stl, bed_chute_bin.stl, bed_chute_camera_head.stl, bed_chute_chute.stl, bed_chute_frame_side.stl]
2026-10-21 Add browser app for the scanner; Amazon links in the shopping list
    app.py serves a dark, phone-friendly page: live camera with the card
    outlined, the recognized card's picture, CAD price and bin, save / foil /
    auto-save, a session list with per-bin totals, undo and CSV download, and
    a Photos tab that recognizes dropped-in pictures. --demo cycles a folder of
    photos so it runs without a webcam. Recognition moves to
    mtgscanner/recognize.py so scan.py and the app share it, and the database
    connection is now safe to use from the app's two threads.
    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
2026-10-22 Scanner app: live prices, printing picker, and pricing fixes
    - Look up today's Scryfall price for each recognized card (cached, in the
    background) and convert at the Bank of Canada's daily USD/CAD rate.
    Falls back to database prices and USD_TO_CAD when offline or --offline.
    - "Wrong printing?" picker lists every printing with its price; picking one
    swaps an already-saved row. "Find a card by name" for unrecognized cards.
    - Use the other finish's price when the chosen one is missing (foil-only,
    etched), instead of dropping the card into the unknown-price bin.
    - Photos tab re-prices when Foil is ticked; bin labels come from config.
    - CSV gets a "Bin number" column (older files are upgr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
    [collection.py, config.py, database.py, live.py, sorting.py]
2026-10-22 Scanner test pass: exact card outlines, safer thresholds, sturdier app
    Recognition (measured on 436 real Dominaria United cards plus synthetic
    photos on white, gray, black, wood and playmat tables):
    - Fit straight lines to each side of the card outline and intersect them.
    The rough polygon cut across rounded corners and landed a few pixels
    inside the card, which on a white table pushed match distances from ~2
    to ~23 bits and caused misses. Now every background matches at ~2.
    - Count near-black pixels as unsaturated in the saturation mask so the
    black border survives sensor noise. Fixes 5 of 40 misses on wood.
    - Lower the minimum card size from 5% to 1.5% of the frame so a card
    far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
    [collection.py, config.py, database.py, live.py, vault_prices.py, vision.py]
2026-10-22 Add a step-by-step assembly guide for the feeder test and full machine
    Claude-Session: https://claude.ai/code/session_014WgUiXvyTqoErhJrryngCx
2026-10-22 Shopping list: solder and flux for header pins
    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
2026-10-23 Assembly guide: Raspberry Pi setup steps, and note the app can't read the Pi camera yet
    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
2026-10-24 Scanner: use the Pi camera, and keep the Pi updated from GitHub
    Adds a picamera2 camera source (the Camera Module 3 on a Pi 5 can't be opened
    through OpenCV), picked automatically when a Pi camera is present. app.py and
    scan.py take --camera pi / auto / <webcam number>.
    Adds an update timer that pulls main every 5 minutes, reinstalls packages and
    service files when they change, and restarts the app. The app service now uses
    the camera instead of demo photos and listens on the home network too.
2026-10-24 Add Roca-style enclosure concept for the sorter
    A preview-only OpenSCAD picture of the sorter as an enclosed countertop box:
    drawer dock at the front for Nic's storage drawers, sunken scan bay in the
    top deck, hopper tower at the back and a covered camera arm. The mechanism
    inside is unchanged.
    Claude-Session: https://claude.ai/code/session_01DYiWi8mKjwQMLYhpga4BtK
    [enclosure_concept.scad]
2026-10-25 Add printable Roca-style enclosure with storage-drawer bins
    A shell of corner posts, flat panels, floor and deck tiles around the existing
    mechanism. The bed walls, chute and feeder now stand on a bridge plate above
    three drawers that fit Nic's MakerWorld card storage cubbies and carry a
    toploader pocket in the front. The Pi and servo board get a bay at the back.
    The drawer size is a placeholder (80 x 100 x 250 mm) until it is measured from
    the MakerWorld file; export_enclosure.sh regenerates every STL after that.
    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
    [bed_chute.scad, bed_chute_bed_side_left_enclosure.stl, bed_chute_bed_side_right_enclosure.stl, enc_back.stl, enc_bridge_back.stl, enc_bridge_front.stl, enc_deck_bl.stl, enc_deck_br.stl]
2026-10-25 Enclosure polish: base plate, chamfered deck, panel lines, light bar, airflow
    The floor is now a full base plate the posts peg into and the panels stand
    in, with recesses for rubber feet and intake slots under the Pi. The deck
    gets a 2 mm chamfer on its edges and openings, every tile seam gets a small
    V so it reads as a panel line, and the fascia gets a light slot with a white
    light bar behind it for a piece of the LED strip.
    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
    [enc_back.stl, enc_bridge_back.stl, enc_bridge_front.stl, enc_deck_bl.stl, enc_deck_br.stl, enc_deck_fl.stl, enc_deck_fr.stl, enc_divider.stl]
2026-10-25 Size the enclosure dock to the Card Catalog v1.2 drawers
    Measured Nic's Card Catalog 3MF (tray 76 x 67.4 x 223, front plate
    86 x 109 x 8, plates at 86.5 mm pitch in an 8 mm rebate) and replaced the
    placeholder drawer with it. The dock now copies the Card Catalog box: three
    plates side by side between the front posts, flush with the fascia, trays
    running between guide curbs on the floor, fascia starting 114 mm up.
    The shell grows to 291.5 mm wide, so the fascia is three pieces (seams above
    the gaps between the plates, one light slot per bay, the light bar glued
    across the seams) and the back panel is two. Front and back posts are now
    separate parts (the front ones' fascia groove stops above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
    [card_catalog_drawer.scad, enc_back.stl, enc_back_l.stl, enc_back_r.stl, enc_bridge_back.stl, enc_bridge_front.stl, enc_deck_bl.stl, enc_deck_br.stl]
2026-10-25 Add PRINTING.md: enclosure print order and slicer settings
    Plate-by-plate order for the A1 (25 plates, three fit-check plates first),
    Bambu Studio settings per part, colours and filament totals, what to check
    after the fit-check plates, and how to print the Card Catalog drawers from
    the MakerWorld 3MF. Linked from the README's Enclosure section and ASSEMBLY
    Part 3.
    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
2026-10-25 PRINTING.md: say which STLs the enclosure build uses and how to import them
    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
2026-10-25 Remove the retired scan station, open frame and bin files
    The enclosure replaced the first camera stand (scan_station_*), the open
    frame and bins (bed_chute_frame_side, front_bar, bin), the plain bed walls
    and the short and tall feeder stands, so stl/ now holds only the parts that
    get printed. The concept SCAD files go with them. README, ASSEMBLY and
    PRINTING no longer point at the removed files.
    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
    [bed_chute_bed_side_left.stl, bed_chute_bed_side_right.stl, bed_chute_bin.stl, bed_chute_frame_side.stl, bed_chute_front_bar.stl, enclosure_concept.scad, feeder_stand.stl, feeder_stand_tall.stl]
2026-10-25 Add a Bambu Studio project with every enclosure plate set up
    bambu/MTG_Sorter_Enclosure.3mf opens with File > Open Project: 23 plates in
    PRINTING.md order, each part laid out on its plate, the A1 0.20 mm Standard
    profile with PRINTING.md's changes, and per-part overrides (4 walls/25 % for
    structural parts, brim on the tall ones, 100 % for splices and the light bar).
    bambu/presets/ has the same settings as importable process presets.
    make_project.py rebuilds both from stl/ after a re-export.
    PRINTING.md is renumbered to the project's plates, the drawers are listed
    separately, and colours are black and white only.
    Claude-Session: https: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
    [MTG_Sorter_Enclosure.3mf]
2026-10-28 Add a picture assembly guide for the enclosure build
    Every step is rendered from the enclosure CAD (guide/scenes.scad, rendered with
    OpenSCAD by guide/render.py), with the new parts in orange, the rest in grey, arrows
    and numbered callouts, plus a wiring diagram. guide/build_guide.py writes
    ASSEMBLY_PICTURES.md for GitHub and assembly_guide.html as one self-contained file.
    Checking ASSEMBLY.md against the CAD turned up three fixes, made in the text docs:
    - the deck can't be lowered over the camera head, so the head goes on after the deck
    - deck_bl and deck_br have no splice between them; they go on as two pieces
    - the build uses 24 splices, not 10, and the PCA9685 needs 4 more M2.5 screws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
    [enclosure.scad, scenes.scad]
2026-10-28 Add the front-right corner post (mirror of post_front)
    The front posts are not symmetric: the fascia groove stops short so the drawer
    plate can pass, and only one face has that. The right-hand post is the mirror
    image, so printing post_front twice gave two left posts. enclosure.scad gets
    epart=post_front_r, export_enclosure.sh exports it, and README, PRINTING,
    ASSEMBLY and the picture guide say which post goes where. Back posts are
    symmetric and stay one part.
    Claude-Session: https://claude.ai/code/session_0128qTvhDrHjg4TBry49fJB4
    [enc_post_front_r.stl, enclosure.scad]
2026-10-28 Move the Pi clear of the right rear bridge leg
    The right rear leg stands at x 38..52, y 246..260 on the floor, right where the
    Pi's back corner was (pi_pos x = 40). Pi moves to x = 57 (standoffs and the back
    panel's port cut-out follow it), and the motor driver's zip-tie slots move away
    from the left leg's boss, which they cut through. Re-exported floor_br, floor_bl
    and back_r; the picture guide shows the Pi with its real port layout.
    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
    [enc_back_r.stl, enc_floor_bl.stl, enc_floor_br.stl, enclosure.scad, scenes.scad]
2026-10-28 Add leg_offset: right rear leg stand-in for floors with the Pi under its boss
    Stands on the bare floor just left of the Pi and reaches over to the leg's bridge hole
    with an L-shaped arm that stays out of the camera ribbon slot. Prints upright, no supports.
    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
    [enc_leg_offset.stl, enclosure.scad]
2026-10-30 Start the app without a camera and say so on the page
    If no camera opens at startup, the app used to exit, so the systemd
    service restart-looped and the page never loaded. Now it starts anyway,
    shows "No camera found" on the page, and retries every few seconds,
    handing the camera to the scanner once one opens.
2026-10-30 Add a Machine page to test the servos and feeder from the web app
    New mtgscanner/machine.py drives the four servos on the PCA9685 (I2C) and
    the feeder's N20 motor on the DRV8833 (GPIO17/27), using the pins from
    hardware/ASSEMBLY.md. It connects on first use and reports what's missing
    instead of failing, so the app still runs on a PC or an unwired Pi.
    /machine has buttons for each part's named positions, a slider per servo
    to find the right angles, and feed/backwards/stop for the roller. Angles
    and feeder timing live in config.py.
    Claude-Session: https://claude.ai/code/session_0128qTvhwhinNqH7ec2JvWFx
    [config.py, machine.py, test_machine.py]
2026-10-30 Pin rocker takes the double-arm horn (screw holes on both sides of the hub)
    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
2026-10-30 Pin rocker: screw the horn to the rocker before it goes on the servo
    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
2026-10-30 Guide: say which wall groove the bed plate goes in
    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
2026-10-30 Fix the bed-plate groove in the bed walls
    The groove cube sat just outside the wall's inner face (side_in - 2 .. side_in), so it
    cut nothing and the walls printed with only the LED groove. It now cuts 2 mm into the
    wall. Re-exported both enclosure bed walls.
    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
    [bed_chute.scad, bed_chute_bed_side_left_enclosure.stl, bed_chute_bed_side_right_enclosure.stl]
2026-10-30 Chute: door carriers replace the separate trapdoor mounts and hinge lugs
    Each side's servo mount and hinge lug are now one part on a bar along the tray floor's
    outer edge, held by 3 M2 screws, so the servo shaft and hinge pin stay in line. The chute
    gets the matching holes (the old ones stay). Guide step 13 shows the carriers.
    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
    [bed_chute.scad, bed_chute_chute.stl, bed_chute_door_carrier.stl, bed_chute_door_carrier_left.stl, bed_chute_trapdoor.stl, bed_chute_trapdoor_left.stl, scenes.scad]
2026-10-30 Add one-plate chute print (chute, trapdoors, door carriers)
    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
    [MTG_Sorter_Chute.3mf]
2026-10-30 Feeder stand: clear the scan bed
    The stand's front 32 mm reached in under the back of the sloped bed and pushed the bed
    plate up by as much as 13 mm, so the stop pins missed the notches; the hopper's shelf also
    sat on the bed's back edge. The stand is now cut away under the bed (bed_cut, 2 mm clear)
    and 4 mm taller (96), so the hopper clears the bed's rails. One-plate print in
    bambu/MTG_Sorter_Feeder_Stand.3mf.
    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
    [MTG_Sorter_Feeder_Stand.3mf, enclosure.scad, feeder_stand_mid.stl, feeder_test.scad]
2026-10-31 Add the Pi 5 PWM library the servo board needs
    On a Pi 5, adafruit_servokit fails to load without
    Adafruit-Blinka-Raspberry-Pi-PWM, so the Machine page's servo buttons
    showed "Servo board not found" on a fresh install.
2026-10-31 Add a Maintenance page, one-command setup, and safer auto-updates
    - Maintenance page (/maintenance, wrench button): plain-language check-up
    (power/undervoltage, temperature, camera, servo board, feeder, database,
    Wi-Fi, internet, storage, memory, updates) with a fix for each problem;
    restart app, reboot, shut down, update now, fix stuck updates, auto-update
    switch, moving-parts self-test, Wi-Fi status and saved networks, backup
    download and restore, and logs.
    - Machine page saves servo angles and feeder settings to
    data/machine_settings.json, so config.py never needs editing on the Pi.
    - deploy/mtg-sorter-admin: the only root helper the app may run (via a
    sudoers rule), with a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
    [config.py, machine.py, system.py, test_system.py]
2026-10-31 Add a Collection page, live Scryfall prices and an Other printing picker
    Collection page (/collection, mtgscanner/library.py):
    - Every saved card grouped by printing and finish, priced with today's prices.
    - Search, filters (color, rarity, set, bin, foil, price range), 10 sort orders,
    picture grid or list view.
    - Card details: change copies, foil, printing, delete; add a card by hand.
    - Stats: totals, change since scanned, most valuable, value over time (one point
    a day in data/price_history.json), breakdown by color/rarity/bin/set.
    - Exports: Moxfield, Archidekt, Deckbox, ManaBox/Commander Vault, TCGplayer mass
    entry, text list, names only, spreadsheet with prices; all or just the
    f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
2026-10-31 Add a Decks page (decklist vs collection) and a Bins page (sorting rules)
    Decks (/decks, mtgscanner/decks.py):
    - Reads decklists from Moxfield, Archidekt, Arena, MTGO and plain text
    (quantities, 4x, set codes, *F*, SB:, section headers, double-faced names).
    - Shows what you own (any printing, copies shared across sections), what's
    missing, cost to finish at today's prices (Scryfall by name, 75 per
    request, else the cheapest printing in the database), which bin your copies
    are in, and names it couldn't find.
    - Copy the missing cards as a shopping list; save decks in data/decks.json.
    Bins (/bins, mtgscanner/sort_rules.py, mtgscanner/bins.py):
    - Rules by price range, color, rarity, set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
    [bins.py, decks.py, library.py, live.py, sort_rules.py, sorting.py, test_decks_bins.py]
2026-10-31 Web app: session history, wishlist, valuable-card alerts, PIN lock and a pages menu
    - History page: sessions split on half-hour gaps, cards per day chart, per-session export and delete
    - Wishlist page: target prices, deals, already-owned, scanner banner and chime for wanted cards
    - Settings page: valuable-card alert, sound, and an optional PIN lock for other devices (the Pi is never locked)
    - Scanner: a menu listing every page, wishlist badge and alert banner
    - Decks: add the missing cards to the wishlist
    Claude-Session: https://claude.ai/code/session_0128qTvf1xs8zWBD7XnMCph9
    [history.py, security.py, test_extras.py, wishlist.py]
2026-11-01 Add RGB light bar controls (Lights page, SPI driver, scan flashes)
    Drives 5 V WS2812 "3-pin ARGB" bars from GPIO10 (SPI MOSI) with no extra
    package, since rpi_ws281x doesn't work on a Pi 5. Optional: without SPI or
    bars the page says why and still shows a live preview.
    - mtgscanner/lights.py: SPI encoding, effects (solid, breathe, rainbow,
    sweep), brightness, power cap (1 A by default), flashes for saved,
    valuable/wishlist, unsure and unknown cards, settings in data/lights.json
    - /lights page with color, effect, brightness, speed, flash colors, LED
    count and wiring notes; linked from every page's menu
    - Scanner flashes the bars on those events
    - Maintenance check-up line (shown as opt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
    [config.py, lights.py, system.py, test_lights.py]
2026-11-01 Web app: Home dashboard, one page menu everywhere, clear no-camera screen
    - New Home page at / with the camera, servo board, feeder and Pi health,
    collection value and chart, last 14 days, newest and most valuable cards,
    price changes and bin fill. The scanner moves to /scan.
    - shell.js puts the same menu on every page: links across the top (extras
    under More when narrow) and a tab bar on phones. Machine and Maintenance
    now share the header and the saved theme. Maintenance gets the health dot.
    - No camera: the scanner shows what's wrong, offers Scan photos instead, and
    stops holding a stream open. The stream reconnects by itself if it drops.
    - Lighter on the Pi: the scanner polls s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
    [home.py, test_home.py]
2026-11-01 Fix doubled headers after the Lights merge, add Lights to the page menu
    Merging the Lights page brought back the old page links and a second logo
    on Collection, Decks, History, Wishlist and Settings, and the old tabs and
    menu in the scanner's header (two Live/Photos/Train rows with the same ids).
    Removes them, gives Lights the shared menu, adds Lights to shell.js, and
    adds a test that every page has one header, no old menus and no repeated ids.
    Claude-Session: https://claude.ai/code/session_0128qTvhKhGDpwsEytL21H8Q
    [test_home.py]
2026-11-01 Add a Sets page: set completion and spare copies to trade
    - /sets lists every set in the card database with how much of it you own.
    A set opens card by card (missing ones greyed), with a count by rarity,
    what the missing cards cost today, Add to wishlist and Copy the list.
    - Spare copies: cards beyond the copies you keep (4 by default), cheapest
    printings first, with their value and a list to copy. Basic lands are
    left out unless asked.
    - Sets is in the page menu, and on Home in place of the Bins shortcut
    (Home already shows the bins).
    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
    [database.py, sets.py, test_home.py, test_sets.py]
2026-11-02 Set the servo board up again after it loses power
    A PCA9685 that is unplugged and plugged back in wakes up asleep with no
    50 Hz setting, so the app's moves did nothing until a restart. Check
    MODE1 before each move and start over if the board is asleep, and drop
    the board after an I2C error so it is looked for again.
    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
    [machine.py, test_machine.py]
2026-11-02 Trapdoors: horn fork and printed hinge pins, no screws at the doors
    The front ear is now a fork open at the bottom: the servo horn (arm straight down) slides
    into a slot that goes right through the ear, so the horn can't push the door out of line.
    The back ear turns on a printed hinge_pin through the carrier's lug instead of an M3 screw.
    The door panel stops 2 mm short of the front rail so it swings past the servo's top; doors
    swing to 90 degrees clear of the tray, the carrier and the servo. Doors, carriers and pins
    are on one plate in bambu/MTG_Sorter_Trapdoor_Parts.3mf.
    Claude-Session: https://claude.ai/code/session_0128qTvhDrHjg4TBr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
    [MTG_Sorter_Trapdoor_Parts.3mf, bed_chute.scad, bed_chute_hinge_pin.stl, bed_chute_trapdoor.stl, bed_chute_trapdoor_left.stl]
2026-11-02 Make the light bar a holder for the 40 cm airgoo neon LED strip
    Nic's strip (airgoo AG-NEON-LS1: 400 mm, 14 x 7 mm, 21 LEDs, can't be cut) is far bigger
    than the old 12 x 1.2 mm diffuser bar and longer than the box is wide. The light_bar is now
    a hat-shaped channel that keeps the strip's glowing face on the three slots and still ties
    the fascia pieces together; the strip's ends bend back along the side panels. Checked against
    the whole assembly in place and while sliding in from above. The fascia now goes in after
    the bridge (the holder would block the bridge on the way down). Plate 18 is black now.
    LIGHTS_COUNT defaults to 21 (one bar).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
    [MTG_Sorter_Enclosure.3mf, enc_light_bar.stl, enclosure.scad]
2026-11-02 Put the slim light bar back for a 10 mm WS2812B strip
    Nic is returning the airgoo neon bars and getting a BTF-LIGHTING WS2812B strip (1 m,
    60 LEDs/m, IP30, 10 mm wide, cuttable) instead. A 14-LED piece sticks behind the original
    12 x 1.2 mm white light_bar, so the hat-shaped holder from PR #33 goes, the fascia can go in
    before the bridge again, and plate 18 is white again. LIGHTS_COUNT defaults to 14. Keeps
    epart="none" and the binary STL export from PR #33. Bambu project regenerated.
    Claude-Session: https://claude.ai/code/session_0128qTvf3m1stq7Yk4WopDjU
    [MTG_Sorter_Enclosure.3mf, enc_light_bar.stl, enclosure.scad]
2026-11-03 Machine page: servos follow the slider while you drag it
    The slider only sent its angle on release, so a drag gave one move and
    then nothing. Now it sends as you drag, with at most one move in
    flight and always ending where you let go.
    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
2026-11-03 Feeder roller that reaches the cards, taller stop pins
    The first roller only poked 0.8 mm up through the hopper floor, so with slightly thin
    O-rings it missed the cards. The new hub (23 mm groove) puts the rings about 2 mm up with
    20x3 or 22x3 O-rings; the stand and hopper keep their old numbers, so the printed ones fit.
    The stop pins stood only 2.4 mm proud on the side the card hits, and fast cards jumped them.
    They now stand about 5 mm proud and still drop 2 mm under the bed at the same 28 degree
    swing, so the saved servo angles don't change (more than ~31 degrees hits the chute axle).
    Both parts on one plate in bambu/MTG_Sorter_Feeder_Stopper_Fix.3mf.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
    [MTG_Sorter_Feeder_Stopper_Fix.3mf, bed_chute.scad, bed_chute_pin_rocker.stl, feeder_roller.stl, feeder_test.scad]
2026-11-03 Servos let go 1.5 s after each move so a blocked one can't overheat
    A servo held at an angle it can't reach (an arm against a stop) draws
    full current and gets hot. After each move, stop sending the hold pulse
    once the servo has had time to get there. SERVO_HOLD_SECONDS in
    config.py sets the delay; 0 keeps the old hold-until-told behaviour.
    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
    [config.py, machine.py, test_machine.py]
2026-11-03 Mechanism v2: spring-loaded feeder, four-tooth stop gate, door carriers that clear the bridge
    The first test run showed three problems: the feeder roller didn't reach the cards, fast
    cards jumped the two short stop pins, and at full tilt the trapdoor servos dipped about 4 mm
    into bridge_front, so the tilt servo stalled and got hot.
    - feeder.scad (new): the roller is now two O-ring wheels 30 mm apart on a hinged arm. A
    rubber band on the arm's tail pushes the wheels up into the stack and a hard stop holds
    them 2.5 mm proud. Gate with a rubber-pad groove and an M3 thumb screw resting on an anvil,
    plus a weight plate for the stack. Same footprint on the bridge.
    - bed_chute.scad: stop_gat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
    [MTG_Sorter_Chute.3mf, MTG_Sorter_Enclosure.3mf, MTG_Sorter_Feeder_And_Bed_v2.3mf, MTG_Sorter_Feeder_Stand.3mf, MTG_Sorter_Feeder_Stopper_Fix.3mf, MTG_Sorter_Trapdoor_Parts.3mf, bed_chute.scad, bed_chute_bed_plate.stl]
2026-11-03 Run the scanner on a home server, and scan with any device's own camera
    The app now comes as a Docker image (ghcr.io/outmyfocus/mtg-sorter, built by a
    GitHub workflow) with a compose file and an Unraid template, so it can live on a
    home server where every device shares one collection. The data folder moves with
    MTG_DATA_DIR (/data in the image), and in Docker the Maintenance page knows updates
    come as a new image and restarts by exiting (Docker starts it again).
    The server has no camera, so the Scan page gains "This device's camera": the phone
    or computer holding the page opens its own camera and sends pictures to the scanner
    (BrowserSource, /api/frame), which recognizes them exactly as it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
2026-11-03 Scan page: a polished phone-scanning view
    The "No camera" panel becomes an offer to scan with this phone or computer
    (hero, one big button, a link to the photo upload), with the old wording kept for
    machines that can't. While a device is the camera: a Stop button, Flip when it
    has more than one camera, a Light button when the camera has a torch, a pulsing
    status dot, the picture box takes the camera's shape, and a phone buzzes when a
    card locks on. Switching away from a device camera happens at once instead of
    after the next two-second wait.
    Claude-Session: https://claude.ai/code/session_0128qTvey8Stnyu3EqQnjQrC
2026-11-03 Start with an empty card database instead of crashing
    A fresh install (the Docker image before a backup is restored or build_db.py has
    run) refused to start: Matcher raised "The card database is empty" and the app
    died in a restart loop. Now it starts, every scan comes back as not recognized,
    the console says what to do, and the Maintenance page's card-database check
    already explains it on the page.
    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
    [database.py, test_scanner.py]
2026-11-03 Every phone scans on its own, next to the machine
    Picking "This device's camera" now gives that page a scanner of its own (its
    own thread, table and session) instead of taking over the machine's camera, so
    several people can scan at once and the Pi's camera carries on untouched. The
    page names its scanner in an X-Scanner header on every request; the machine's
    scanner answers everything else. A page in the background pauses its scanner
    and picks it up again; closing the page, or ten quiet minutes, drops it.
    The offer panel gains a "Scanning as" name, saved with each card in the
    collection's Source column, and the picture shows who else is scanning.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
2026-11-03 Phone camera: retry the hand-off and shrink pictures on a slow link
    Nic's iPhone on cellular got "Couldn't hand the camera to the scanner" when
    one request was dropped (the server never saw it), and once it worked the
    phone only managed 1 to 2 pictures a second.
    - Asking the scanner for the device's camera is retried up to three times
    with growing pauses before giving up (not on a PIN lock or a bad request).
    - Pictures start at 1280 px wide and step down to 1024, 800 or 640 px (and
    JPEG quality 0.7) whenever an upload takes over 450 ms, climbing back one
    step after 24 quick uploads. Recognition still locks on at 640 px.
    Checked with Playwright: two dropped hand-off requests, then suc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
2026-11-03 Polish the web app, mostly on the phone
    - Phone header names the page you're on next to the logo.
    - No more iPhone zoom when tapping a text box (16px inputs on phones),
    no double-tap zoom or tap flash on buttons.
    - Play: two players side by side on a phone; poison and commander
    damage fold away and open by themselves once there's damage.
    - Bins: rule rows wrap instead of running off the screen; bin names
    get their own line on a phone.
    - Settings and Lights use two columns on a wide screen.
    - Styled "Choose file" button, accent-colored text links, choice rows
    that scroll sideways instead of wrapping, "16 h 13 min" sessions.
    - Add to Home Screen: manifest, app icon, theme color that fo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
    [test_home.py]
2026-11-03 Montreal store prices: Face to Face Games first, then Card Brawlers and L'Univers de la Carte
    The scanner's card panel checks the Montreal stores live for the recognized card (that
    printing when the store has it, else its cheapest copy; kept 12 hours), with links to
    search Carta Magica, L'Expédition and Le Valet d'Coeur, which block automated requests.
    The weekly Canadian price check also asks the two new Montreal stores, and the
    Collection gets a Montreal column, a Montreal sort, and the store list in card details.
    Claude-Session: https://claude.ai/code/session_0128qTvhJZoSDL1YtNLWiydq
2026-11-03 Recognize every card: art fingerprint, exact card edges, full database button
    The server's database only had Dominaria United and Phyrexia: All Will Be One
    (915 cards), so almost nothing Nic owns could be recognized. With every card
    (108,000 printings) in the database, the whole-card fingerprint alone also
    starts mixing up different cards that share a frame. Measured with 1,600
    simulated phone photos (tilt, glare, sleeves, blur, wood/mat/dark tables)
    against all 108,010 printings:
    hard photos, old code: 4 confidently wrong, 27 of 60 non-cards called "likely"
    hard photos, this code: 0 confidently wrong, 0 non-cards called a card
    - Fingerprints are now 64 bytes: the whole card plus its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
    [cardbuild.py, config.py, database.py, recognize.py, system.py]
2026-11-03 build_db: count a printing listed twice once
    Claude-Session: https://claude.ai/code/session_0128qTvg1mUeJwRfRakDPuiy
2026-11-04 Add a picture assembly guide for mechanism v2
    Step pictures for the new feeder, scan bed stop gate and door carriers,
    drawn from the same CAD as the STLs (guide/v2/*_scenes.scad). build.py
    writes MECHANISM_V2.md with the pictures and a single-file HTML guide.
    Claude-Session: https://claude.ai/code/session_0128qTvjBSUjUvreT57qCDQm
    [bed_scenes.scad, feeder_scenes.scad, helpers.scad]
2026-11-04 Run the Pi on the server's Docker image, and drive the machine from the server
    - The image is now built for amd64 (tower) and arm64 (the Pi). The Pi flavour adds
    Raspberry Pi OS's picamera2, GPIO and vcgencmd packages.
    - `mtg docker on` (or Maintenance > Use the server's Docker image) switches the Pi to
    that image: Docker service with the same data folder, port and Tailscale address;
    update-docker.sh pulls new images every 5 minutes and rolls back if one won't start.
    - Root jobs (restart, reboot, update, logs, Wi-Fi, SPI) reach the Pi from inside the
    container through a request file in data/host/ and mtg-sorter-host.
    - MTG_MACHINE_URL on the server makes its Machine page, Home and ch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
    [logins.py, machine.py, remote_machine.py, security.py, system.py, test_pi_docker.py, test_system.py]
2026-11-04 Pi image: use the Raspberry Pi repo's current signing key
    The raspberrypi.gpg.key download has SHA-1 self-signatures, which trixie's apt has
    refused since 2026-02-01 ("repository is not signed"). Ship the key from the repo's
    raspberrypi-archive-keyring 2025.1 package (same key, SHA-512 signatures) instead,
    which also drops the curl and gnupg step.
    Claude-Session: https://claude.ai/code/session_0128qTvh3eNT6hPMwL4EQsW7
2026-11-04 Pi image: add gcc so pip can build Adafruit-Blinka-Raspberry-Pi-PWM
    The arm64 build now gets past apt, then fails in pip install: that package has no
    wheel for Python 3.13 on aarch64 and the image had no C compiler
    ("No such file or directory: 'aarch64-linux-gnu-gcc'").
    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
2026-11-04 Machine page: Wider servo travel switch (500-2500 us pulses)
    ServoKit's default 750-2250 us turns an MG90S only about 130-140 real degrees for the
    slider's 0-180, so the right trapdoor ran out of travel at 180 and the stop gate's
    90/50 is only about 30 real degrees. The switch uses 500-2500 us for about the full
    180. 90 stays 1500 us either way, so horns fitted at 90 don't move. Off by default.
    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
2026-11-04 Keep the stop pins holding after a move
    The stop gate falls back down under its own weight once its servo goes
    limp, and it has to stand firm against the card the feeder pushes into
    it. The 1.5 s auto-release (PR #37) now skips the parts listed in
    config.SERVO_KEEP_HOLDING, which is the pins. Relax still lets them go.
    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
    [config.py, machine.py, test_machine.py]
2026-11-04 Chute v3 (solid bomb bay) and a stronger front bridge
    The v2 door carrier snapped in testing, and the carriers' screw heads stood in
    the card's path. Chute v3 replaces the tray, trapdoors and carriers:
    - one-piece tray with nothing screwed through the floor
    - each door turns on two journals clamped between the tray and a screwed-on
    hinge frame, so no servo holds a door up
    - door servos sit in pockets in an 8 mm front wall and drive the doors through
    a crank and link (95 degrees with Wider servo travel on)
    - back rail trimmed so the stop gate's teeth clear it even when they drop with
    the tray tipped 25 degrees
    New front bridge: a 10 mm bearing wall with gussets, an L-beam shelf, an ar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
    [MTG_Sorter_Chute.3mf, MTG_Sorter_Chute_v3.3mf, MTG_Sorter_Enclosure.3mf, MTG_Sorter_Feeder_And_Bed_v2.3mf, MTG_Sorter_Trapdoor_Parts.3mf, bed_chute.scad, bed_chute_chute.stl, bed_chute_chute3.stl]
2026-11-04 Decks: upgrade path for Commander decks, from the fewest swaps to the most
    Each deck in the deck builder gets an Upgrade path: what EDHREC's decks with
    the same commander play, paired against the deck's weakest cards, split into
    four steps (Quick wins, Tune-up, Big upgrade, Best version). Swaps show why,
    the Canadian price, and whether you already own the card. Budget per card and
    No new Game Changers options; Swap / Make these swaps change and save the deck.
    EDHREC pages are cached in data/edhrec for a week; without them it falls back to
    the most played Commander cards in the deck's colors.
    Claude-Session: https://claude.ai/code/sessi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
    [test_upgrades.py, upgrades.py]
2026-11-04 Shorter page menu, and an Upgrade this deck panel on the Decks page
    Menu: Home and Scanner, then four small drop-downs (Cards, Decks, Machine,
    and a gear for Settings and Maintenance) instead of 14 links. Phone tab bar:
    Home, Scanner, Cards, Decks, More. M on the scanner shows every page grouped.
    Decks: for the commander, EDHREC's most played cards are paired against the
    deck's least played ones (land for land), priced in CAD, and shown in four
    steps from a 3-swap quick fix to fully optimized. Swap one or make a step.
    Claude-Session: https://claude.ai/code/session_0128qTvizPU4S9nbNamabyW3
    [test_home.py, test_upgrades.py, upgrades.py]
2026-11-04 Leave deck upgrades to PR #53: this PR is the shorter menu only
    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
    [test_upgrades.py, upgrades.py]
2026-11-04 Server copy: Docker-aware Maintenance page, and the Lights page drives the Pi's bars
    On mtg.outmyfocus.com (the Docker container on tower) the Maintenance page
    offered Reboot Pi, Shut down, Update now and the auto-update switch, and each
    one answered "The maintenance helper isn't installed yet", a Pi-only message.
    The Lights page there talked to the server, which has no light bars.
    - In Docker (not the Pi's bridged image) the page hides the Pi-only buttons,
    the Wi-Fi panel and the Updates/System log pickers, says updates come as a
    new image from Unraid's Docker tab, and the API answers Pi-only actions with
    that explanation instead of the helper hint.
    - The App log in Docker comes from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
    [lights.py, remote_machine.py, system.py, test_pi_docker.py, test_system.py]
2026-11-04 Lights: card light zone for LEDs in the scan bed walls
    The status LEDs behind the fascia slots come first in the chain; the card
    light LEDs chained after them (5 per bed wall groove) stay one steady color
    and never flash, so the camera's colors don't change. Set on the Lights page.
    Wiring notes updated for the BTF WS2812B strip.
    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
2026-11-05 Keep Nic's servo calibration and go home at every startup
    - config.py defaults are now Nic's calibrated angles (2026-11-05), wider
    servo travel on, and a 1.2 s feeder push, so the machine keeps them even
    if data/machine_settings.json is lost. Saved angles still win.
    - Machine.home() moves the doors closed, the tray level and the stop pins
    up, with the saved angles. app.py runs it in the background when the app
    starts on the Pi (retrying while the servo board shows up).
    - Machine page: Home button and a 'Go home when the sorter starts' switch
    (saved as home_at_startup, on by default). RemoteMachine passes both on.
    - Back to the original angles keeps the old file as machine_settings.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
2026-11-05 Gentle homing and a jam guard for held servos
    - Homing sweeps each part to its home angle at 60 deg/s from the last
    angle it was sent (kept in data/servo_last.json), instead of jumping.
    - Parts that keep holding (pins, doors) now let go after 30 s without a
    new move (config.SERVO_HOLD_LIMIT), so one jammed at a stop can't burn
    out its servo.
    - test_machine.py keeps its saved files in a temp folder.
    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
    [config.py, machine.py, test_machine.py]
2026-11-05 Docker: Restart starts the app over in place, and the Unraid template gets a restart policy
    Nic's container on Unraid kept "shutting down": the app's Restart button
    (and a restore) exited the process expecting Docker to start it again, but
    Unraid's container form sets no restart policy, so the container stayed
    stopped.
    - In Docker, restart now replaces the running process with a fresh copy of
    itself (os.execv, same command line, same PID), so nothing stops from the
    container's point of view. Exit stays as the last resort if exec fails.
    - deploy/unraid/mtg-sorter.xml adds --restart=unless-stopped as Extra
    Parameters; UNRAID.md says how to add it to an existing container and to
    turn A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
    [system.py, test_system.py]
2026-11-05 Pi camera in Docker: mount /dev/dma_heap, let go of a camera that failed to open
    In the Pi's container picamera2 couldn't allocate picture memory ("Cannot allocate
    memory"): --privileged copies the device files but not the vidbuf_cached link udev
    adds on the Pi, so it fell back to the 64 MB CMA pool. Mounting the Pi's own
    /dev/dma_heap brings the link along.
    After that first failure PiCapture never closed the camera, so every retry failed
    with "Camera in Configured state trying acquire()". It now closes it, and the log
    keeps the reason the camera didn't open.
    [camera.py, test_camera.py]
2026-11-05 Pi camera focus: autofocus over the full range, plus a Focus picker
    The Camera Module 3 was set to continuous autofocus in libcamera's default
    "Normal" range, which leaves out the closest distances, and cards sit about
    12 cm under the lens. So it never focused on them.
    - Auto now uses AfRange Full and AfSpeed Fast.
    - A Focus picker on the scanner page (shown only for the Pi camera) has
    Auto or a fixed distance (8-60 cm). The fixed distance sets LensPosition
    to 1/metres. The choice is saved in app_settings.json and used when the
    camera opens.
    - POST /api/camera/focus {"cm": null|number}.
    - A failed focus control is now logged instead of ignored.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
    [camera.py, test_app.py, test_camera.py]
2026-11-05 Scanner page: Rotate and Crop the machine camera's picture
    Nic wants the picture to show only the scan bed, the right way up.
    - New mtgscanner/view.py rotates the frame (0/90/180/270 clockwise) and then
    crops it to a box. The box is stored as shares of the rotated picture.
    - The Scanner rotates and crops every frame before it finds cards, so the
    page picture, the outlines and the slots all use the cropped view.
    - /api/settings accepts "rotate" and "crop". A drawn crop applies inside the
    current crop (it zooms in), and null shows the whole picture again.
    Slots stay on the same spots of the table through a crop or rotation.
    The settings are saved to app_settings.json and restored at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
2026-11-05 Let the server scan with the sorter Pi's camera
    On the server (mtg.outmyfocus.com, the Unraid container) the Scan page's
    camera menu now lists "Sorter's Pi camera" whenever MTG_MACHINE_URL is set.
    Picking it makes the server watch the Pi's live /stream.mjpg and recognize
    the cards itself, so scanning on the machine fills the server's collection.
    With no camera of its own the server starts on the Pi's camera instead of
    waiting for one.
    - remote_machine.RemoteCameraSource: a camera source fed by the Pi's MJPEG
    stream (reconnects on its own, reports errors, focus goes to the Pi).
    - The Pi's machine key now also opens /stream.mjpg, /api/lights and
    /api/camera/focus to the server when a PIN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
    [remote_machine.py, system.py, test_pi_docker.py]
2026-11-05 Feed one card while watching the camera
    The feeder's wheels sit about 20 mm behind its gate, so a timed push leaves each
    card hanging in the slot until the next card drags it out, and then two or three
    come at once. Recorded tests on the Pi gave 0, 1 or 3 cards for the same push.
    Feed one card now runs the motor until the Pi camera sees a card land in a
    band just above the stop teeth, then stops it at once, and reports whether the
    card stayed there or went over the teeth. The band is saved on the Machine page.
    On the server the Pi does it, since it has the motor and the camera.
    Claude-Session: https://claude.ai/code/session_0128qTvhCs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
2026-11-05 Feed one card: see the card land sooner
    While a feed watches the camera, the Scanner now hands it each picture and skips
    finding and recognizing cards until the feed is done. On the Pi those took a few
    hundred ms a picture while cards moved, so the feed saw its card up to 300 ms late
    and the next card had time to follow.
    Claude-Session: https://claude.ai/code/session_0128qTvhCskZcLd2yjuAFmes
    [test_machine.py]
2026-11-05 Feed one card: pull the next card back after a landing
    The wheels touch the next card as soon as the first card's tail passes them, so
    by the time the camera sees the first card land, the next one is 20 to 35 mm
    out of the slot, resting on the landed card and pinning it against the gate
    (it then won't drop when the stop pins go down). After each landing the wheels
    now turn backwards for FEED_BACKOFF_SECONDS (0.25 s) so that card goes back
    into the hopper. Nothing happens when no card landed.
    Claude-Session: https://claude.ai/code/session_0128qTvhQ8AXFeF7buJ8ApwU
    [config.py, feed_watch.py, remote_machine.py, test_machine.py]
2026-11-05 Feeder v3: move the wheels to the gate
    Watching the v2 feeder on the Pi camera showed the O-ring wheels, 20 mm
    behind the hopper's front wall, drive the next card out as soon as the fed
    card's tail passes them, so it lands on the first card and pins it.
    - feeder.scad: roller_y 20 -> 8, hinge pivot moved forward to y 44 (about
    twice the band's push at the wheels), hopper floor slots follow the wheels
    - bed_chute.scad: two 14 x 6 mm notches in the bed plate's back edge so the
    wheels can reach over it (checked in CAD: no contact)
    - new STLs for stand, arm, hopper, bed plate; roller/gate/weight unchanged
    - bambu/MTG_Sorter_Feeder_v3.3mf (make_small_projects.py now also takes a
    project nam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
    [MTG_Sorter_Feeder_v3.3mf, bed_chute.scad, bed_chute_bed_plate.stl, feeder.scad, feeder_arm.stl, feeder_hopper.stl, feeder_stand_mid.stl]
2026-11-06 Revert "Feeder v3: move the wheels to the gate"
    This reverts commit 0b06939258067bf30ef72f68c759e98ecc073261.
    [MTG_Sorter_Feeder_v3.3mf, bed_chute.scad, bed_chute_bed_plate.stl, feeder.scad, feeder_arm.stl, feeder_hopper.stl, feeder_stand_mid.stl]
2026-11-06 Machine page: feed and sort one card to a bin
    The 2026-11-06 camera tests found the feeder fine (17 of 20 clean with the
    back-off) and the trouble in what comes after: cards take 1-4 s to slide
    off the stop teeth, a chute left loose sags, and a tray tilted before the
    card is on it turns the card so it catches on the rail.
    - Machine.drop(bin): chute level and held, pins down for SORT_PINS_SECONDS,
    then the trapdoors open (bin 2) or the chute tilts to the side (bins 1
    and 3), then everything back. POST /api/machine/drop.
    - FeedWatcher.sort_one(bin): feed_one, drop, then a look at the landing
    zone; if the card is still there, drop again (SORT_RETRIES).
    POST /api/machine/sort_one, also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
    [config.py, feed_watch.py, machine.py, remote_machine.py, test_machine.py]
2026-11-06 Sort one card: judge the drop against the empty bed
    The first live run with the Bin buttons (2026-11-06, B04) reported a card
    dropped that was still on the bed: the pins had pushed it up and turned it
    out of the landing band, which was all the check looked at.
    - sort_one keeps a picture of the empty bed from before the feed and, after
    each drop, compares nearly the whole view with it (SORT_CHECK_ZONE); the
    card is gone when less than SORT_GONE_SHARE still differs. The answer
    carries left_share.
    - Test for a card the pins push out of the band but not off the bed.
    Claude-Session: https://claude.ai/code/session_0128qTvhQ8AXFeF7buJ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
2026-11-06 Machine page: a tuning run that sorts round the bins and adjusts itself
    Nic asked for "a test that'll perfect the machine". The run (mtgscanner/
    tuning.py, started from the Machine page) feeds and sorts card after card
    round the bins with sort_one, scores every feed, and when "adjust" is on
    nudges the settings after each miss: slower after a card goes over the
    teeth, faster when nothing comes, pins down longer when a card needed a
    second drop. It stops when a card is left on the bed or the hopper runs
    out. Nothing is saved until "Save these settings" (feeder speed, and the
    drop timings now kept in machine_settings.json "sort" and used by drop).
    - POST/GET /api/machine/tune, /tune/stop, /tun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
2026-11-06 Lights stand still while a feed watches the camera
    A feed watching the camera tells a card from the bed by what changed in
    the picture, and a light effect cycling under it looks like a change: it
    gave false "over" and "still on the bed" readings in the 2026-11-06 tests.
    - Lights.hold() / release(): the effect clock freezes and event flashes
    are skipped while held.
    - FeedWatcher holds the lights for the length of feed_one and sort_one.
    - Test: a rainbow effect renders the same picture while held, flashes
    wait, and both come back on release.
    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
    [feed_watch.py, lights.py, test_lights.py]
2026-11-06 Sort one card: a card is gone below 8 % changed, not 5 %
    In the 2026-11-06 tuning run an empty bed read 0.055-0.058 changed against
    the picture from before the feed (the rail light), so the app said "not
    dropped" and dropped again. A card is about a tenth of the view, so 0.08
    still tells one apart.
    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
2026-11-06 Sort one card: go on as soon as the camera sees the card leave the teeth
    The drop waited a fixed SORT_PINS_SECONDS (3 s) with the pins down. Most
    cards are off the teeth in 1-2 s, so the cycle felt slow. Now sort_one
    hands drop a card_gone() check (the landing band looks empty again) that
    is asked every 0.1 s; the wait ends after SORT_PINS_MIN_SECONDS (0.5 s)
    plus a moment to clear, or at the full time if the card is slow. The
    answer carries pins_ms. The pins themselves were already sent straight
    to "down" in one jump.
    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
    [config.py, feed_watch.py, machine.py, test_machine.py]
2026-11-06 Sort one card: pins drop the moment the card lands
    Measured on the machine (2026-11-06): the pins dropped 1.4-1.7 s after
    the card landed, because feed_one watched the bed for 0.8 s and then ran
    the back-off before the drop began. Meanwhile the next card could follow
    the first out and catch it. Now sort_one feeds with no settle wait and no
    back-off inside feed_one, then starts the back-off (the machine's own
    timer stops it) and drops the pins at the same moment.
    "Over" (the card never rested on the teeth) is now told from the drop:
    the landing band empty sooner than SORT_OVER_SECONDS (0.3 s) after the
    pins went down, since there is no settle wait to see it in.
    The fake camera in the tests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
2026-11-06 Start sorting: the machine feeds, recognizes, saves and bins cards on its own
    Nic asked how to start the machine to scan; there was no run that joined
    the pieces. mtgscanner/sort_run.py: card after card, feed one (watching
    the camera), let the scanner recognize it, save it to the collection,
    pick its bin by the Bins page rules and drop it there, until the hopper
    is empty, a card is left on the bed, the cards asked for are done, or
    Stop is pressed. Unsure and unread cards are not saved and go to the
    fallback bin; the rules' bin 0 (no tray) maps to SORT_FALLBACK_BIN.
    sort_one takes a `choose` step: while it runs, the camera's pictures go
    to the scanner instead of the feed watch. Machine page: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
2026-11-06 Sort run: wait for this card's recognition, not a card seen before the feed
    The scanner keeps a dropped card's track until it has been out of sight
    for a while, and the next card hanging out of the slot shows at the top
    of the picture; either ended the wait at once, so the pins dropped as
    soon as the card left the feeder. Now only a card recognized since the
    feed began, with its middle in the lower part of the picture, counts.
    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
2026-11-06 Sort run: keep waiting while the scanner's answer is still "unknown"
    A card's first looks are often while it is still sliding or blurred and
    come back unknown; the run took that as final when it was the only card
    on the bed and dropped it unread. Now only a locked or unsure answer
    ends the wait before the deadline.
    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
2026-11-06 Sort run: a new card never inherits the last card's track
    Each card starts with a clean table (Scanner.forget_tracks), since a card
    landing where the last one sat would carry on that track and its name,
    and the run only takes a track whose latest look agrees with the card it
    shows. The Tuning run's text now says it feeds without reading cards, so
    it isn't mistaken for sorting.
    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
    [sort_run.py, test_machine.py]
2026-11-06 Lighter stream, idle scanner, foil second look, bin-full warning
    From tonight's camera tests of the sort run (2026-11-06):
    - /stream.mjpg now sends a preview (long side STREAM_PREVIEW_PX 960, JPEG
    quality 70, about a tenth of the 400 KB full frames) so a phone or a
    Tailscale link keeps up; ?full=1 gives the full picture and the
    server's RemoteCameraSource asks for it. The full picture is only
    encoded while such a stream is open.
    - The scanner looks at a still picture only SCAN_IDLE_FPS (4) times a
    second when no card waits for an answer; any change brings it back to
    every frame. Less heat on the Pi (84 C, throttling) and a quicker stream.
    - Sort run: a card not read after SORT_FO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
2026-11-06 Scan page: a proper Start sorting button
    Nic: "i want the sorter to run by itself. but i want a proper start
    button". The Scan page now has a big Start sorting button above Save
    (shown where the app runs the machine: the Pi, or a server pointed at
    it, /api/state "sorter"). It turns into Stop sorting while a run goes,
    with the last card read, what's saved and the cards per bin underneath,
    and shows the run's own message when it can't start.
    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
2026-11-06 Scan page: fix the script that stopped the page (helper declared twice)
    PR #77's Start sorting code declared `money`, which the Scan page script
    already had, so the whole script failed to parse: no live view, no
    buttons. Renamed, and a test now parses every page script with node.
    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
    [test_app.py]
2026-11-06 Sort run: stop when two cards come out together
    Tonight's run read a stacked pair as one card and dropped both into
    that card's bin, leaving an unsaved card there. Now, when the scanner
    sees two cards on the landing area at once (middles a fifth of a card
    apart or more), the run stops with the pins up and nothing dropped:
    "two cards came out together: take them off the bed and press Start
    again". The card shows as "double" in the table.
    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
2026-11-06 Recognize foils: paint over the glare and look again before giving up
    4 of 5 unread cards on tonight's sort runs were foils: the bright patches
    the light bars make on them aren't on the stock picture and pull the
    fingerprint away from it. When nothing matches, vision.tame_glare paints
    the brightest patches (200+ grey, top 3 %) over with their surroundings
    and the card is looked up again, both ways up; the better answer wins.
    On 40 synthetic glared cards the right card went from 26 to 39.
    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
2026-11-06 Add a holder for the servo-power DC jack in the back panel's power cut-out
    dc_jack_holder.scad: an inside holder (stands on the floor, flange on the
    panel, tongue in the cut-out, jack tied into a trough) and an outside bezel
    with the plug hole, clamped through the existing cut-out by one M3 screw.
    The Pi's USB-C cable still passes beside the jack. One-plate Bambu project
    from make_small_projects.py; PRINTING.md has the fitting steps.
    Claude-Session: https://claude.ai/code/session_0128qTvgcjg3wkVqC8SzJLvQ
    [MTG_Sorter_DC_Jack_Holder.3mf, dc_jack_bezel.stl, dc_jack_holder.scad, dc_jack_holder.stl]
2026-11-07 Feeder: push a card clear of the gate, save a longer back-off, stop on a card held in the slot
    Live tests on 2026-11-07: cards stopped 15-25 mm short of the stop pins with their tail
    still under the gate, because the motor stops the moment the card shows in the landing
    zone. And when the gate held a card, the motor ground on for the full 3 s.
    - Feed one card keeps pushing for "push" seconds after the landing (default 0.1 s), so
    the tail clears the gate before the back-off.
    - Back-off and push are saved with "Save as the usual push" and used by Start sorting;
    the back-off can be up to 2 s so the extra cards go well back into the hopper.
    - A card showing above the landing zone that stops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
    [config.py, feed_watch.py, machine.py, remote_machine.py, sort_run.py, test_machine.py, test_pi_docker.py, test_system.py]
2026-11-07 Side bins: rock the tray half way back and tilt again, so the card really falls
    Nic (2026-11-07): when the tray tilts to bin 1 or 3, do it a couple of times. After the
    tilt the tray now swings half way back towards level and tilts again SORT_TILT_SHAKES
    times (2, 0.4 s each step). Half way, not level, so a card nearly off the edge doesn't
    slide back into the middle. Saved angles are unchanged; the shake moves between them.
    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
    [config.py, machine.py, test_machine.py]
2026-11-07 Scan bed v3: steeper centring channel with ribs, and an all-plastic hopper weight
    Drop-in bed plate (same wall grooves and stop-gate slots): 24 degree wedge surface that
    meets the hopper floor, 65 mm channel with 4-6 mm walls and a funnel, four lengthwise
    ribs, chamfered teeth slots. Solid 14 mm hopper weight (100% infill, ~95 g).
    One Bambu project (bambu/MTG_Sorter_Scan_Bed_v3.3mf), pictures, SCAN_BED_V3.md.
    Claude-Session: https://claude.ai/code/session_0128qTvgTx5kJf2oaWgC9aJJ
    [MTG_Sorter_Scan_Bed_v3.3mf, bed_chute.scad, bed_chute_bed_plate3.stl, feeder.scad, feeder_weight_solid.stl, scenes.scad]
2026-11-07 Scan page: Straighten the camera picture from a card on the bed
    Nic (2026-11-07): "straighten the camera's image so it looks at the card perfectly".
    The Pi camera looks at the bed slightly from above the slope: about 1° of tilt, the
    card's bottom edge 1.5 % wider than its top, and 3 % squashed.
    - view.straighten_from: finds the card (or takes its 4 corners by hand, as shares of
    the picture, for a black-bordered card the detector can't see on the dark bed) and
    works out the perspective warp that makes it an upright 63x88 rectangle, centred
    where it was and as big. view.straighten applies it to the whole picture.
    - The scanner warps every picture after Rotate and Crop, keeping its size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
    [test_app.py, test_scanner.py, view.py]
2026-11-07 Camera: straighten by itself from the cards it recognizes for sure
    Nic (2026-11-07): "make sure the straighten is perfect. make the camera 100% automatic".
    On the Pi a one-shot Straighten from a black-bordered card on the dark bed came out
    3-4° wrong: one outline is not reliable enough.
    - auto_straighten.py: every card recognized for sure (its outline matched the stock
    picture) is a sample, mapped back into the unstraightened picture. Outlines off
    square, off a card's proportions, or at the picture's sides (light bars) are left
    out. With 8+ samples the median card shape gives the warp, so each card's own turn
    on the bed and odd outlines average out. A correction over 3° or 8 % is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
    [auto_straighten.py, config.py, test_app.py, test_scanner.py]
2026-11-07 Scan bed v3: one stop bar and opening instead of four teeth, slippery print settings, camera marker pockets
    - stop_gate3: one flat 51.6 mm stop bar (same horn, bearing and angles); CAD-checked against the
    plate and the tray at 22/25 degree tilts up to 40 degrees down
    - bed_plate3: one chamfered opening for it, four 5 mm ArUco sticker pockets in the card's plane
    - 3MF plate 1: 0.12 mm layers, 7 top layers, ironing on top surfaces; plate 3: the stop bar
    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
    [MTG_Sorter_Scan_Bed_v3.3mf, bed_chute.scad, bed_chute_bed_plate3.stl, bed_chute_stop_gate3.stl, scenes.scad]
2026-11-07 Sort run: the pins only drop for a recognized card
    Nic (2026-11-07): "I only want the pins to fall when the card is recognized". Until now a
    card the scanner couldn't read within 8 s (or only guessed) went to the fallback bin.
    - A card not read for sure after SORT_RECOGNIZE_SECONDS (with the dimmed second look)
    now stays on the bed with the pins up. The status gets "waiting" with a message, and
    the Scan and Machine pages show Look again / Unread bin / Stop.
    - Look again forgets what was seen and looks afresh; Unread bin drops it into the
    fallback bin unsaved, as before; Stop ends the run with the card left on the bed.
    - If the scanner reads the card meanwhile (straightened or turned b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
2026-11-07 Scan bed v3: the slippery-smooth bed settings as an importable Bambu Studio process preset
    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
    [MTG_Sorter_Scan_Bed_v3.3mf]
2026-11-07 Scan bed v3.1: flat-printed 20° face, clean entry, PTFE tape lands, taller stop bar
    Live test of v3: cards stuck at the entrance (crest in front of the hopper floor edge with a hollow
    under it) and didn't slide at 24° (layer steps across the slide direction). The card face is now
    parallel to the plate (prints flat), 2 mm above the old face, ends under the floor edge, and sits
    on four 6.5 mm lands for 1/4 inch PTFE tape. Stop bar 2 mm taller to match. CAD re-checked.
    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
    [MTG_Sorter_Scan_Bed_v3.3mf, bed_chute.scad, bed_chute_bed_plate3.stl, bed_chute_stop_gate3.stl, scenes.scad]
2026-11-07 Stop bar v3.2: 13.5 mm tall with a 1.5 mm lip (1 card in 4 hopped the 10 mm bar); needs pins down about 165
    CAD: clear of the plate from -6 to 44 degrees, of the tray at 22/25 degree tilts and with the doors open up
    to 40 degrees, and of the sliding card from 32 degrees (old teeth: 25 degrees = Nic's 155).
    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
    [MTG_Sorter_Scan_Bed_v3.3mf, bed_chute.scad, bed_chute_stop_gate3.stl]
2026-11-07 Scan bed doc: the stop bar's down-angle window (about 162-170), why not 180
    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
2026-11-08 Feeder box v4: wheels at the mouth, self-setting separator shoe, card leaves along the bed, stand fits the bridge outline
    - feeder4.scad: fixed-bearing roller with wheels 33.5 mm apart (between the bed's PTFE lands),
    a drop-in shoe (the hopper's front wall) that slides straight up and down and rests on the
    wheels with cork pads; the nip is 20 degrees ahead of the wheels' top, so the card leaves along
    the bed's slope 0.8 mm over the lands. Stand 72 x 127 mm: 0.8 mm room in the bridge's
    73.6 x 128.6 fence (v2 had 0.3), chamfered foot.
    - bed_plate3: two wheel slots at its back edge (bp3_wheel_slots).
    - MTG_Sorter_Feeder_Box_v4.3mf (5 plates), rebuilt Scan_Bed_v3 3MF, FEEDER_V4.md,
    pic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
    [MTG_Sorter_Feeder_Box_v4.3mf, MTG_Sorter_Scan_Bed_v3.3mf, bed_chute.scad, bed_chute_bed_plate3.stl, check.scad, feeder4.scad, feeder4_hopper4.stl, feeder4_roller4.stl]
2026-11-08 Wanted cards: pull a list (pasted, from a deck or the wishlist) into its own bin
    A card on the Bins page's wanted list goes to the chosen bin whatever its price.
    Options: keep that bin for wanted cards only (the rest go to another bin), stop
    at the listed number of copies (per sort run), skip basic lands. The deck page
    gets a Pull from my bulk button. The server sends its Bins rules to the Pi when
    it starts a sort run, so the list made on the server is the one used.
    Claude-Session: https://claude.ai/code/session_0128qTvfRVxv4SMqNhAjRMZJ
    [bins.py, logins.py, sort_rules.py, sort_run.py, test_decks_bins.py, test_machine.py, test_pi_docker.py]
2026-11-08 Feeder box v4: lock the stand over the bridge's outline ridge and the hopper onto the stand
    The motor dragged the whole box forward. The stand's foot now closes over the bridge's 2 mm fence
    (a skirt outside it and a roof over it, joined to the walls), so it can only lift straight up. The
    hopper's four 2 mm pegs become a ridge along the stand's side and back walls in a groove under the
    hopper's floor. Clash checks: stand vs the real fence ring and bridge plate (clear); moved 1 mm
    forward it hits the fence. 3MF, pictures and FEEDER_V4.md updated.
    Claude-Session: https://claude.ai/code/session_0128qTvfJKcJftLTHwRj1nP3
    [MTG_Sorter_Feeder_Box_v4.3mf, check.scad, feeder4.scad, feeder4_hopper4.stl, feeder4_stand4.stl, scenes.scad]
2026-11-08 Auto straighten: one sample per card, not one per look
    A card sitting on the bed is recognized many times; each look counted as a
    sample, so one card (and its own skew) re-straightened the picture after every
    restart and moved the feed landing zone. Each track now gives one sample.
    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
2026-11-08 Double-feed check: ignore an outline much smaller than the card
    A borderless card's art or text box was found as a second card and stopped a
    run with one card on the bed. Two outlines only count as a double feed when
    they are close in size (SORT_DOUBLE_MIN_SIZE 0.8) as well as apart.
    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
2026-11-08 Sort run: always put the light bars back after the foil second look
    A double feed raised during the dimmed second look skipped the restore, so the
    bars stayed at 8 % and the camera slowed to about 4 fps.
    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
    [sort_run.py, test_machine.py]
2026-11-08 Open the hopper tower's front so it can't press on the feeder
    The tower's front wall stood exactly where the feeder box's front is (enclosure y 147.3-149.8,
    from the deck up), so with the tower on it sat on the old box's gate, or the v4 shoe, and pressed
    it onto the wheels: the motor hummed and stopped. The tower is now cut away in front of
    feeder_front_y + 1.5, corners included; the lid still sits on top, 4 mm over the shoe.
    New clash checks (guide/feeder4/check.py): tower against the stand/hopper and the shoe, lid against
    the box, and the lid with the shoe lifted 1.5 mm. All 22 clear. The tower is plate 6 of the feeder
    box v4 3MF (and still plate 10 of the enclosure 3MF); FEEDER_V4.md has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
    [MTG_Sorter_Enclosure.3mf, MTG_Sorter_Feeder_Box_v4.3mf, check.scad, enc_tower.stl, enclosure.scad, scenes.scad]
2026-11-08 Scanner: "Whole cards only" ignores parts of a card
    Nic: the scanner kept looking at small sections of the card. On the scan bed a
    whole card is 0.36-0.39 of the picture, but the finder also returned its art box
    (0.18-0.26) and text box (0.04-0.12) as cards of their own. A new camera button
    measures the card on the bed and sets the smallest card to 0.8 of it (about 0.30),
    saved as min_card; the API also takes a number or null.
    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
2026-11-08 Whole cards only: read a foil from the bed box when its edge is lost
    On the Pi every foil went unread: glare hid its black border on the dark bed, so
    the outline finder only found the art box (0.20 of the picture), which Whole
    cards only rightly ignores. The card's spot on the bed is now remembered
    (bed_box, measured with the button or set over the API). When only a piece of a
    card shows inside it, the bed box is used as the card's outline, as Slots mode
    already does. Pieces elsewhere (the next card in the slot) are still ignored.
    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
2026-11-08 Sharper Scanner viewer: preview 1440 px at quality 85
    Nic: the viewer showed the camera in very low quality. The server decodes the
    Pi's full 1080x1920 picture and re-encodes it at 540x960, quality 70, for the
    page, which then stretches it. The preview is now 1440 px on its long side at
    quality 85 (about 150-200 KB a frame).
    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
2026-11-08 Drop check starts below the feeder slot
    Three runs stopped with "still on the bed" on an empty bed, each right after an
    empty feed left a card about a fifth out of the slot (y 0.10-0.22). Measured on
    the Pi: left_share 0.094 for the whole view against 0.032 from y 0.20. The check
    zone now starts at y 0.22 (a card at the bar fills 0.20-0.79). The sort run's
    card list also keeps left_share, so the next false alarm can be read back.
    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
2026-11-08 Scanner: survive tracks being forgotten mid-recognition
    Tower's camera thread died at 22:48 with "list.remove(x): x not in list" and
    the Scanner page's picture froze until the app restarted. process() recognizes
    without the lock; a sort run (or a settings change) called forget_tracks()
    meanwhile, then the picture's answers tried to remove a track that was gone.
    A counter now marks each forget, and answers for a forgotten table are dropped.
    An error in one picture also no longer ends the camera thread.
    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
    [test_app.py]
2026-11-08 Sort run: let the camera settle after the bars come back up
    A run stopped with "still on the bed" on an empty bed (left_share 0.134) right
    after the foil second look: the drop check compares the bed with the bright
    picture from before the feed, and the camera was still exposed for the dimmed
    bars. The look now waits SORT_LIGHTS_SETTLE (1.0 s) after restoring them.
    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
2026-11-08 Feeder: one more push at full power before a feed counts as empty
    Nic: "the motor can't put the card out all the time". With the gate a hair low,
    the wheels start a card but the gate holds it a fifth of the way out, and two such
    feeds in a row ended the run as "hopper empty". sort_one now gives a feed that
    brought nothing (or left a card held in the slot) one more push at
    FEED_RETRY_SPEED (1.0) before counting it; the first result stands if that also
    fails.
    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
    [config.py, feed_watch.py, test_machine.py]
2026-11-09 Recognition: always try the bed box on a card on the bed, and a contrast boost when unsure
    On the Pi's unread cards the outline was often a little off or only a piece of a
    foil; the bed-box crop read 3 of 6 of them. A whole outline on the bed now gets the
    bed box as a second outline to try (best match wins), and a card that isn't sure on
    the first look is looked up again with its contrast evened out (CLAHE).
    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
2026-11-09 Empty bed clears the table: a bed box that matches no card isn't kept as one
    Nic: "it keeps thinking this card is on the table" with the bed empty. With Whole cards
    only, a piece of the bed's texture inside the bed box made the bed box stand in for the
    card's outline, and the card's old track lived on. A card held only by the bed box is now
    looked at every 0.5 s, and when the bed box matches no card it's removed (or never added).
    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
2026-11-09 The bare bed is never read as a card: remember what it looks like
    Nic: the empty scan bed was read as Precise Redaction (a good match) and saved again and
    again. The scanner now keeps a fingerprint of the bare bed inside the bed box, and while
    the bed box looks like that the bed-box stand-in outline isn't offered at all. Every sort
    run keeps it up to date (the "before" picture of each feed after a card was seen leaving),
    and the Scanner page has a "Bed is empty" button (for the server's own scanner too).
    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
2026-11-09 Bed box only once the bare bed is known, and nothing on a bare bed
    Nic: still reading the empty bed as Precise Redaction after PR #104. Until the bare bed is
    remembered, the bed box no longer stands in for a card or is tried as a second outline;
    and while the bed box looks like the bare bed, outlines on the bed (its ribs) are dropped
    too, not just the stand-in.
    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
    [test_app.py]
2026-11-09 Bed box only for a card at rest: no stand-in while the bed is moving
    Tower kept saving Precise Redaction ~2 s after each real card, while that card slid off
    the bed: half a card and the ribs in the bed box read as it. The bed box now only stands
    in for a card, or is tried as a second outline, once the bed box has looked the same for
    BED_STILL_SECONDS (1 s).
    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
2026-11-09 On the bed, a card the bare bed reads as only counts when sure
    Nic: Precise Redaction still read from the bed. The cards the remembered bare bed itself
    comes closest to are its lookalikes; a lookalike matched on the bed now only counts as a
    sure match, whatever outline it came from, so the ribs ("good match" at best) are never
    kept or saved as it.
    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
2026-11-09 Sorter Mk2: fit file, screwless joint library, fit coupon, frame, electronics tray, sort module, clash checks
    Claude-Session: https://claude.ai/code/session_0128qTvgZbAQV7Z9uiupFGfH
    [check.scad, coupon.scad, etray.scad, fit.scad, frame.scad, joints.scad, layout.scad, mk2_coupon_pieces.stl]
2026-11-09 Sorter Mk2: stacked push sorter with four identical bins
    Nic asked for a fourth bin with handles, cards that fall perfectly
    everywhere and gentle handling. A drop simulation (sim/drops.py,
    sim/push.py: pymunk with air drag) showed a tilting tray stands cards on
    edge in an empty outer bin, while pushing a card sideways off a flat
    floor at 100-150 mm/s lands it flat in every case.
    New layout: level 1 (two trapdoors on their own servos) pushes into bins
    1 and 2; its doors drop the card flat down a guided shaft to level 2,
    which pushes into bins 3 and 4. Four identical bins (65 x 91 x 150,
    about 400 cards) with a pull-and-lift handle and a back hand hold.
    Pushers are scotch-yoke carriages with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
    [check.scad, frame.scad, layout.scad, levels.scad, scan.scad, scene.scad, sort.scad]
2026-11-09 Sorter Mk2: scan module, feeder cartridge, covers, one-plug power, print files
    - Scan module: carrier on the walls' scan rail, white 1.6 mm bed that clicks
    under four rim lips, stop bar on long arms that drops 9 mm below the bed
    (sim: 60/60 cards land flat), camera arch keyed to the carrier, light bars.
    - Feeder cartridge: the v4 bottom feeder with a 450-card magazine loaded
    from the top, 60 RPM N20 in a snap-lid pod, PTFE tracks under the stack.
    - Covers: front cover, two back panels, magnet lid in two halves with the
    magazine opening, a drawer between bins 3 and 4.
    - One plug: 5 V 10 A brick, panel jack, Wagos, relay the Pi closes after boot,
    16 mm power button on the Pi 5's J2.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
    [MTG_Sorter_Mk2.3mf, check.scad, covers.scad, etray.scad, export.scad, feeder.scad, frame.scad, layout.scad]
2026-11-09 Sorter Mk2: print config (Bambu Studio process presets), sturdier print settings
    make_mk2.py now writes presets/mk2/ (eight process presets for the A1, a README
    that says which preset and colour each part takes) and the same folder as a zip,
    from the settings it puts in the 3MF. Mk2 prints with 4 walls / 20% infill
    everywhere and 5 walls / 30% on the frame and load-carrying parts.
    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
    [MTG_Sorter_Mk2.3mf]
2026-11-09 Sorter Mk2: pre-print pass (mesh test, latches, sensor mounts, wire routes, vents, wall lock)
    - meshcheck.py: every exported part is one solid, watertight, fits the A1, sits flat
    - fixes it found: feeder motor lid hooks were loose, scan carrier had no flat face on
    the plate (now prints on the skids' back ends), coupon lid floated, level 2 hall
    pockets were sealed (now open-top with a wire groove)
    - spring-finger latch on the stop bar servo (same as the level servos)
    - fingers' grooves 0.4 deeper than the fingers, with lead-ins
    - four TCRT5000 holders (new part) sliding into grooves in the level stiffeners;
    bin windows widened so the sensor needn't sit exactly
    - trunk lids get a wire no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
    [MTG_Sorter_Mk2.3mf, check.scad, coupon.scad, covers.scad, export.scad, feeder.scad, frame.scad, joints.scad]
2026-11-10 Sorter Mk2 3MF: centre every plate's layout so brims and supports stay on the bed
    Parts were packed 2 mm from the bed's edge, so a 5 mm brim (and tree supports)
    ran off the A1's plate. Each plate's layout is now centred, and a part with a
    brim keeps at least 7 mm to the edge (make_mk2.py stops if one doesn't).
    MK2.md: don't press Arrange, and leave Global support off.
    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
    [MTG_Sorter_Mk2.3mf]
2026-11-12 Mk2: picture assembly guide (22 steps rendered from the model)
    scene_atoms.scad places each part in machine coordinates; guide/build_guide.py
    renders one picture per step (new parts in orange, pulled out the way they go in,
    with arrows) and writes a self-contained page in the Mk1 guide's style. view.html
    gains solid arrows. scene_groups.scad holds the concept-picture groups.
    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
    [scene_atoms.scad, scene_groups.scad]
